TomKuc/ASV1/hardware/geometry_sources/KICAD_LIBRARY_ATTRIBUTION.md

# Biblioteki KiCad

Footprinty i modele wymienione w `imu_rf_geometry.json` pochodzą z oficjalnych bibliotek KiCad10.0.7, autorstwa społeczności KiCad. Zachowano nazwy źródeł, skrótySHA256 i odnośniki producentów.

Licencja: **Creative Commons Attribution-ShareAlike4.0**, z dodatkowym wyjątkiem KiCad dla projektów elektronicznych i generowanych plików.

- Zasady i tekst wyjątku: https://www.kicad.org/libraries/license/
- Tekst licencji: https://creativecommons.org/licenses/by-sa/4.0/legalcode
- Źródła footprintów: https://gitlab.com/kicad/libraries/kicad-footprints
- Źródła modeli: https://gitlab.com/kicad/libraries/kicad-packages3D

Adaptacje w tym projekcie: lokalne ścieżki modeli; U4: miedź0.575×0.35mm, pasta-0.05 i centralny TOP keepout. Dokumentacja: `docs/footprint_review.md`.
