TomKuc/ASV1/docs/audit_A1_2026-10-29.md

# Ankle Sensor V1 — audyt A1, 29.10.2026

**Dokument historyczny poprzedniego audytu.** Bieżące źródła, wyniki i warunki zamówienia określa [końcowa weryfikacja](final_verification_A1.md).

**Stan: A1 AUDIT REVIEW. Nie jest to zwolnienie do produkcji ani wynik testów urządzenia. Pamięć pozostaje W25Q01JVZEIQ 128 MiB.**

Punkt odniesienia to repozytorium [TomKuc/ASV1](https://github.com/TomKuc/ASV1), commit `c353696`, oraz poprowadzona płytka SHA256 `b5487d09753bbf0490bf91bda6c803934609b778283ef87c044309bc1514f678`. Zabezpieczenie: [archiwum sprzętu](../reports/baselines/A1_routed_before_audit_2026-10-29.zip) i [manifest](../reports/baselines/A1_before_audit_manifest.json). Nie uruchamiano destrukcyjnego odtwarzania PCB. Oryginalne A0/A1 ZIP zachowano.

Końcowe hashe i natywne wyniki są w [validation_status.json](../reports/validation_status.json). Zmiany w źródłach, raportach i eksportach wymienia [audit_changed_files.txt](../reports/audit_changed_files.txt). Identyfikator przygotowanego commita podaje `reports/commit_delivery.json`, dostarczany obok ZIP/Git bundle po zapisaniu historii; główny `.git` jest w tym środowisku chroniony przed zapisem. [Instrukcja importu](git_delivery_A1.md) wyjaśnia tę formę przekazania. Bundle i plik z jego hashem nie są rekurencyjnie dołączane do własnego commita ani ZIP.

## Ocena zgłoszonych zagadnień

Ważność H oznacza wpływ na ładowanie, integralność danych lub interfejs; M oznacza ryzyko produkcyjne albo utrzymania projektu. Nie każda pozycja H jest wykrytym błędem elektrycznym.

| ID / ważność / lokalizacja | Ustalenie | Decyzja i dowód |
|---|---|---|
| MEM01 H — U5 / nRF QSPI | Organizacja2×64MiB, liniowe128MiB, zakres0…07FFFFFF i zgodny mechanizm czterobajtowy potwierdzone dokumentami. | Zachowano dokładny MPN, footprint, pinout i3V. [Audyt Flash](flash_compatibility_A1.md), Winbond RevE i Nordic QSPI. Nie oznacza kwalifikacji docelowego drivera. |
| MEM02 H — sterownik Flash | Odczytany Zephyr/nrfx nie ma gotowej polityki obu dies; samo ADDRMODE32 nie zamyka SR/BUSY/WEL i operacji globalnych. IQ ma QE stałe1. | Własna serializowana warstwa, bez XIP na czas sterowania pamięcią; jawne per-die statusy i rozróżnienie READY od zakończenia zapisu. [Architektura i źródła](flash_compatibility_A1.md). |
| MEM03 H — C2/reset/DPD | Datasheet wymienia C2+Die ID; bajty00/01 i polling obu dies potwierdza primary implementacja Linuxv6.17. Pełna AN0000035 nadal niepozyskana. | Nie podano nieudokumentowanej gwarancji resetu ani selekcji w busy. Wymagane wyjaśnienie producenta i20 prób [F01–F20](flash_firmware_test_plan_A1.md), wszystkie NOT_RUN. |
| USB01 H — U3.28/30/31/32 | VDD=VDDH=3V, DCCH NC i osobny VBUS są właściwe dla normal voltage mode/niewykorzystanego REG0. | Brak zmiany topologii. Nordic POWER i oficjalne wsparcie; pełny obraz Raytac§8.3/capy pozostaje do sprawdzenia. [Raport](usb_raytac_audit_A1.md). |
| USB02 M — D+/D− | Nie potwierdzono zarzutu braku wymaganych zewnętrznych rezystorów USB; nRF52840 zawiera je w PHY. | Nie dodawano przypadkowych22/27Ω. Oficjalne wyjaśnienie Nordic w [raporcie USB](usb_raytac_audit_A1.md). |
| USB03 H — U6/J1 | Poprawna pinmapa kanałów ESD; w bazie długie18.7/20.6mm odcinki przed ochroną. To słabość layoutu, bez deklaracji sztywnego limitu mm. | Przesunięto U6/R25 i lokalne końcówki USB. Przed ESD jest teraz12.997/15.552mm; koszt to dodatkowe2vias DP_CONN. Nadal wymagana kwalifikacja ESD/SI; ST USBLC6-2§2.3. |
| USB04 H — stackup / cały tor USB | Oferta4L/1mm istnieje, lecz zastany PCB ma ogólny stos KiCad. Nie ustalono90Ω na konkretnej konstrukcji JLC. | Nie wpisano zgadywanych dielektryków. Wymagana oferta stackupu i ocena całego toru. [Raport USB](usb_raytac_audit_A1.md), [return path](usb_layout_review.md). |
| IMU01 M — docs vs U4/U3 | Potwierdzony błąd dokumentacji: wcześniejsze P0.24/25 nie odpowiadało PCB. | INT1=U3.27/P0.11, INT2=U3.29/P0.12. Poprawiono dokumenty, bez zmiany tras. [Ostateczne61padów](pin_assignment_A1.md). |
| DFM01 M — U5.7 |0.090001mm było prawdziwym nominalnym odstępem, bez nominalnego overlap. Mała rezerwa procesu jest ryzykiem, nie dowodem zwarcia. | Via przesunięta o0.14mm; odstęp0.230001mm. Analogiczne miejsce J1 VBUS poprawiono0.105→0.175mm. [Geometria i źródła JLC](dfm_audit_A1.md). |
| CHECK01 M — profil DRC | Pięć klas było ignorowanych; po włączeniu wykryto11 off-center endpoint warnings. | Lokalne dopasowania końców≤0.071mm; wszystkie klasy pozostają aktywne. Żadnego pełnego reroutingu. [Przegląd każdej klasy](erc_drc_audit_A1.md). |
| CHECK02 M — profil ERC/U4.2/3 | Cztery ignorowane klasy ERC nie ujawniły kolejnych problemów. Dwa widoczne ostrzeżenia IMU są właściwe dla mode1 z wyłączonym Qvar/analog hub. | Wszystkie klasy aktywne; nie wyciszano ostrzeżeń ani nie zmieniano typu pinów. ST DS13511 tabela2/§7.1 i [raport kontroli](erc_drc_audit_A1.md). |
| PWR01 H — U4/U5 / PDN | Lokalne drogi odsprzęgania zweryfikowano na rzeczywistym Cu; mostek Flash B.Cu z wcześniejszej A1 jest obecny. | Nie usunięto mostka ani kondensatorów. To geometria i ciągłość, nie pomiar ripple. [Audyt zasilania](power_audit_A1.md). |
| PWR02 H — R24/Q2/CE | Bazowy pull-down pozwalał na zwolnienie inhibit po resecie/HiZ MCU, co osłabiało politykę USB suspend. | R24=100k przeniesiony z GND na3V0. HIGH/HiZ/reset blokuje; LOW zwalnia do U7/U8. Cena: brak autonomicznego ładowania przy niesprawnym MCU. U7/U8 pozostają nadrzędne. [Raport](power_audit_A1.md). |
| PWR03 H — cały USB VBUS | ILIM100mA BQ nie ogranicza bezpośredniej gałęzi VBUS modułu ani gwarantowanego sumarycznego prądu portu. | Pozostaje pełny budżet, enumeracja/suspend/inrush i jawna polityka adapterów. Timeout nie oznacza DCP/BC1.2. [Kontrakt FW](firmware_contract.md). |
| PWR04 H — timer / NTC |360min jest wartością typową; CE może restartować timer. Część22mV budżetu komparatora jest założeniem, nie gwarantowanym maksimum CMRR/PSRR. | Poprawiono twierdzenia i opis obliczeń. Nie resetować timera cyklicznie. Potrzebna kwalifikacja dokładnego pakietu/NTC i progów. [Źródła TI i założenia](power_audit_A1.md). |
| PWR05 M — pobór okna | Oczekiwane138µA w standby oznacza około3.32mAh/dobę; jest to oszacowanie, nie stały pobór we wszystkich trybach. | Ochronę zachowano. Koszt uznano za uzasadniony dla A1; podczas USB LOW/release dochodzi prąd pull-up. [Bilans stanów](power_audit_A1.md). |
| RF01 H — antena / bateria | Keepout na wszystkich warstwach jest sprawdzalny w CAD; położenia pakietu i obudowy nie ma w zespole. | Końcowy natywny odczyt wypełnień potwierdził0mm² naruszeń. Dalej RF na nodze. Bateria/metal poza anteną; nie wydano certyfikatu RF. [Raport](usb_raytac_audit_A1.md). |
| MECH01 M — U4 / mocowanie | Poprawna geometria odległości i centralny TOP keepout nie jest analizą naprężeń. | Sztywne podparcie bez docisku IMU; kwalifikacja po reflow i zamknięciu obudowy. USB-C3D nadal brak, Raytac generyczny. [Ograniczenia mechaniczne](mechanical_model_review.md). |

## Co zostało naprawione

- Ujednolicono pinmapę przerwań IMU z rzeczywistym schematem i PCB.
- Włączono wszystkie wcześniej ignorowane klasy ERC/DRC i wycentrowano11 końców ścieżek przy istniejących przelotkach.
- Lokalnie odsunięto dwa istniejące via przy Flash i USB; bez zmiany MPN, padów układów i średnic wiercenia.
- R24 zmieniono na pull-up, aby MCU reset/HiZ zachowywał blokadę ładowania.
- Poprawiono zbyt kategoryczne interpretacje timera, budżetu komparatora, standby i zgodności standardowego sterownika Flash.

Przyjęto lokalny wariant USB: U6=(71.6,93.3), R25=(74.8,92.2). Niezależny odczyt potwierdził skrócenie odcinków przed ESD o30.6%/24.4% i lokalnej drogi GND U6 do via do0.938mm z połączeniem do In1. Dodatkowe2vias na DP_CONN są kosztem tej zmiany. Nie jest to potwierdzenie odporności IEC ani impedancji. Główny przebieg USB do y=86.8 zachowano; poza opisanymi poprawkami nie odtwarzano całego routingu. [Dziennik scalania](../reports/audit_merge_final_A1.json): poprawki root20 zmodyfikowanych obiektów Cu i R24, wariant USB111 usuniętych/2 zmodyfikowane/145 dodanych obiektów Cu oraz przesunięcie U6/R25. Finalnie164 przelotki. Dokument wejściowego placement poprawiono również dla obrotu Y1, aby zgadzał się z istniejącym PCB.

## Wyniki po scaleniu

KiCad10.0.7 wykonał natywne ERC i DRC po refill/save z kontrolą zgodności schemat–PCB. **ERC:0 błędów,2 uzasadnione ostrzeżenia; DRC:0 naruszeń/ostrzeżeń,0 niepołączonych elementów,0 rozbieżności schemat–PCB. Brak ignorowanych klas.** Ponowny audyt164 przelotek/255 padów Cu/243 apertur pasty:0 przecięć, minimum0.150001mm. Native RF fill:0mm² w zadeklarowanym keepout. Eksporty zawierają11 Gerberów,2 Excellon oraz59 pozycji montowanych na TOP; współrzędne/rotacje,164 wiercenia via,4 sloty PTH i2 NPTH porównano z natywnym PCB. To kontrola spójności plików, nie niezależny CAM ani akceptacja fabryki. PDF/STEP/render zostały odświeżone; STEP jawnie pozostaje niekompletny. [Walidacja](../reports/validation_status.json), [eksport](../manufacturing/review/export_manifest.json), [porównanie produkcyjne](../reports/manufacturing_geometry_review.json).

## Kontrole dostępne teraz i próby po wykonaniu prototypów

| Teraz — dokumentacja/CAD/pliki | Po otrzymaniu prototypów |
|---|---|
| Natywny ERC/DRC, zgodność schemat–PCB i manifestu |20 testów Flash F01–F20, identyfikacja, aliasing16/32/64/128MiB, CRC, erase obu dies, power-cut |
| Nominalne Cu/paste/mask i geometria wierceń | Pomiar VCC, ripple, tętna obciążenia, progu zakończenia zapisu przed2.7V |
| Obecność odsprzęgania i lokalne drogi zapisanej miedzi | Reset MCU i Flash, wake/DPD, watchdog podczas program/erase |
| Keepout RF i przestrzeń IMU w istniejącym PCB | ODR/FS/filtry/FIFO, temperatura IMU, zgubione próbki i synchronizacja dwóch nóg |
| Eksport Gerber/Drill/CPL oraz porównanie współrzędnych z PCB | Cały USB: prąd we wszystkich stanach, suspend/inrush, transfer z CRC, ESD i jakość sygnału |
| Spójność BOM z59 pozycjami montażowymi; publiczny katalog JLC | Pakiet/PCM/NTC, zwarcie/przerwa NTC, startup/brownout, ładowanie i termika w obudowie |
| Obliczenie warunkowego modelu temperatury, bez symulacji SPICE | Szum/bias MEMS, naprężenia po montażu, zasięg BLE i praca w opasce |

Nie wykonano testu sprzętowego ani symulacji działania całego urządzenia. Syntetyczne testy API geometrii i obliczenia statyczne są odrębnym rodzajem dowodu.

## Gotowość do dalszego przeglądu i zamówienia

Paczka ma służyć **niezależnemu przeglądowi inżynierskiemu oraz DFM/PCBA JLCPCB** z jawną listą ograniczeń. Nie wolno utożsamiać akceptacji plików przez stronę zamówienia z poprawnością układu ani integralnością danych.

Przed decyzją o montażu prototypów: uzyskać konkretny stackup i ocenę toru USB; porównać rysunki Raytac§8.3 i footprintów/capów; potwierdzić dokładny BOM i dostępność, panelizację/fiducjale, maskę/szablon i rotacje. [Stan publicznych katalogów](component_availability_A1.md) wskazuje dla IMU Standard Only i X-ray; Raytac i BQ nie mają potwierdzonej rezerwacji. Nie dobrano zamienników.

Plan F01–F20 nie może zostać zamknięty bez prototypów. Utrzymanie128MiB jest świadomą decyzją z warunkiem własnej warstwy sterownika i pozyskania AN0000035/wyjaśnienia Winbond. Można prowadzić przegląd DFM równolegle do tej pracy; nie ma podstaw do deklaracji pełnej gotowości urządzenia do badań lub seryjnej produkcji.
