TomKuc/ASV1/docs/memory_upgrade.md

# Większa pamięć bez zwiększenia obrysu PCB — 2026-10-27

Rekomendowany kandydat dla aktualnego projektu: **W25Q01JVZEIQ, 1 Gbit = 128 MiB, JLCPCB C5137036**. Pamięć ma korpus 8 × 6 mm, a więc mieści się w tej samej rezerwacji powierzchni co W25Q512JVEIQ. Publiczny katalog JLCPCB potwierdza montaż Economic and Standard, MSL3 i pokazał 264 sztuki / 260 dostępnych do zamówienia przy cenie jednostkowej około 36,48 USD. To odczyt katalogu, bez rezerwacji ani wyceny konkretnego zamówienia. [JLCPCB C5137036](https://jlcpcb.com/partdetail/WinbondElec-W25Q01JVZEIQ/C5137036), [LCSC C5137036](https://www.lcsc.com/product-detail/C5137036.html).

Pinout WSON8: 1 /CS, 2 IO1, 3 IO2, 4 GND, 5 IO0, 6 CLK, 7 IO3, 8 VCC. Zasilanie 2,7–3,6 V; QE dla IQ jest ustalone na 1. Rysunek package ZE podaje raster 1,27 mm i mały EP 3,40 × 4,30 mm, który może pozostać niepodłączony albo być połączony z GND. Pamięć obejmuje dwie matryce 512 Mbit z liniowym adresem 0x00000000–0x07FFFFFF. Obsługuje EN4B 0xB7 i instrukcje 0x6B / 0x32 z czterobajtowym adresem, zgodne z zestawem nRF52840 QSPI. Pady i wymiary trzeba ponownie porównać z biblioteką; zgodność powierzchni nie zastępuje tego sprawdzenia. [Winbond W25Q01JV Rev C, dokument producenta u LCSC](https://datasheet.lcsc.com/datasheet/pdf/4186e2255e7f268d6b3a94cd6df0aac8.pdf?productCode=C6926235), [nowszy Rev E z 2024-03-04, dokument producenta u Mouser](https://www.mouser.com/datasheet/2/949/Winbond_Electronics_Corporation_09_06_2024_W25Q01J-3501286.pdf).

**To wymaga obsługi dwóch matryc w firmware.** Odczyt BUSY/SUS odnosi się do aktywnej matrycy, a operacje globalne mogą dotyczyć obu. Datasheet zawiera Software Die Select 0xC2 i odsyła do **AN0000035 W25Q01JV SpiFlash Stacked Die Usage**. Oficjalny katalog Winbond oznacza notę jako „contact us”; jej pełnej treści nie pozyskano. Nie deklarować poprawności gotowego sterownika tylko na podstawie obsługi 32-bitowych adresów. [Oficjalny katalog not Winbond](https://www.winbond.com/hq/support/documentation/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), [oficjalne FAQ wskazujące AN0000035](https://www.winbond.com/hq/support/faq/technical/index.html).

Wymóg odbiorczy projektu: sprawdzać oba dies po zapisach statusu i innych operacjach globalnych, testować program/erase/read poniżej i powyżej 0x04000000, po resecie MCU, resetach flash, deep power-down i pełnym power-cycle. Nie korzystać z domyślnego sterownika bez potwierdzenia obsługi tej pamięci. Jako pomocnicze źródło implementacyjne dostępny jest upstreamowy sterownik Linux rozpoznający liczbę matryc oraz wybierający matryce do sprawdzenia statusu; nie jest to sterownik nRF52840. [Źródło Linux spi-nor/winbond.c](https://kernel.googlesource.com/pub/scm/linux/kernel/git/next/linux-next/+/ba80ab075acc1d265df25a2de31dfb358ca2ad44/drivers/mtd/spi-nor/winbond.c).

Obliczenie pojemności, bez gwarancji użytkowej: przy 1920 Hz i 12 B na próbkę 128 MiB wystarcza na 97,1 min; przy 14 B/próbkę na około 83,2 min przed temperaturą, timestampami, nagłówkami, CRC, rezerwą i dziennikiem. Każda noga ma własną pamięć o tej pojemności.

## Kandydaci 256 MiB

| Układ | Wynik weryfikacji |
|---|---|
| W25Q02JVTBIM | 2 Gbit = 256 MiB, ale potwierdzony wariant TFBGA24, nie zamiana do WSON8. [Datasheet producenta przez MikroE](https://download.mikroe.com/documents/datasheets/W25Q02JV%20Datasheet.pdf) |
| **W25Q02JVSFIM** | **256 MiB, SOIC16 300 mil**, rzeczywisty wariant wymieniony w nowszym datasheet producenta Rev C z 2023-03-29, s. 109; tę obudowę dodano w tej rewizji. Raster 1,27 mm, korpus typ. 10,31 ×7,49 mm, szerokość z wyprowadzeniami typ. 10,31 mm, wysokość maks. 2,64 mm (s. 106). **Numeru JLCPCB/LCSC C nie potwierdzono** mimo wyszukiwania dokładnego MPN i wariantu TR. Nie wpisywać zgadywanego numeru do BOM. [Dokument Winbond Rev C przez Marthel](https://www.marthel.pl/katalog/W25Q02JV_DTR%20RevC%2003292023.pdf) |
| MT25QL02GCBB8E12-0SIT | Oficjalny katalog Micron podaje TBGA 6 × 8 × 1,2 mm i cztery komponenty wewnętrzne; oznaczenie 8E12 nie oznacza obudowy WSON8. [Micron](https://in.micron.com/products/storage/nor-flash/serial-nor/part-catalog/part-detail/mt25ql02gcbb8e12-0sit) |
| W25Q02RVZHJQ / W25Q02RVZHJM | Nowa seria oferuje 2 Gbit w VSON8 8 × 6 mm. Wariant **ZH** trzeba zweryfikować mechanicznie i elektrycznie; brak potwierdzonego numeru JLCPCB/LCSC i dostępnego zapasu w tym przeglądzie. To perspektywa dalszego doboru, nie zamawialny zamiennik w aktualnym BOM. [Oficjalny Winbond RV product brief 2026](https://www.winbond.com/productResource-files/Winbond%20W25Q-RV%20Series%20Flash%20Product%20Brief%202026.pdf), [datasheet Winbond Rev E 2026-02-12 przez DigiKey, tabela p196](https://mm.digikey.com/Volume0/opasdata/d220001/medias/docus/8919/W25Q33_64_12_25_51_01_02RV-DTR_RevE.pdf) |

Nie zastępować NOR pamięcią SPI NAND tylko dlatego, że ma podobną obudowę lub pojemność. NAND wymaga innego zestawu poleceń, pracy stronicowej, ECC i obsługi złych bloków; nie jest przezroczystym zamiennikiem dla tej architektury QSPI NOR. W tym przeglądzie nie potwierdzono zamawialnej 256 MiB NOR z pełną zgodnością obecnego footprintu WSON8.

Większa obudowa SOIC16 **nie przesądza o konieczności powiększenia PCB 50 ×28 mm**. Wymaga próbnego rozmieszczenia, własnego footprintu i innego mapowania pinów, a także sprawdzenia wysokości w obudowie. W25Q02JVSFIM: 1 IO3, 2 VCC, 3 /RESET, 4–5 NC, 6 DNU, 7 /CS, 8 IO1, 9 IO2, 10 GND, 11 DNU, 12–14 NC, 15 IO0, 16 CLK. Piny DNU pozostawić bez połączenia. Układ ma cztery matryce po 64 MiB i liniową przestrzeń 0x00000000–0x0FFFFFFF, lecz ciągły odczyt ograniczono do poszczególnych segmentów 64 MiB; firmware musi dzielić odczyty na ich granicach i obsługiwać stan każdej matrycy. Parametry zasilania 2,7–3,6 V pasują do szyny 3,0 V. To kandydat dalszego doboru po potwierdzeniu zakupów, bez zatwierdzonej zgodności sterownika nRF52840. [Winbond Rev C, s. 6, 8 i 106](https://www.marthel.pl/katalog/W25Q02JV_DTR%20RevC%2003292023.pdf).
