TomKuc/ASV1/docs/router_limitations.md

# Router pomocniczy KiCad — 2026-10-28

`scripts/route_pcb.py` zapisuje rzeczywiste obiekty ścieżek i przelotek przez API `pcbnew` KiCad 10.0.7. To narzędzie do przygotowania części routingu, bez gwarancji pełnego połączenia płytki ani poprawności DRC.

```sh
KICAD_CONFIG_HOME=/tmp/ankle-kicad-route /Applications/KiCad/KiCad.app/Contents/Frameworks/Python.framework/Versions/3.9/bin/python3 -B scripts/route_pcb.py INPUT.kicad_pcb OUTPUT.kicad_pcb --stats reports/routing.json --plane-net GND --plane-net +3V0 --max-seconds 600
```

`--plane-net` podaje się osobno dla każdej sieci, która ma być połączona przez rzeczywiste strefy miedzi. Domyślnie jest to tylko GND. Router przygotowuje połączenie padu z przelotką; **nie tworzy i nie wypełnia stref**. Bez stref i ich późniejszego wypełnienia takie połączenia pozostają niekompletne. Przelotka może być wykorzystana ponownie; otwartych przelotek w padach nie stosuje się.

Parametry domyślne: siatka 0,10 mm, clearance 0,15 mm, ścieżka 0,15 mm, przelotka 0,50 mm z otworem 0,25 mm, odstęp miedź–krawędź 0,30 mm. Odstęp krawędź–krawędź otworów wynosi co najmniej **max(0,25 mm, minimum projektu)**, również dla tej samej sieci. Dla dwóch nowych otworów Ø0,25 mm daje to odległość osi ≥0,50 mm. Używa się natywnych kształtów otworów, obejmujących również sloty. Identyczna istniejąca przelotka może być ponownie użyta; nie wykonuje się drugiego otworu w tej samej pozycji. Kontrola obejmuje także pary nowych przelotek jednej proponowanej trasy. **Nie naprawia to wcześniejszych zbyt bliskich otworów w wejściowym PCB.** Są to parametry algorytmu, nie potwierdzony stackup lub wycena producenta. Router porównuje je z załadowanymi minimalnymi ograniczeniami i ostrzega w JSON o konfliktach. Nie zmienia reguł `.kicad_pro`. DRC należy wykonywać z właściwym projektem i regułami także po zmianie nazwy pliku wyjściowego.

VBUS, VSYS i VBAT mają domyślnie preferowaną szerokość **0,30 mm**. Przy padzie węższym niż ta wartość pierwsze/ostatnie **0,50 mm** trasy zachowuje podstawowe 0,15 mm. Dalsze fragmenty są poszerzane wyłącznie po sprawdzeniu natywnej geometrii i odstępu od krawędzi. Fragment, którego nie można poszerzyć, pozostaje 0,15 mm i jest zapisany jako `power_width_fallbacks`; raport zawiera długości per sieć i szerokość. To preferencja bez gwarancji pełnej szerokości magistrali zasilania. Możliwe ustawienia: `--preferred-width VBUS=0.30`, `--preferred-width VSYS=0.30`, `--preferred-width VBAT=0.30`, `--neckdown-length 0.50` oraz `--hole-clearance 0.25`.

Sygnały prowadzone są wyłącznie na F.Cu, B.Cu oraz In2.Cu. In1.Cu pozostaje przeznaczona na masę; przez nią przechodzą zwykłe przelotki, a strefa GND musi otrzymać prawidłowe antypady. Zastosowano rzeczywiste stałe API KiCad 10: F.Cu=0, B.Cu=2, In1.Cu=4, In2.Cu=6. Nie tworzy się ścieżek na In1.Cu.

Przeszkody obejmują kształty padów, NPTH, istniejące ścieżki i przelotki innych sieci, granicę rzeczywistego zamkniętego obrysu, keepouty płytki i footprintów. **In2.Cu jest mieszana: sygnały i zasilanie.** Jej zwykła strefa zasilania nie blokuje routingu; natywne ponowne wypełnienie tworzy wymagane prześwity. Istniejące zwykłe strefy na F.Cu/B.Cu nadal blokują ścieżki innych sieci. Wszystkie rzeczywiste pady, ścieżki, przelotki oraz keepouty pozostają przeszkodami również na In2. Warstwy masy i zasilania wymagają późniejszego wypełnienia i ponownej kontroli łączności. Obszary niedopuszczające ścieżek/przelotek są respektowane według flag KiCad. Raster zawiera konserwatywny zapas od połowy przekątnej komórki, a proponowane odcinki są dodatkowo sprawdzane z natywną geometrią przed zapisem.

**Hole-to-copper jest osobnym ograniczeniem:** router odczytuje `m_HoleClearance` z projektu i stosuje ten prześwit względem rzeczywistego kształtu otworu, niezależnie od clearance sieci. Dotyczy to także przelotek i poszerzonych ścieżek oraz każdego poziomu miedzi przecinanego przez otwór. NPTH zawsze blokuje miedź; połączenia tej samej sieci z metalizowanym otworem są dozwolone. Kontrola drill-to-drill pozostaje niezależna i obowiązuje także tę samą sieć.

Router może rozpoczynać i kończyć wyszukiwanie również w miedzi przelotek **już połączonych z danym padem**, co potwierdza natywne `GetConnectedItems(pad)`. Nie wystarcza sama zgodność nazwy sieci. W takim przypadku zachowuje istniejące wyjście z padu i **nie rysuje skrótu od środka padu do kotwicy**. Pozwala to wykorzystać wcześniej przygotowane wyjścia z drobnych padów, nawet gdy konserwatywny raster blokuje ich środki. Użyte kotwice zapisuje w `connected_via_anchor_uses`. Każda nowa przelotka ma ustawione zakrycie soldermaską z obu stron; istniejących przelotek narzędzie nie zmienia.

Pozycje kandydatów przelotek do stref są buforowane jako offsety w porządku `(d², dx, dy)`. Sprawdzanie kończy się po znalezieniu pierwszych 24 legalnych pozycji, zachowując ten sam wybór co pełne skanowanie i późniejsze sortowanie całego promienia 3 mm.

Niektóre wyjścia z drobnych padów mogą być nieosiągalne na siatce 0,10 mm, mimo że ręczny routing jest możliwy. Dla U1 (pady 0,20 mm, raster 0,40 mm, ścieżka 0,15 mm i clearance 0,15 mm) środek trasy ma korytarz ±0,075 mm wokół osi padu. Konserwatywny guard siatki 0,10/√2 ≈0,0707 mm ogranicza go do około ±0,0043 mm. Przy siatce 0,05 mm zostaje około ±0,0396 mm, co ułatwia wyjście. Liczba stanów na tej samej powierzchni rośnie wtedy około czterokrotnie; limit rozwinięć należy odpowiednio zwiększyć, np. `--max-expansions 720000`. Narzędzie nie wykonuje shove, rip-up, optymalizacji długości, kontroli par różnicowych, impedancji, RF ani prądów zasilania. USB i QSPI wymagają przeglądu projektanta. Automatyczne pierwszeństwo tych sieci w kolejce nie jest ich kwalifikacją sygnałową.

Raport zawsze zawiera status `PARTIAL_REQUIRES_KICAD_DRC_AND_REVIEW`, każdą próbę połączenia, powód niepowodzenia, pozostałe rozłączne grupy padów, niepołączone wyjścia do stref oraz natywną liczbę airwire przed i po routingu **przed ponownym wypełnieniem stref**. Nie należy utożsamiać braku airwire z brakiem błędów DRC. Wejściowego PCB nie wolno nadpisać tym samym wywołaniem.

Wykonane sprawdzenia narzędzia: sześć testów wyszukiwania/planowania; osobna syntetyczna płytka `/tmp` z połączeniem dwóch padów; wariant z barierą na F.Cu wymagający dwóch przelotek i z dodatkowym wyjściem GND. Natywna łączność potwierdziła połączenie sygnału, a ponowny przebieg dodał zero duplikatów. DRC pierwszej syntetycznej płytki wykazał domyślne ograniczenie ścieżki 0,20 mm wobec zadanych 0,15 mm oraz opis przy krawędzi; nie wykazał zwarć, błędów odstępów ani niepołączonego sygnału. Dodatkowy natywny test otworów same-net odrzucił odległości osi 0,30/0,40 mm i dopuścił 0,50/0,60 mm oraz ponowne użycie istniejącej przelotki. Test zasilania z wąskim padem utworzył około 0,50 mm ścieżki 0,15 mm i resztę 0,30 mm, z zachowaniem natywnej łączności. Nie są to wyniki kontroli płytki Ankle Sensor.

`scripts/test_route_pcb_native.py` zawiera dodatkowe sześć testów: rzeczywiste wyjście pad→dogleg→via z zablokowanym skrótem, zwykłe pady, odrzucenie niepołączonej przelotki tej samej sieci jako kotwicy, identyczność kolejności zoptymalizowanych kandydatów, osobny hole-to-copper przy NPTH oraz dopuszczenie sygnału w zwykłym pour In2 przy zachowaniu keepoutu. Test NPTH odrzuca rzeczywisty odstęp 0,225 mm i dopuszcza 0,275 mm przy minimum 0,25 mm; wygenerowana trasa omija otwór zgodnie z tym ograniczeniem. Test z doglegiem sprawdza zachowanie miedzi istniejącego wyjścia, brak nowego odcinka do środka padu, brak ścieżek na In1.Cu, natywną łączność i tenting nowych vias. Testy budują osobne płytki w pamięci i nie otwierają canonical PCB projektu.
