TomKuc/ASV1/reports/Ankle_Sensor_V1_A1_3d_review.png

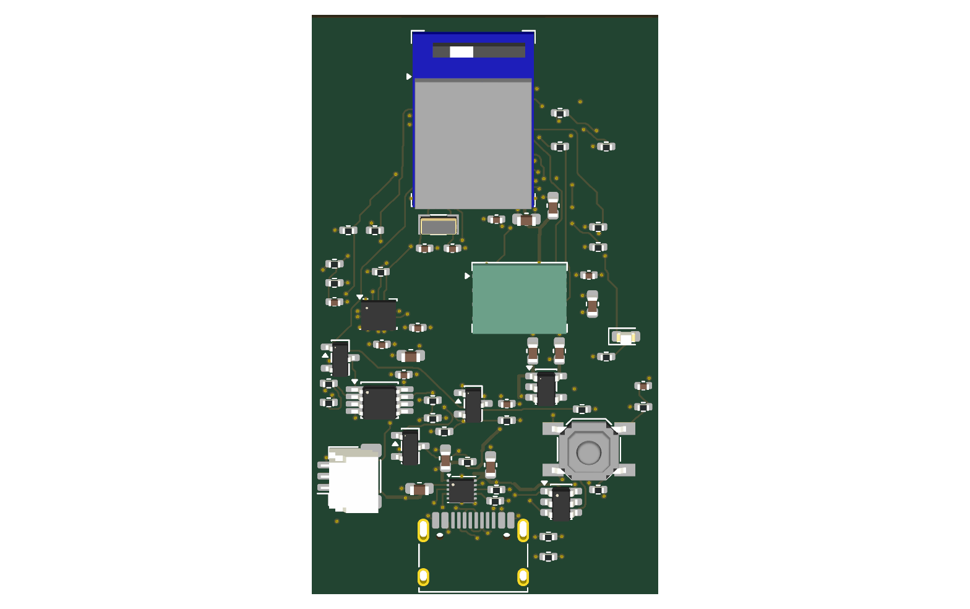
reports/Ankle_Sensor_V1_A1_3d_review.png
