TomKuc/ASV1/hardware/3dmodels/W25Q01JVZEIQ_ENVELOPE_MAX.step

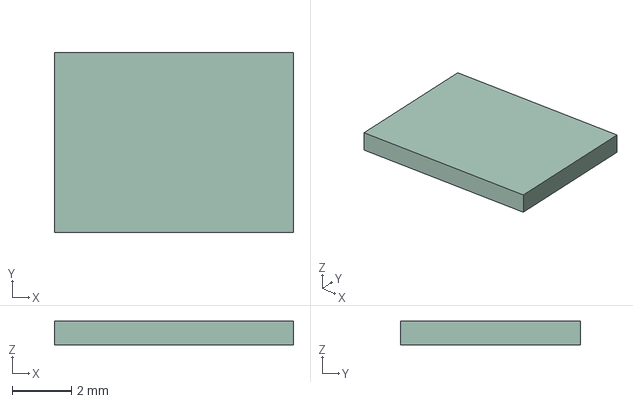
[picture p2: CAD file, 2026-10-29]
hardware/3dmodels/W25Q01JVZEIQ_ENVELOPE_MAX.step
8.10 x 6.10 x 0.8 mm
