TomKuc/ASV1/reports/Ankle_Sensor_V1_A1_mechanical_review.step

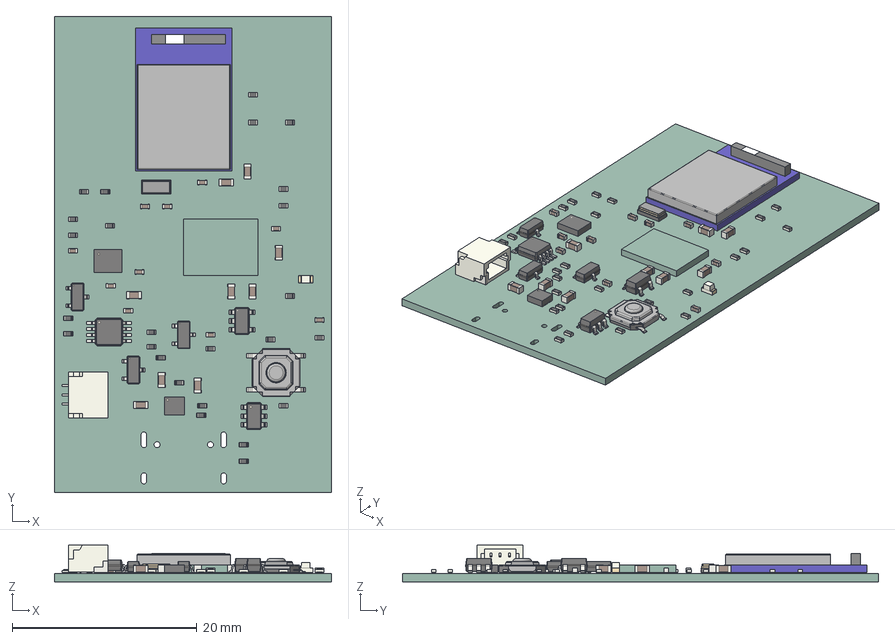
[picture p3: CAD file, 2026-10-29]
reports/Ankle_Sensor_V1_A1_mechanical_review.step
30.0 x 51.6 x 3.96 mm
SOT-23 x 3
C_0603_1608Metric x 9
R_0402_1005Metric x 25
SOT-23-6
VSSOP-8_3x3mm_P0.65mm
LGA_14_3x25mm_P05mm_LayoutBorder3x4y
Raytac_MDBT50Q
C_0402_1005Metric x 10
Texas_DLH0010A_WSON-10-1EP_2.2x2mm_P0.4mm_EP0.9x1.5mm
W25Q01JVZEIQ_ENVELOPE_MAX_PCB
Crystal_SMD_3215-2Pin_3.2x1.5mm
JST_SH_SM03B-SRSS-TB_1x03-1MP_P1.00mm_Horizontal
LED_0603_1608Metric
SOT-23-5
SW_SPST_SKQG_WithStem
Ankle_Sensor_V1_PCB
