TomKuc/ASV1/hardware/3dmodels/Button_Switch_SMD.3dshapes_SW_SPST_SKQG_WithStem.step

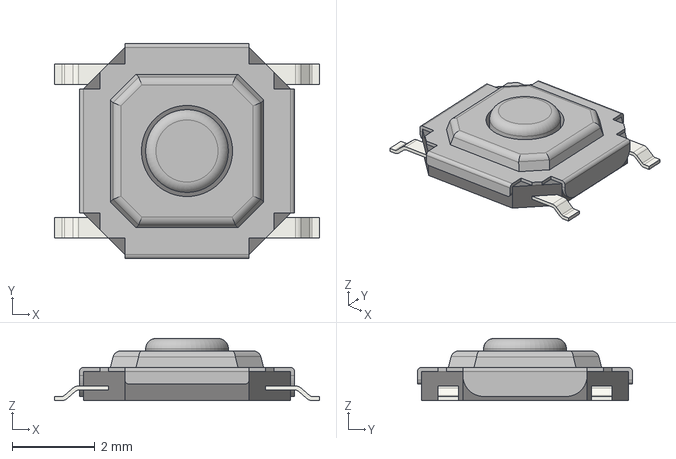
[picture p4: CAD file, 2026-10-29]
hardware/3dmodels/Button_Switch_SMD.3dshapes_SW_SPST_SKQG_WithStem.step
6.40 x 5.20 x 1.50 mm
