TomKuc/ASV1/hardware/3dmodels/Texas_DLH0010A_WSON-10-1EP_2.2x2mm_P0.4mm_EP0.9x1.5mm.step

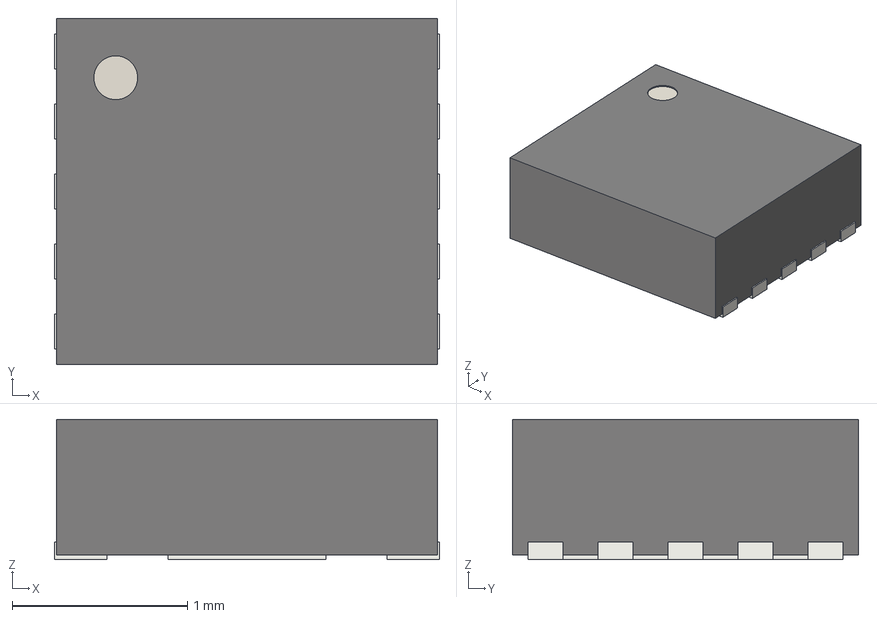
[picture p5: CAD file, 2026-10-29]
hardware/3dmodels/Texas_DLH0010A_WSON-10-1EP_2.2x2mm_P0.4mm_EP0.9x1.5mm.step
2.20 x 1.98 x 0.8 mm
