TomKuc/ASV1/reports/guide/ankle_sensor_przewodnik.html

To jest przewodnik po istniejącym projekcie, bez zmian w elektronice.
Kliknij opis na mapie lub przycisk poniżej, aby przeczytać funkcję elementu. Płytkę ustawiono portem USB na dole.

## Jak czytać projekt

Schemat opisuje elektryczne połączenia. PCB pokazuje fizyczne miejsca części i miedziane połączenia. Widok 3D ułatwia obejrzenie kształtu płytki i dostępnych modeli.

Plik / katalog | Do czego służy
.kicad_pro | Główne wejście do projektu w KiCadzie.
.kicad_pcb | Rozmieszczenie części, ścieżki, warstwy i obrys rzeczywistej PCB.
.kicad_sch | Schemat z blokami zasilania, procesora, sensorów, USB/UI i temperatury.
PDF schematu | Do przeczytania schematu bez uruchamiania KiCada.
BOM | Lista zakupowa części; MPN to oznaczenie producenta, numer C identyfikuje część w katalogu JLCPCB.
CPL / Pick and Place | Współrzędne i obroty części dla maszyny montażowej.
Gerber + Drill | Dane dla fabryki: wzory warstw oraz otwory i sloty.
STEP | Model do programu CAD przy projektowaniu obudowy. Obecny model ma ograniczenia opisane poniżej.

## Oznaczenia, które zobaczysz

U — układ scalony lub moduł; R — rezystor; C — kondensator; J — złącze; SW — przycisk; D — dioda; Q — tranzystor; Y — kwarc; TP — pole testowe. Liczba jest identyfikatorem części, np. U4 lub C15.

GND oznacza masę — wspólny punkt odniesienia napięć. +3V0 to zasilanie 3,0 V. Takie same nazwy sygnałów na schemacie oznaczają tę samą sieć, także pomiędzy arkuszami.

## Co oznacza wynik kontroli

ERC sprawdza reguły schematu, DRC reguły i połączenia PCB, a DFM możliwość wykonania i montażu w konkretnej fabryce. Obecny DRC: 0 naruszeń / 0 brakujących połączeń / 0 rozbieżności schemat–PCB. ERC: 0 błędów i 2 opisane ostrzeżenia IMU.

Stan A1: REVIEW, do dalszego sprawdzenia przed zamówieniem. Wynik DRC nie potwierdza fizycznego działania. Firmware jeszcze nie ma. Otwarte są m.in. przegląd zasilania referencyjnego Raytac, stackup i tor USB, kwalifikacja footprintów/DFM, dobór pakietu oraz testy prototypu. W STEP i renderze brakuje bryły USB-C; model Raytac jest ogólny, a Flash ma model gabarytowy.

Pełna lista warunków · Instrukcja widoku 3D KiCad (https://docs.kicad.org/10.0/en/pcbnew/pcbnew.html#threed-viewer)

Źródło położeń: odczyt rzeczywistego PCB A1; SHA256 cdcbd23449ce12977567ecdd061c598cc0dc2830e28d7cea8fada4b1bcea9e40 . Nowy przewodnik nie zmienia płytki ani wcześniejszej paczki A1 REVIEW.
