TomKuc/ASV1/reports/guide/mapa_plytki.png

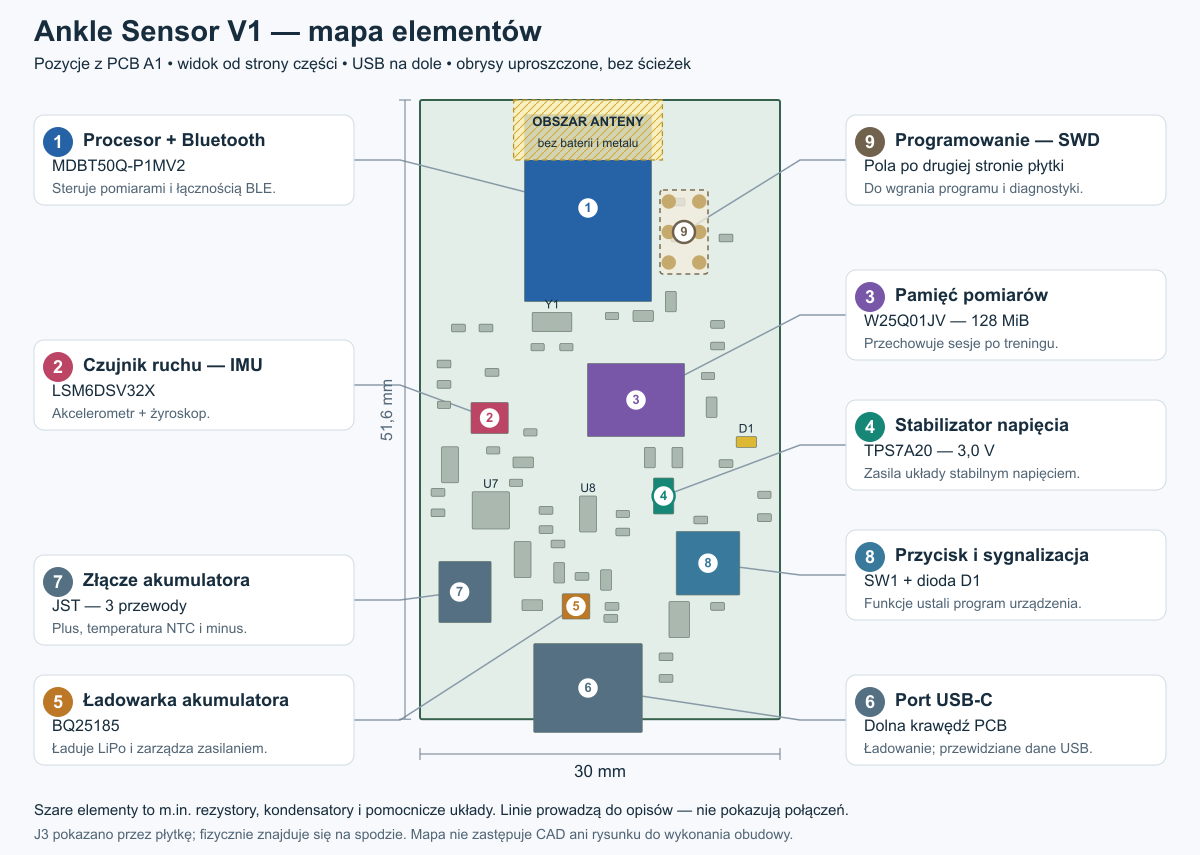
reports/guide/mapa_plytki.png
