TomKuc/ASV1/reports/Ankle_Sensor_V1_A1_schematic.pdf

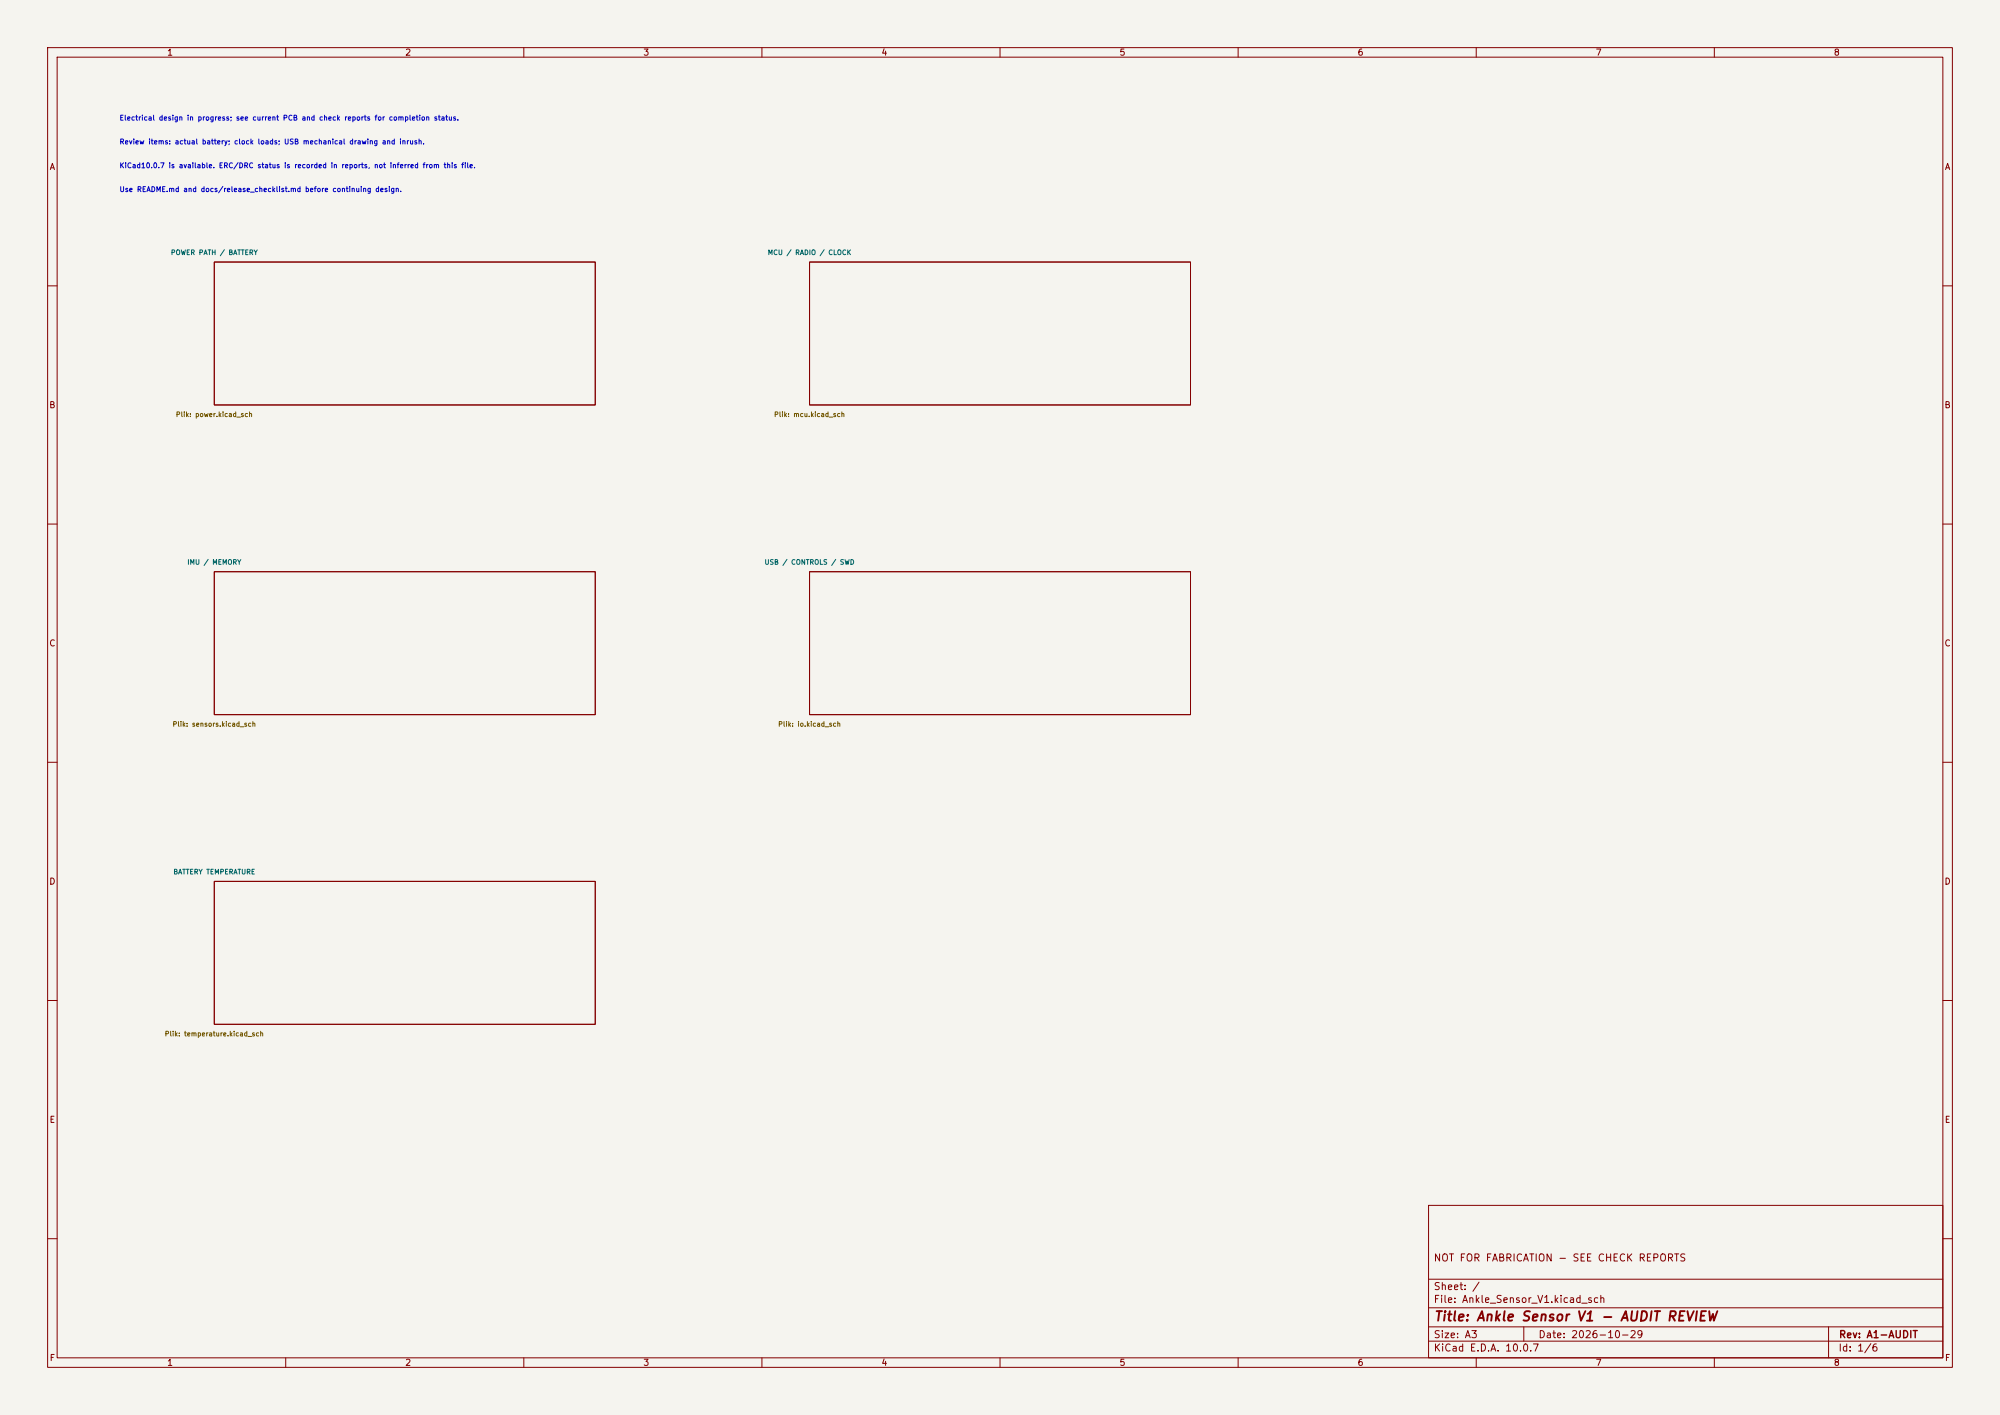
[picture p7: page 1]

Electrical design in progress; see current PCB and check reports for completion status. Review items: actual battery; clock loads; USB mechanical drawing and inrush. KiCad10.0.7 is available. ERC/DRC status is recorded in reports, not inferred from this file. Use README.md and docs/release_checklist.md before continuing design.

Plik: mcu.kicad_sch USB / CONTROLS / SWD

IMU / MEMORY Plik: sensors.kicad_sch BATTERY TEMPERATURE Plik: temperature.kicad_sch

NOT FOR FABRICATION - SEE CHECK REPORTS

Sheet: /
File: Ankle_Sensor_V1.kicad_sch
Title: Ankle Sensor V1 - AUDIT REVIEW

Size: A3 | Rev: A1-AUDIT | F Date: 2026-10-29
KiCad E.D.A. 10.0.7 | Id: 1/6

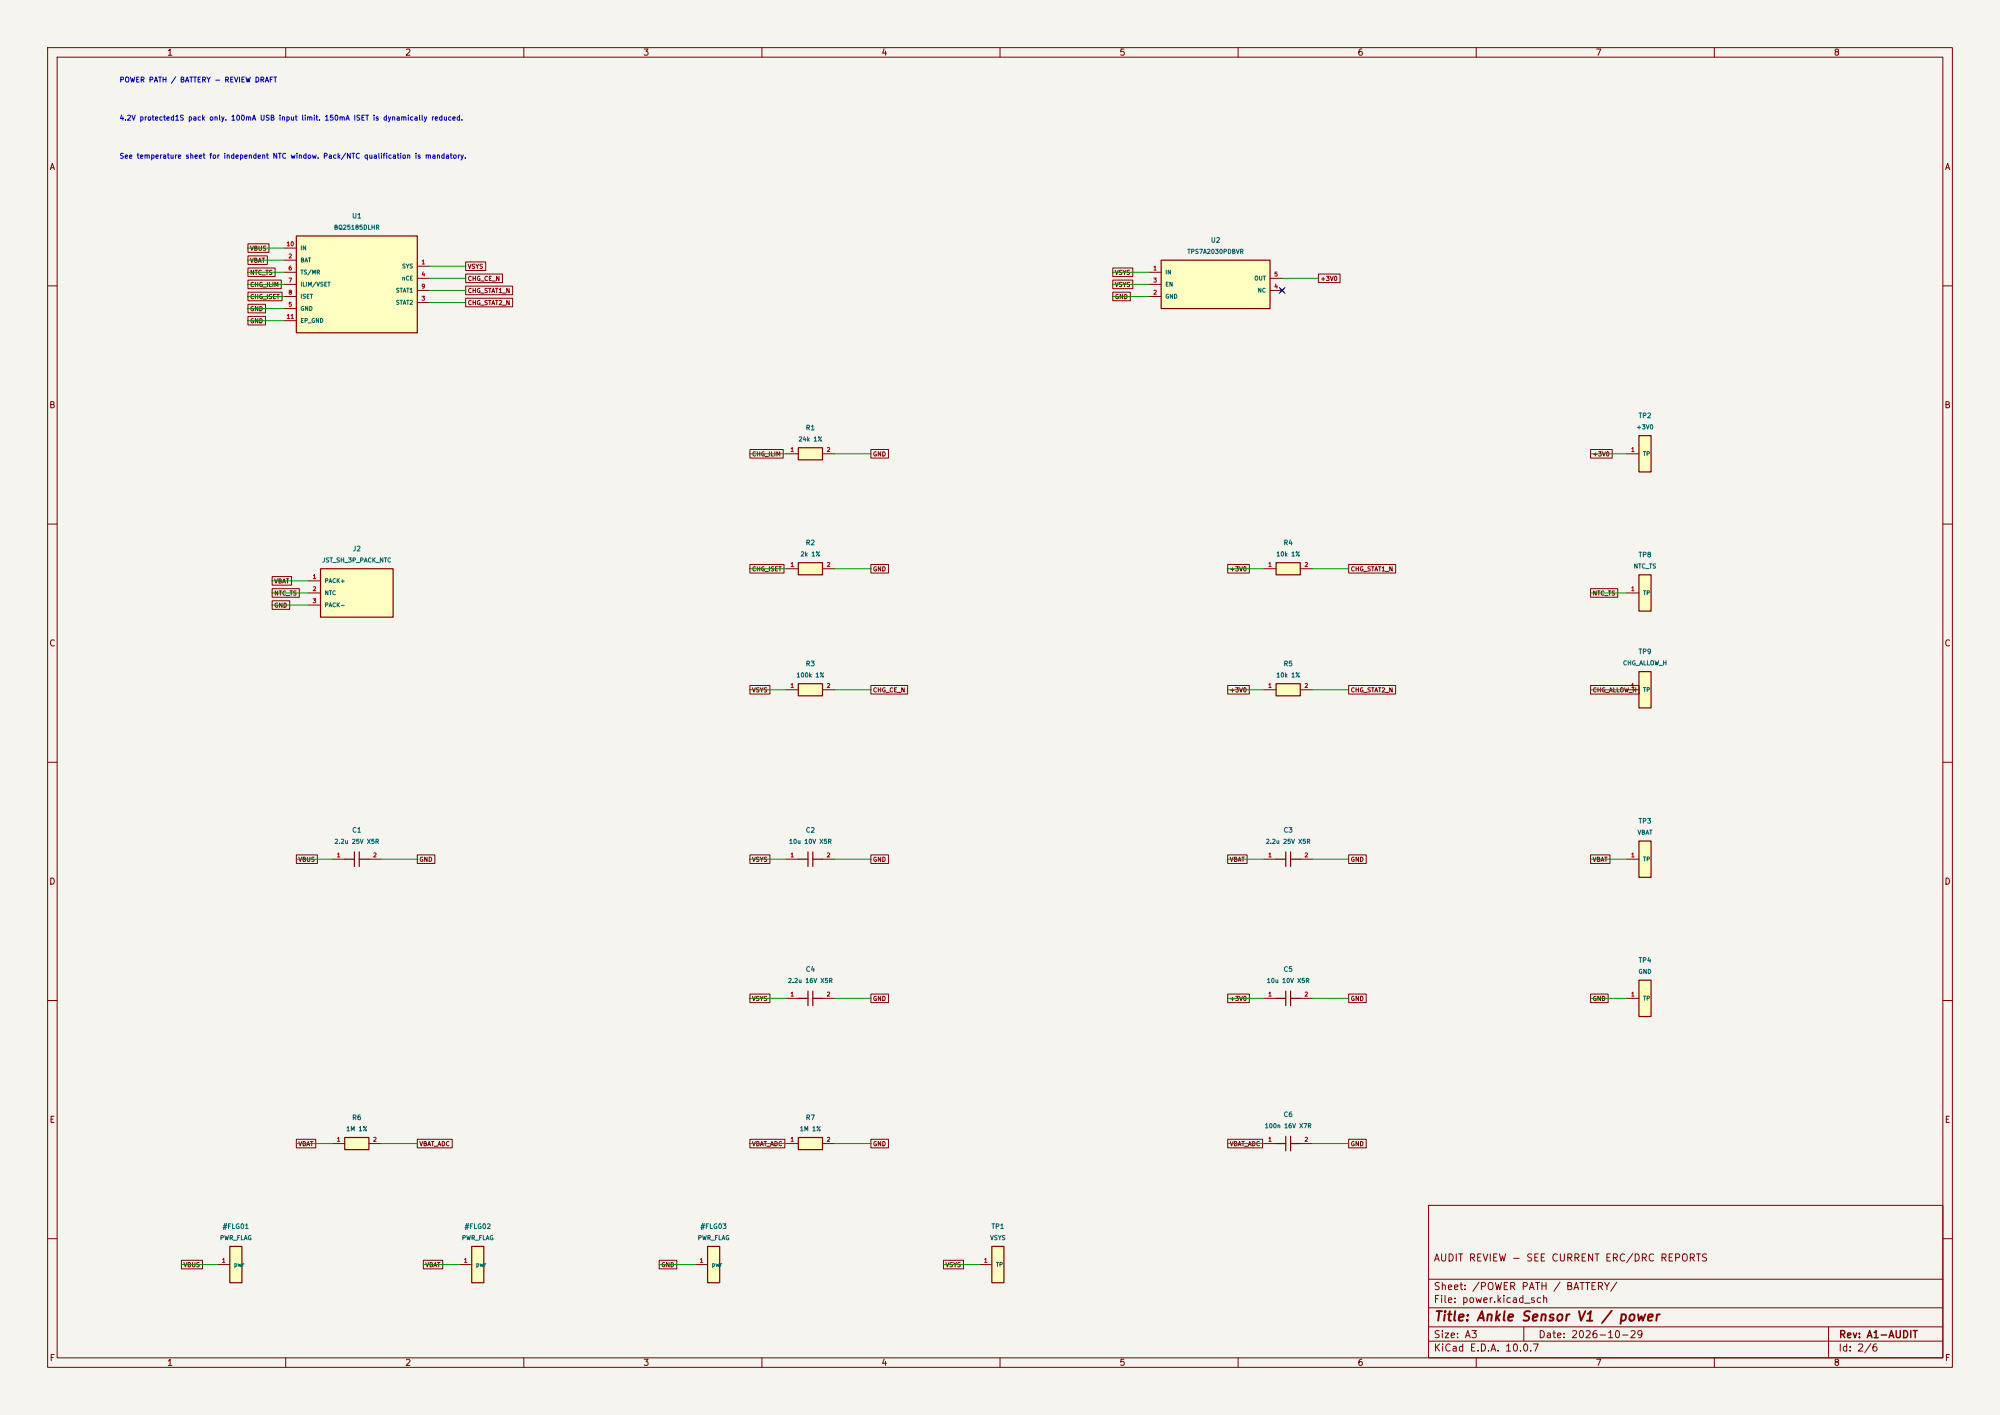
[picture p8: page 2]

VSYS See temperature sheet for independent NTC window. Pack/NTC qualification is mandatory. 4.2V protected1S pack only. 100mA USB input limit. 150mA ISET is dynamically reduced. POWER PATH / BATTERY - REVIEW DRAFT

AUDIT REVIEW - SEE CURRENT ERC/DRC REPORTS

Sheet: /POWER PATH / BATTERY/
File: power.kicad_sch
Title: Ankle Sensor V1 / power

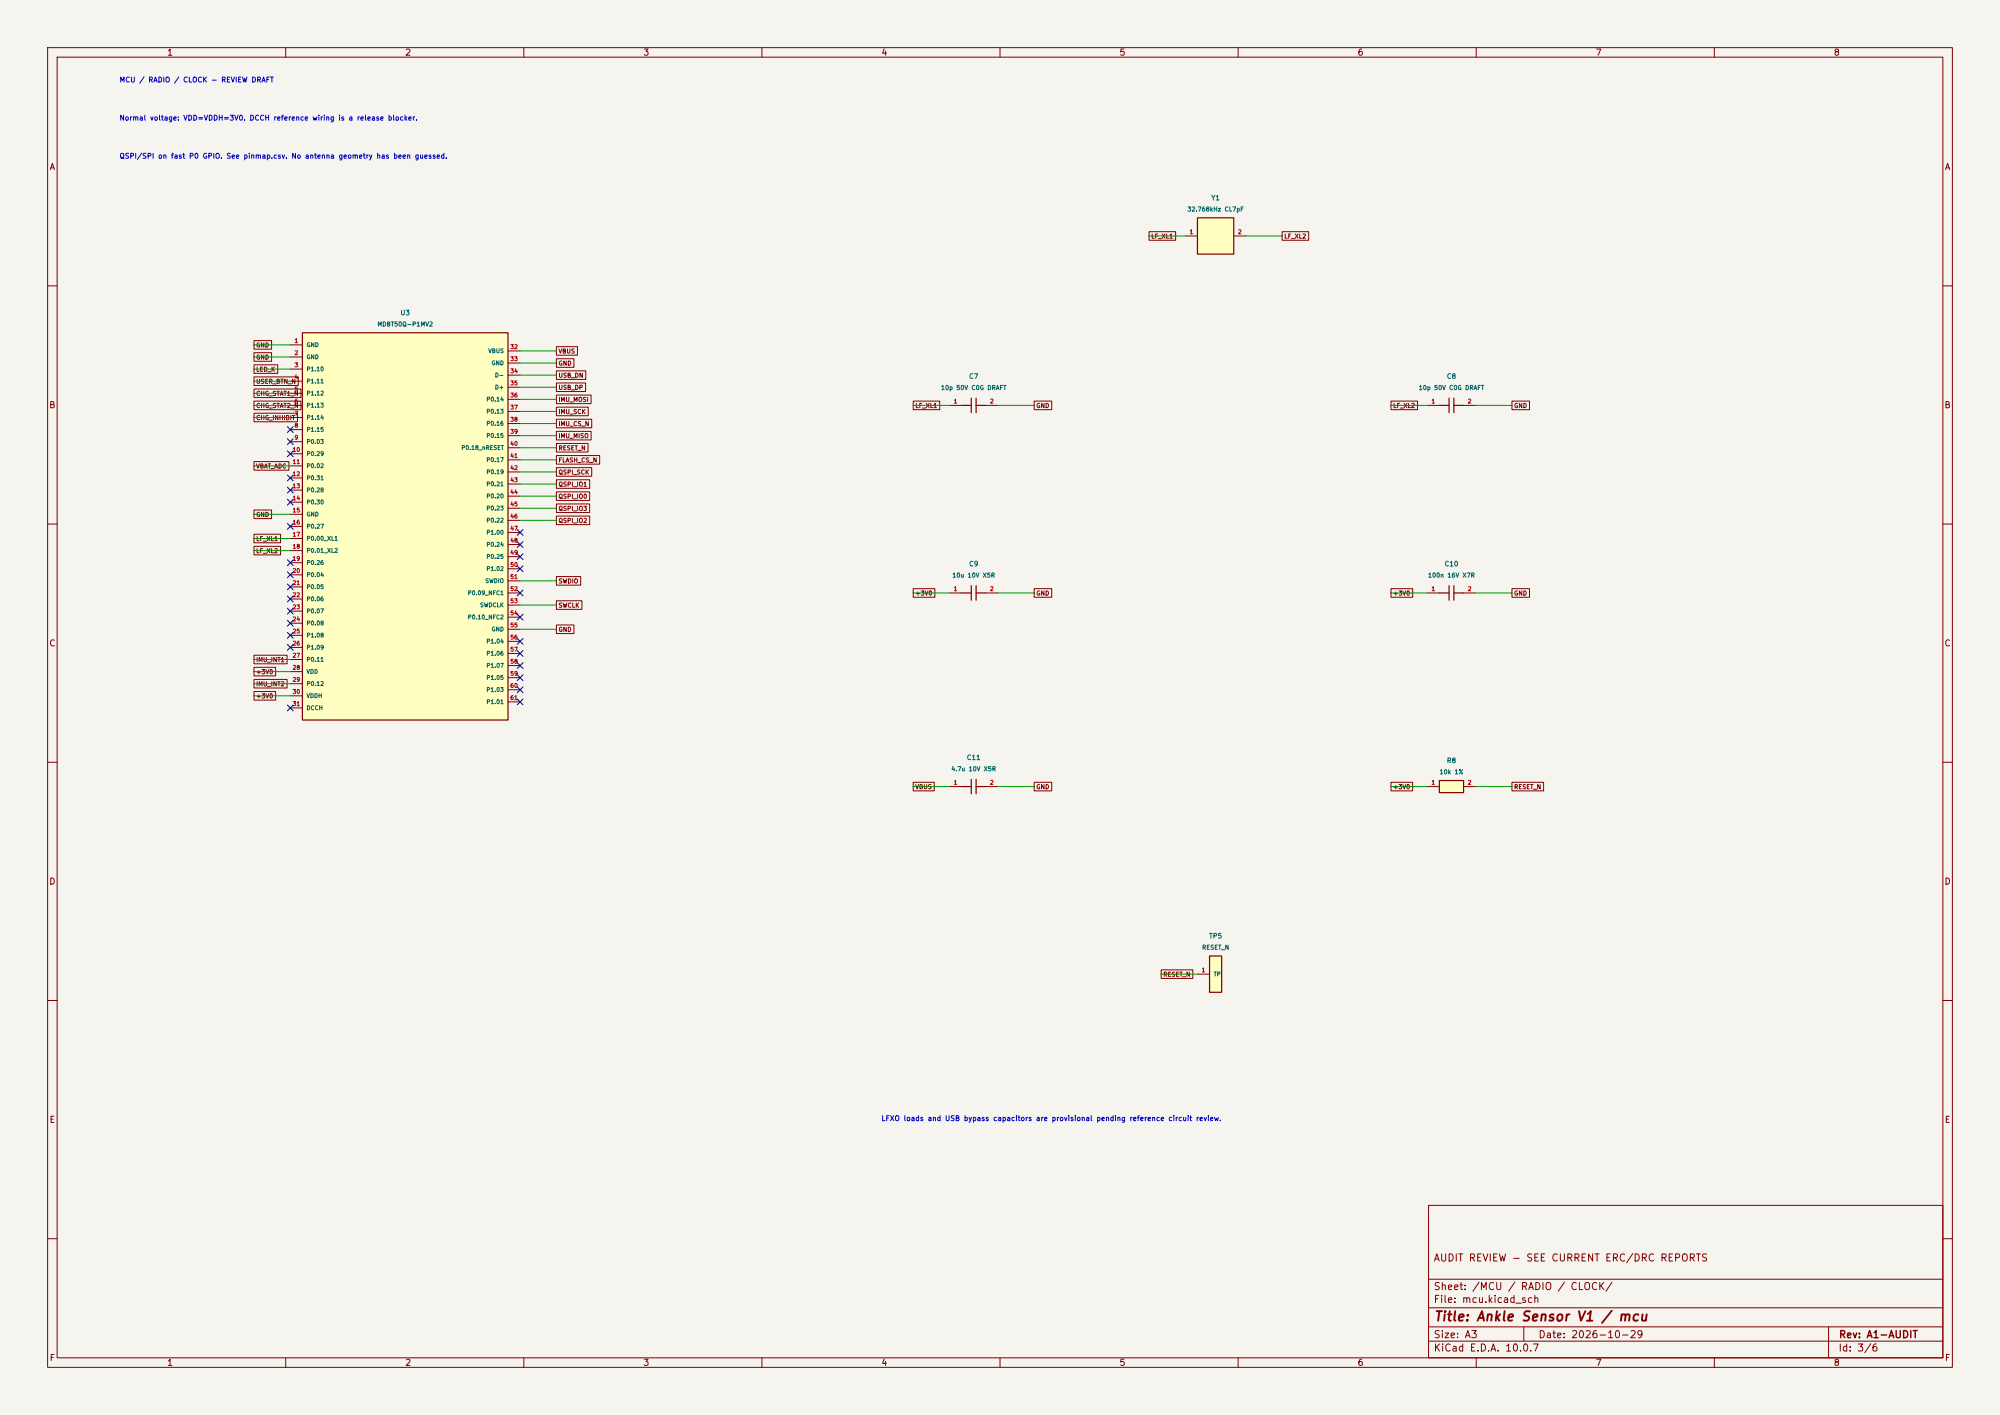
[picture p9: page 3]

QSPI/SPI on fast P0 GPIO. See pinmap.csv. No antenna geometry has been guessed. Normal voltage: VDD=VDDH=3V0. DCCH reference wiring is a release blocker. MCU / RADIO / CLOCK - REVIEW DRAFT

LFXO loads and USB bypass capacitors are provisional pending reference circuit review.

AUDIT REVIEW - SEE CURRENT ERC/DRC REPORTS

Sheet: /MCU / RADIO / CLOCK/
File: mcu.kicad_sch
Title: Ankle Sensor V1 / mcu

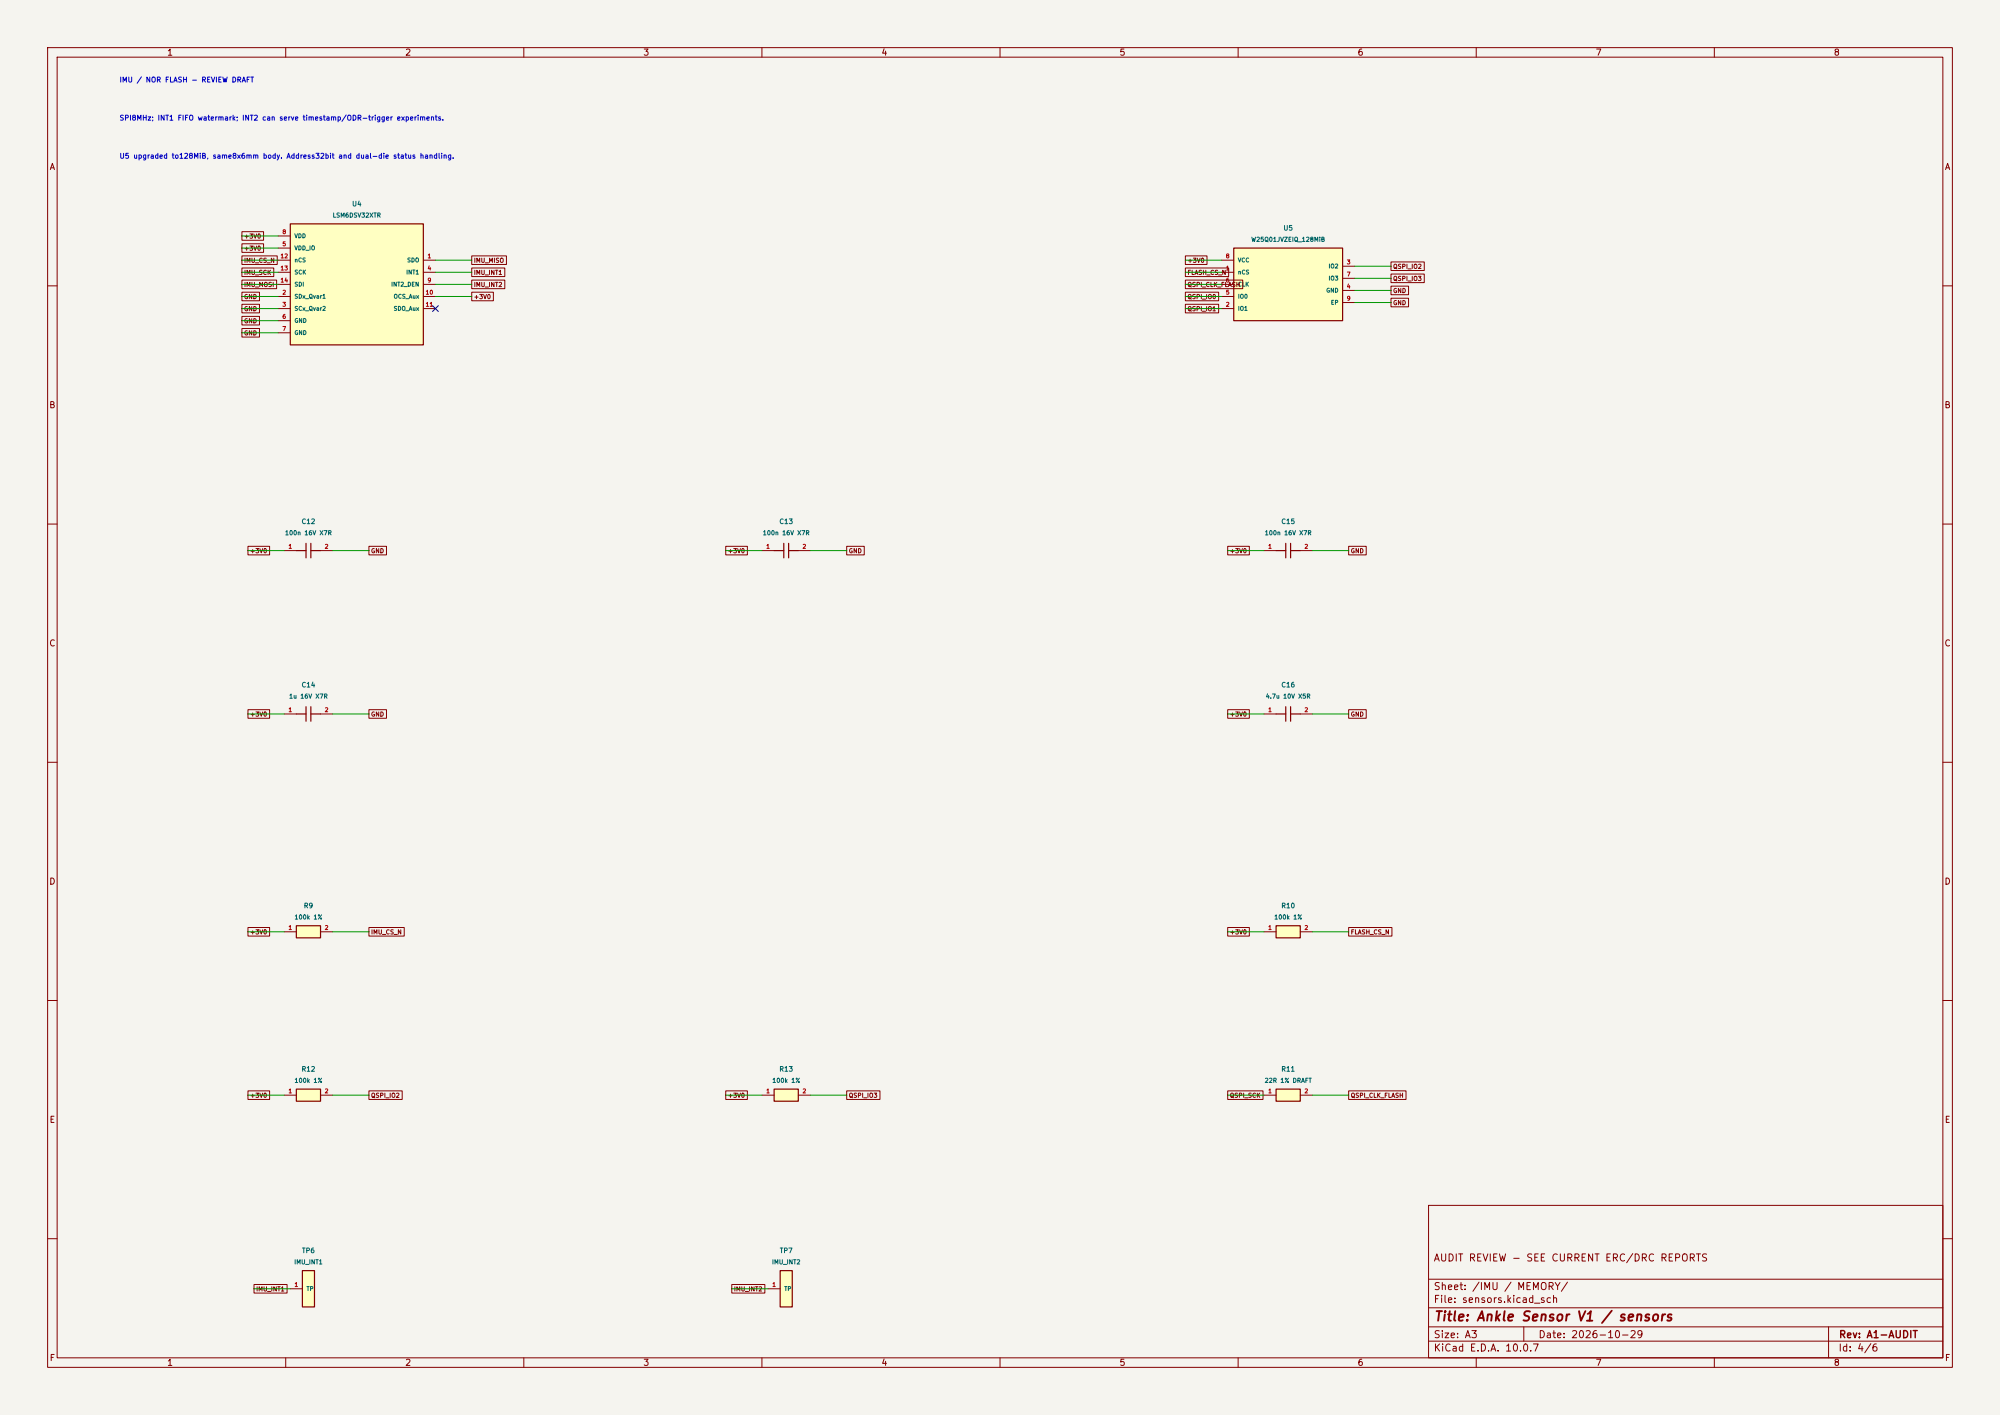
[picture p10: page 4]

IMU / NOR FLASH - REVIEW DRAFT

U5 upgraded to128MiB, same8x6mm body. Address32bit and dual-die status handling. SPI8MHz; INT1 FIFO watermark; INT2 can serve timestamp/ODR-trigger experiments.

AUDIT REVIEW - SEE CURRENT ERC/DRC REPORTS

Sheet: /IMU / MEMORY/
File: sensors.kicad_sch
Title: Ankle Sensor V1 / sensors

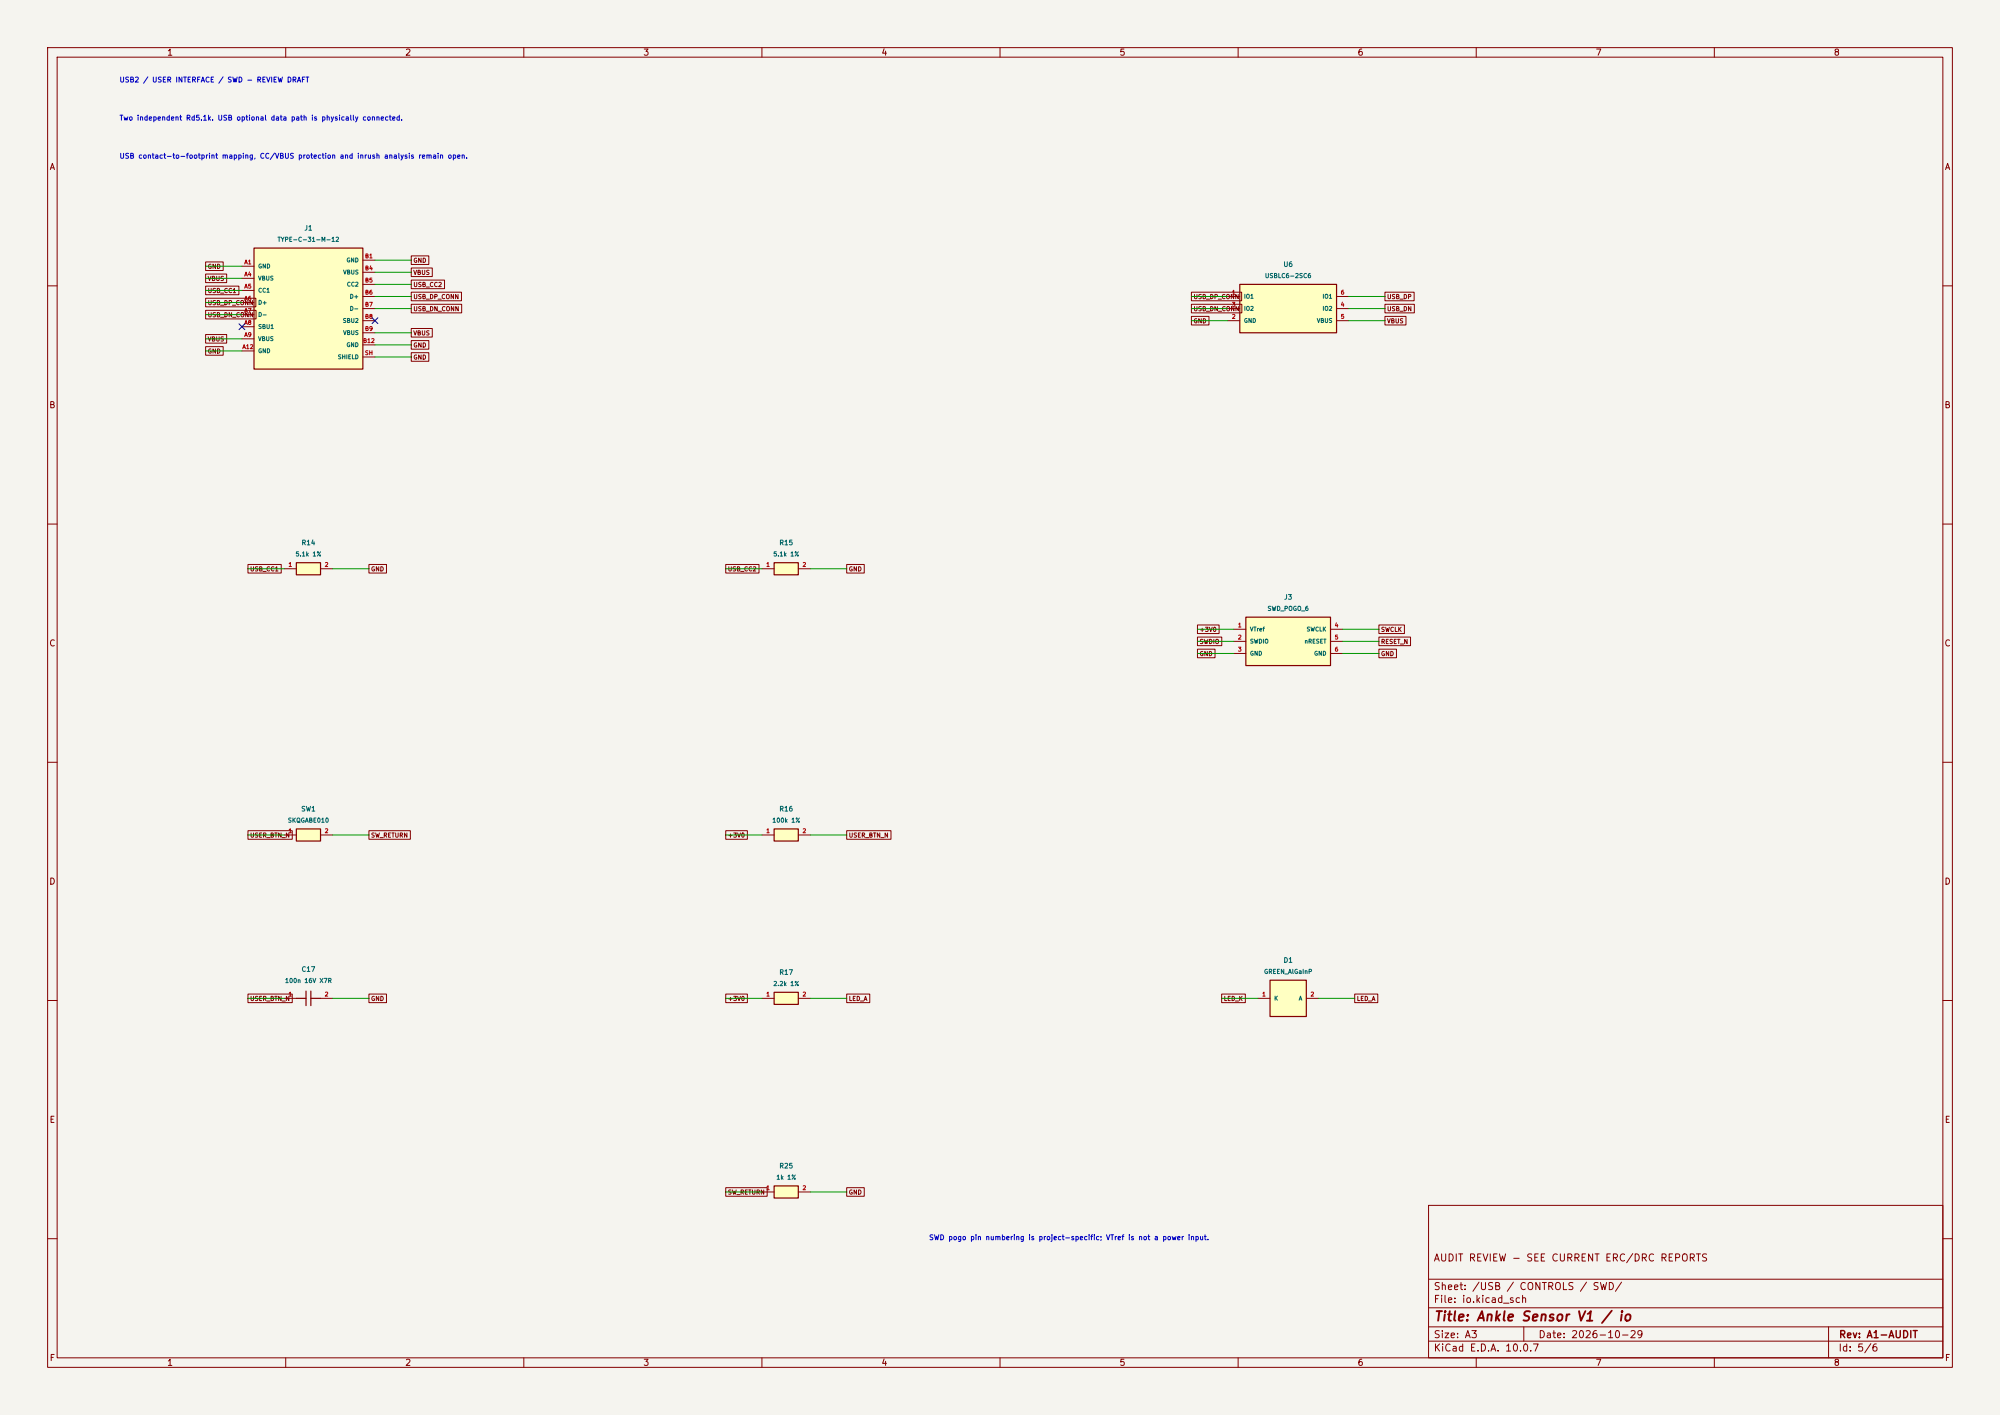
[picture p11: page 5]

Two independent Rd5.1k. USB optional data path is physically connected. USB2 / USER INTERFACE / SWD - REVIEW DRAFT

USB_DN_CONN USB contact-to-footprint mapping, CC/VBUS protection and inrush analysis remain open.

SWD pogo pin numbering is project-specific; VTref is not a power input.

AUDIT REVIEW - SEE CURRENT ERC/DRC REPORTS

Sheet: /USB / CONTROLS / SWD/
File: io.kicad_sch
Title: Ankle Sensor V1 / io

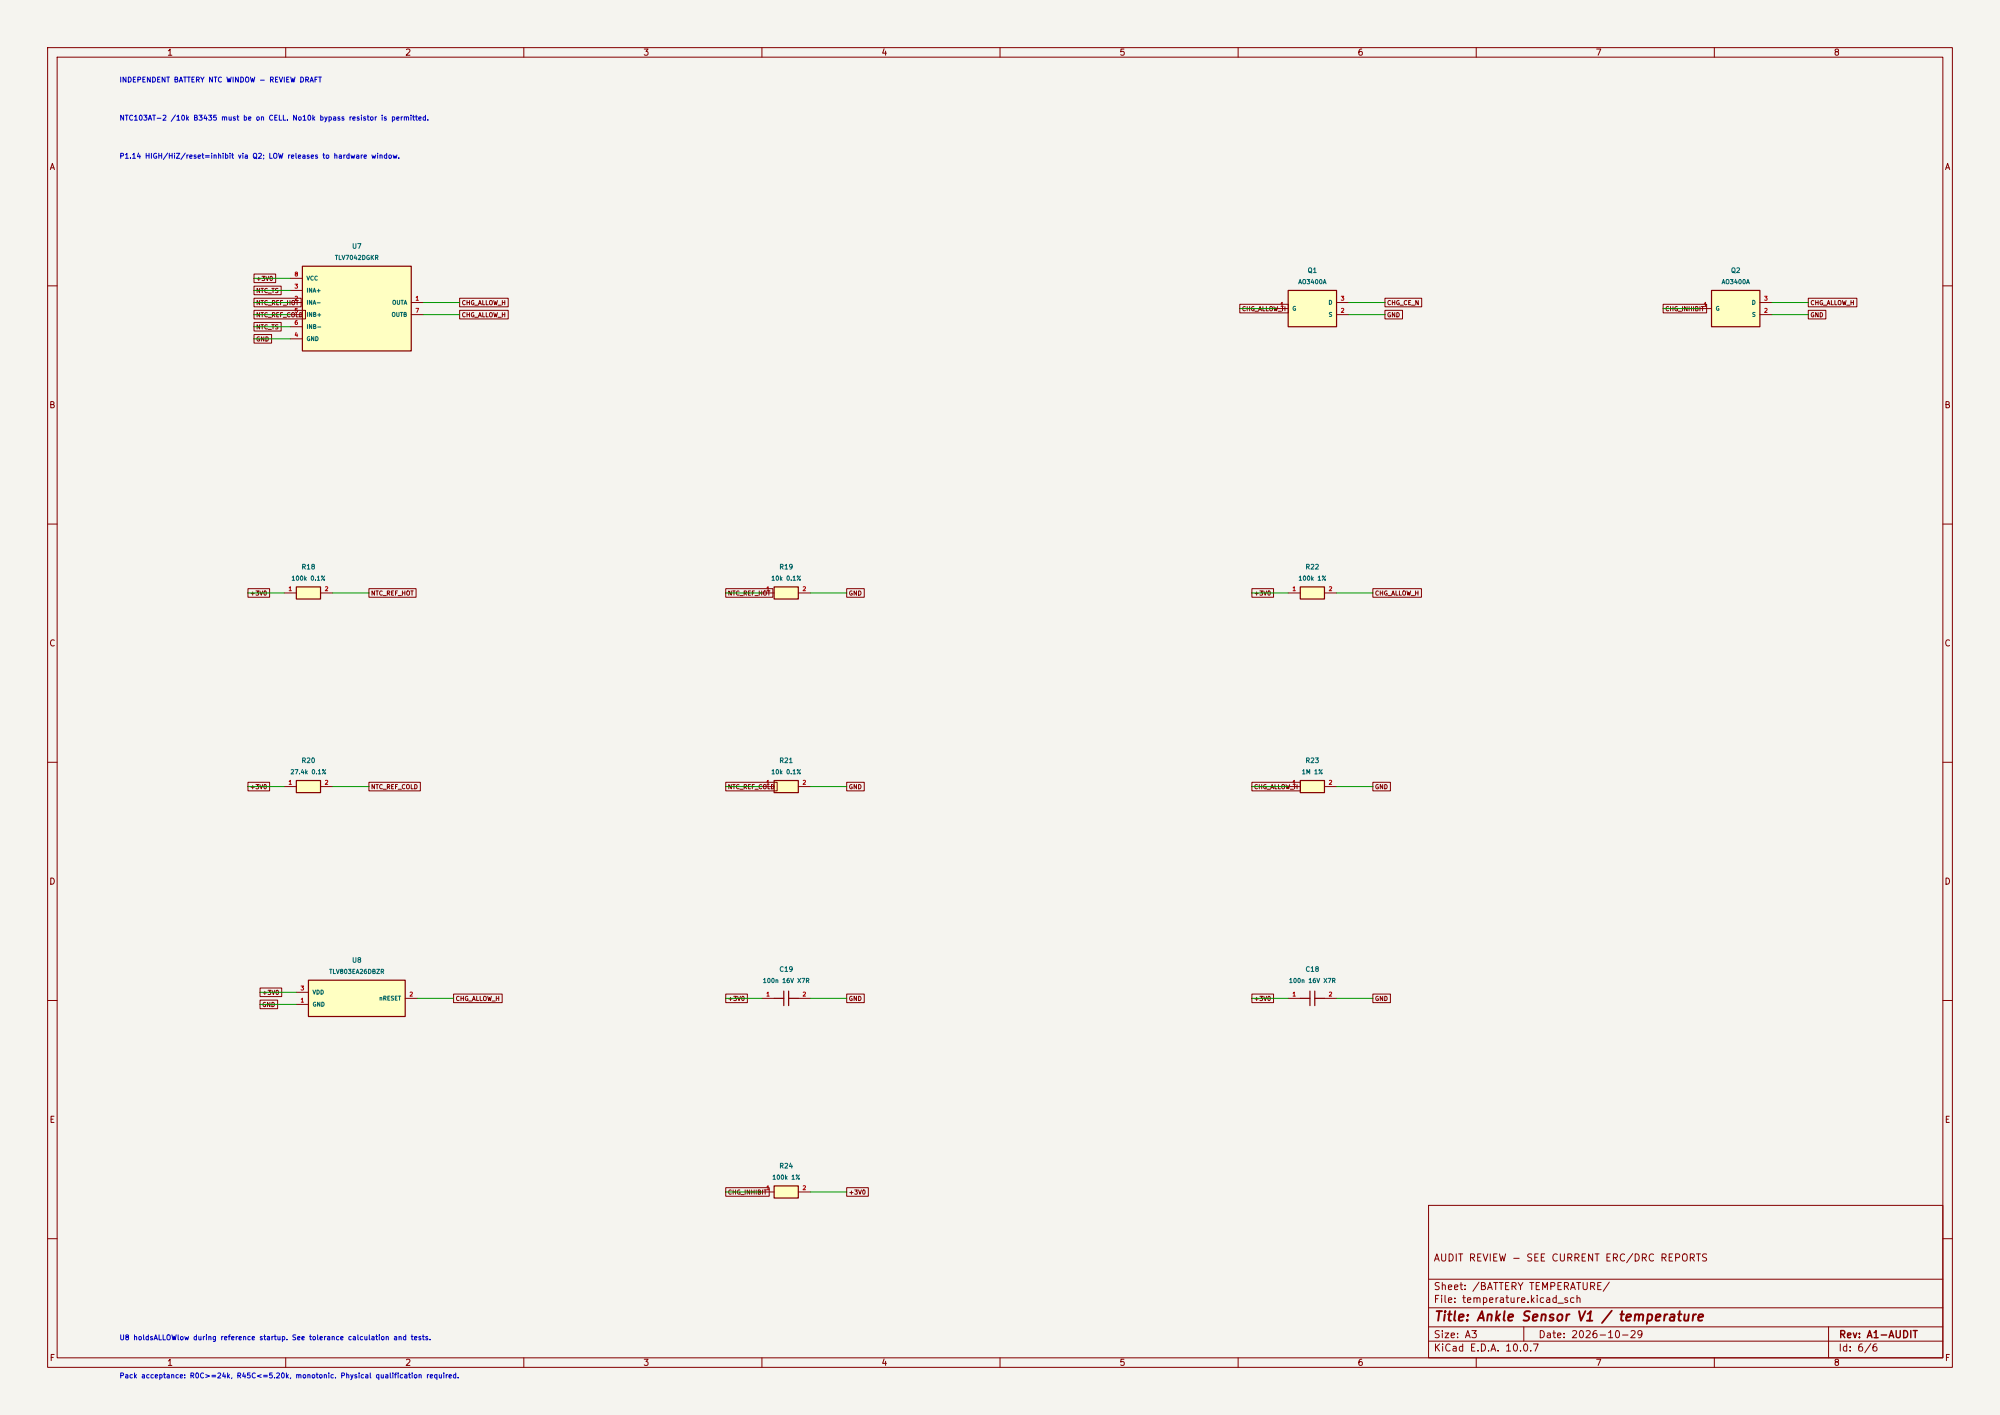
[picture p12: page 6]

INDEPENDENT BATTERY NTC WINDOW - REVIEW DRAFT

NTC103AT-2 /10k B3435 must be on CELL. No10k bypass resistor is permitted.

NTC_REF_COLD P1.14 HIGH/HiZ/reset=inhibit via Q2; LOW releases to hardware window.

AUDIT REVIEW - SEE CURRENT ERC/DRC REPORTS

Sheet: /BATTERY TEMPERATURE/
File: temperature.kicad_sch
Title: Ankle Sensor V1 / temperature

U8 holdsALLOWlow during reference startup. See tolerance calculation and tests.

Pack acceptance: R0C>=24k, R45C<=5.20k, monotonic. Physical qualification required.
