TomKuc/ASV1/reports/Ankle_Sensor_V1_initial.pdf

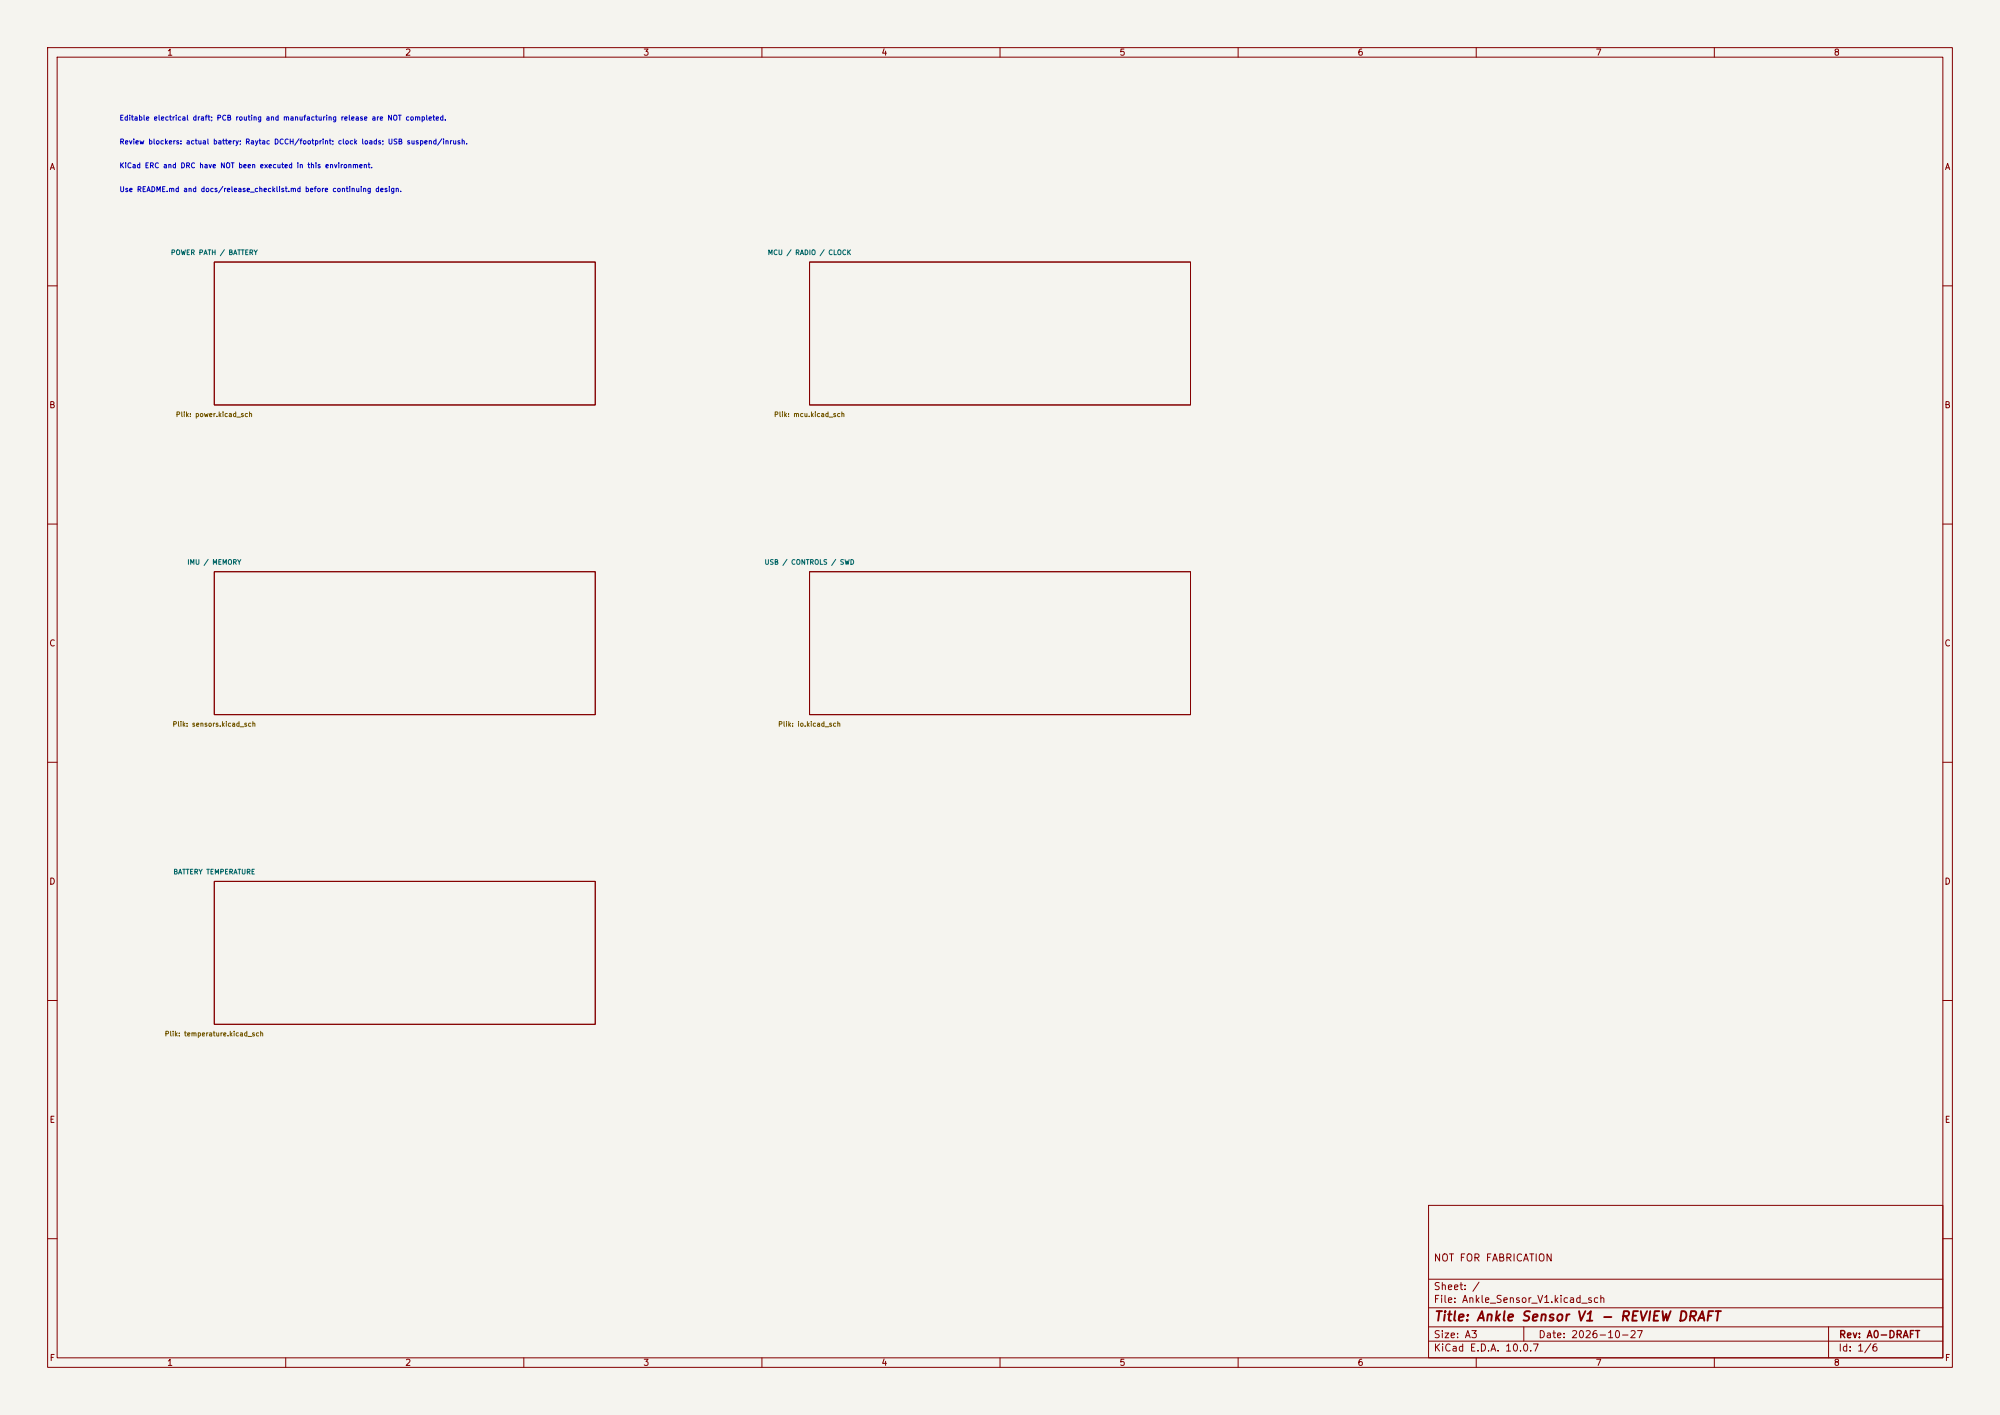
[picture p13: page 1]

Editable electrical draft; PCB routing and manufacturing release are NOT completed. Review blockers: actual battery; Raytac DCCH/footprint; clock loads; USB suspend/inrush. KiCad ERC and DRC have NOT been executed in this environment. Use README.md and docs/release_checklist.md before continuing design.

Plik: mcu.kicad_sch USB / CONTROLS / SWD

IMU / MEMORY Plik: sensors.kicad_sch BATTERY TEMPERATURE Plik: temperature.kicad_sch

Sheet: /
File: Ankle_Sensor_V1.kicad_sch
Title: Ankle Sensor V1 - REVIEW DRAFT

Size: A3 | Rev: A0-DRAFT | F Date: 2026-10-27
KiCad E.D.A. 10.0.7 | Id: 1/6

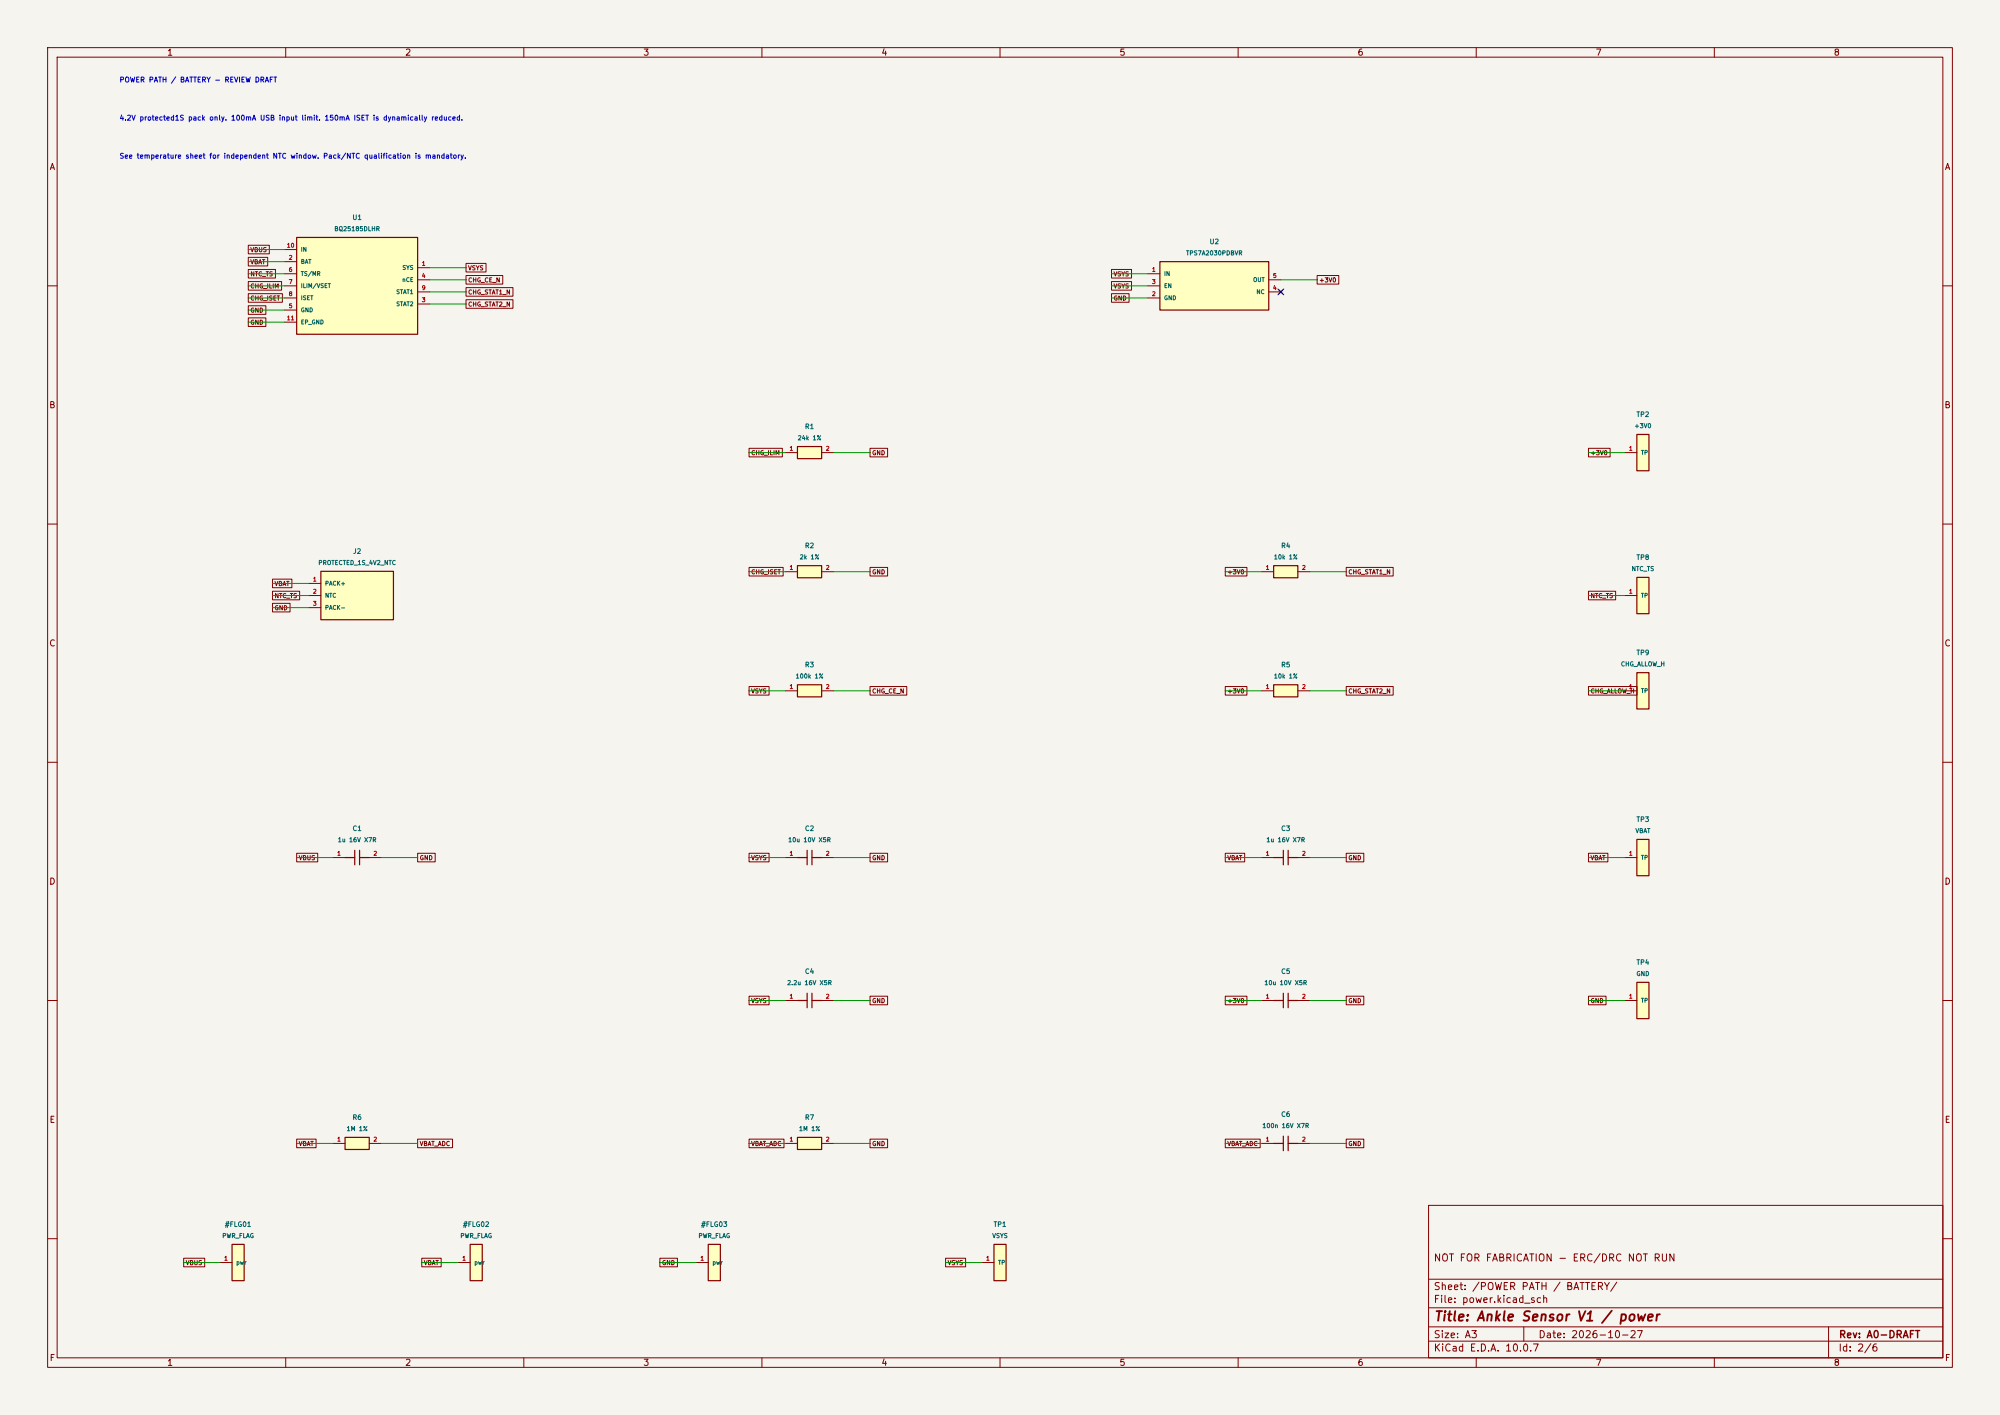
[picture p14: page 2]

VSYS See temperature sheet for independent NTC window. Pack/NTC qualification is mandatory. 4.2V protected1S pack only. 100mA USB input limit. 150mA ISET is dynamically reduced. POWER PATH / BATTERY - REVIEW DRAFT

NOT FOR FABRICATION - ERC/DRC NOT RUN

Sheet: /POWER PATH / BATTERY/
File: power.kicad_sch
Title: Ankle Sensor V1 / power

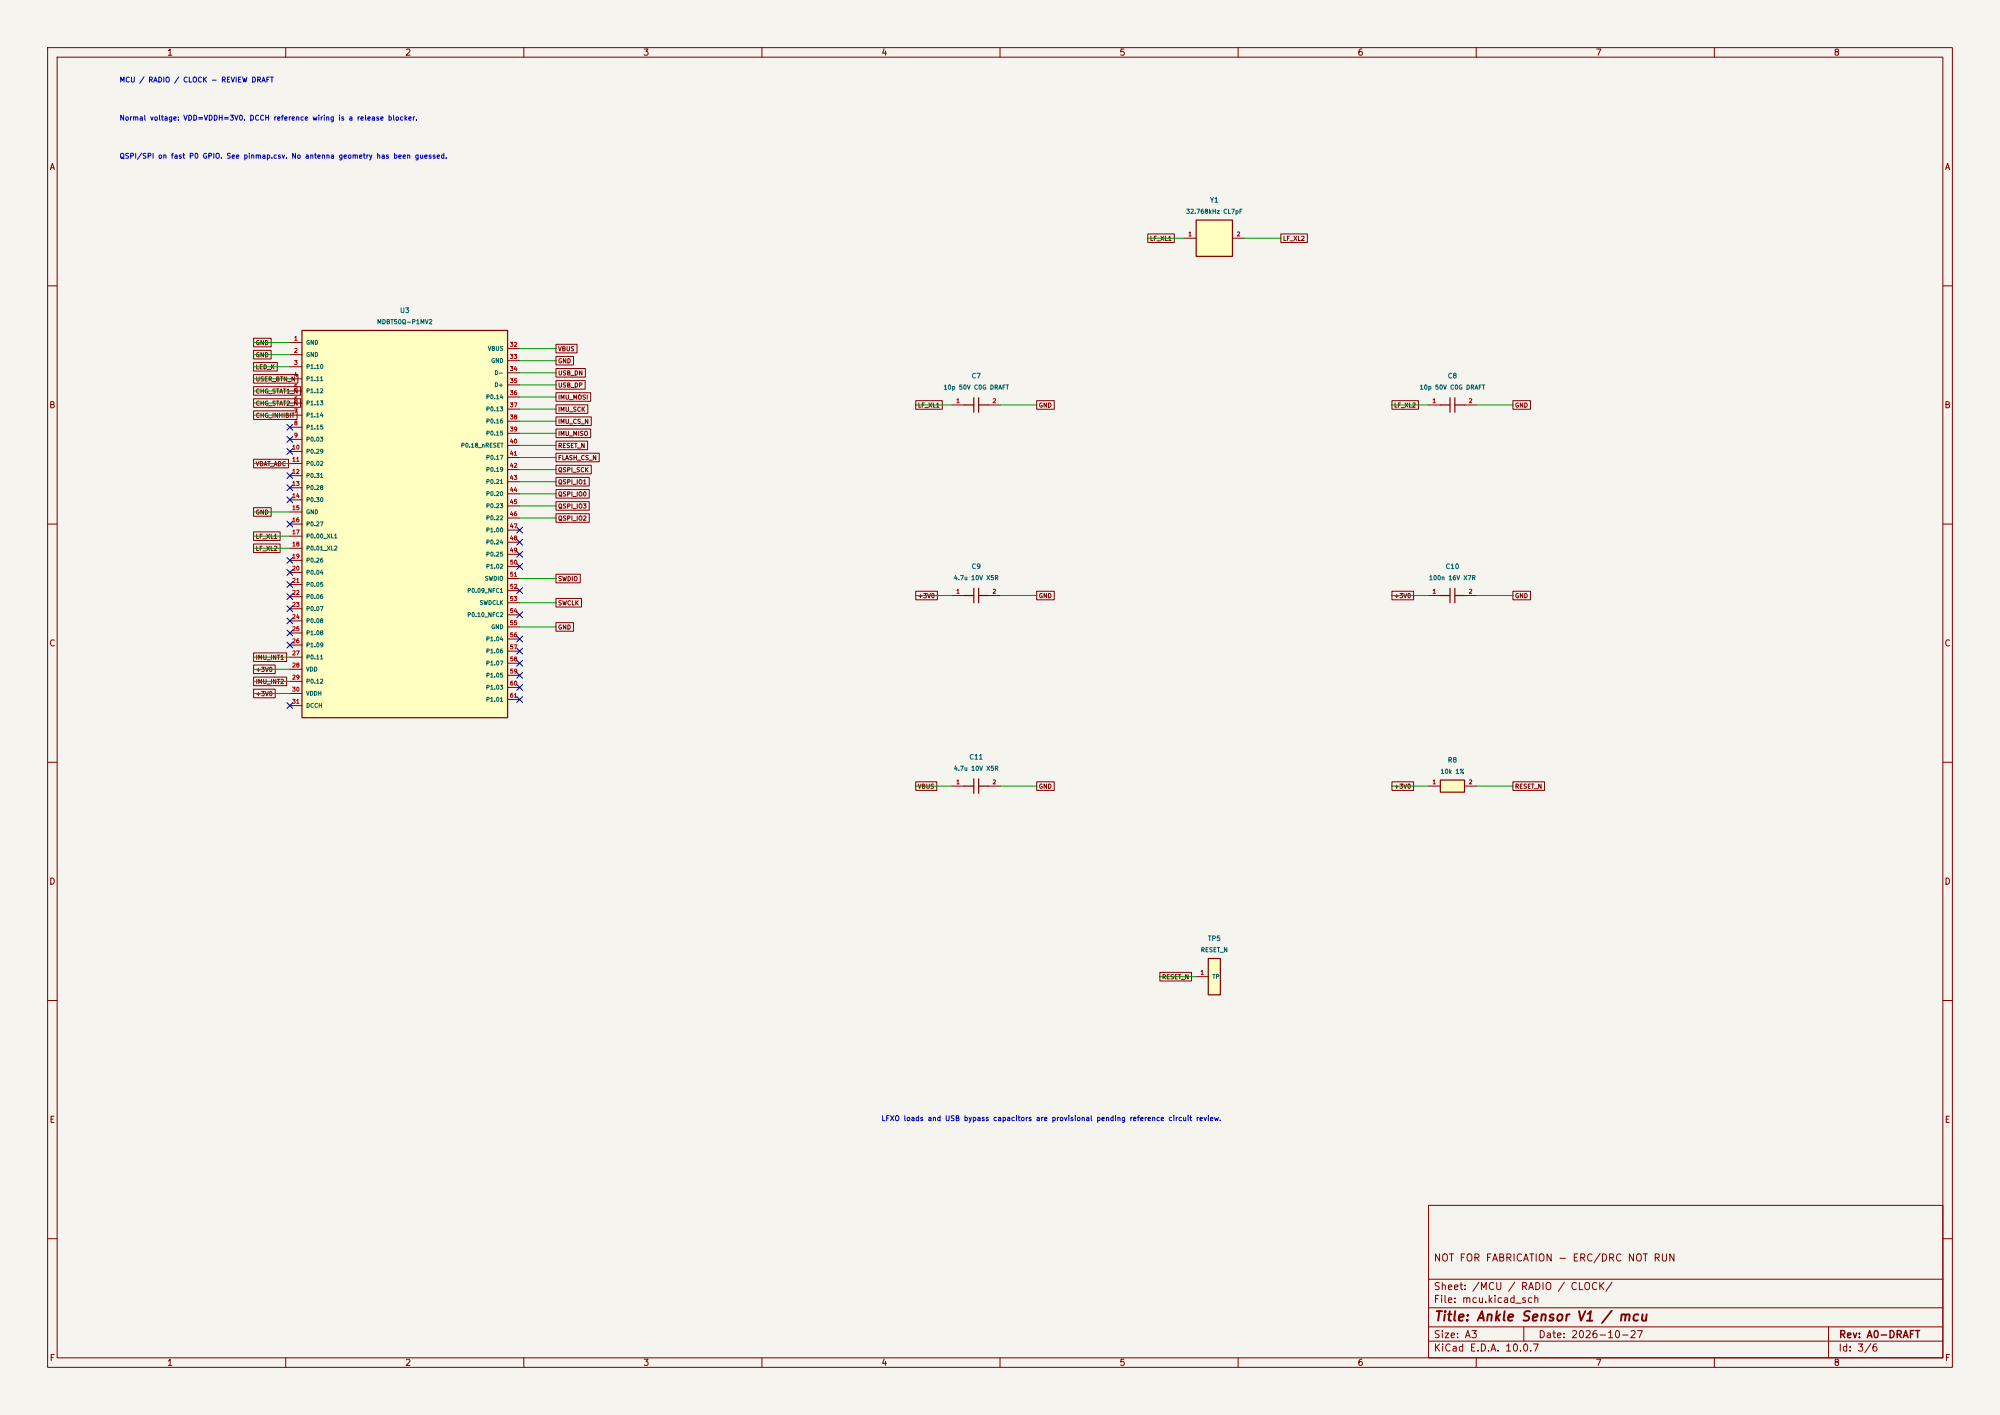
[picture p15: page 3]

QSPI/SPI on fast P0 GPIO. See pinmap.csv. No antenna geometry has been guessed. Normal voltage: VDD=VDDH=3V0. DCCH reference wiring is a release blocker. MCU / RADIO / CLOCK - REVIEW DRAFT

LFXO loads and USB bypass capacitors are provisional pending reference circuit review.

NOT FOR FABRICATION - ERC/DRC NOT RUN

Sheet: /MCU / RADIO / CLOCK/
File: mcu.kicad_sch
Title: Ankle Sensor V1 / mcu

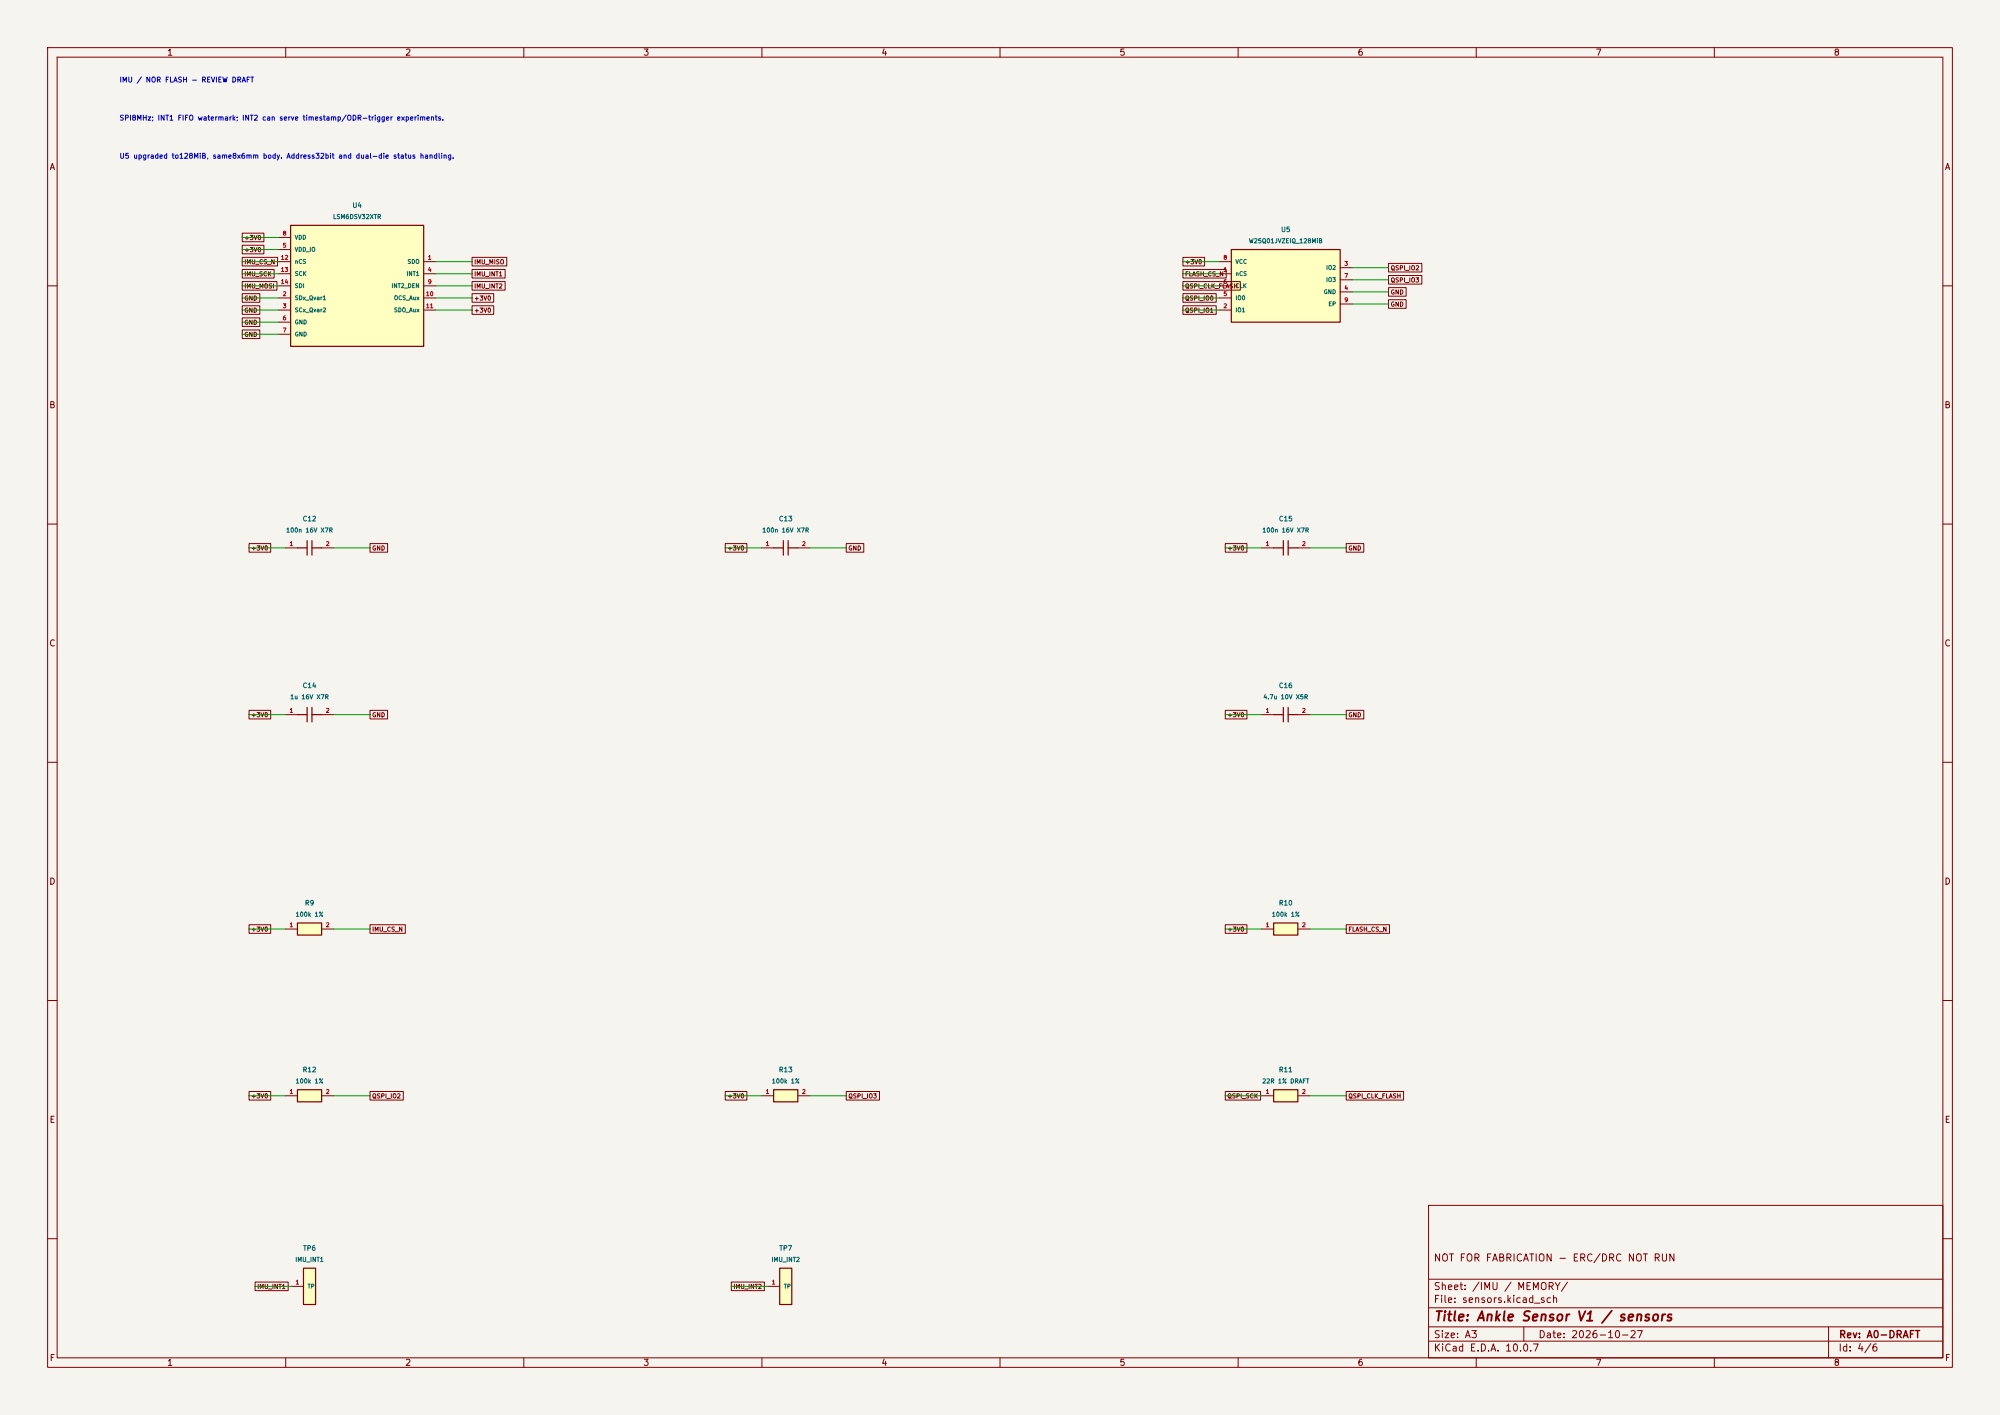
[picture p16: page 4]

IMU / NOR FLASH - REVIEW DRAFT

SPI8MHz; INT1 FIFO watermark; INT2 can serve timestamp/ODR-trigger experiments. U5 upgraded to128MiB, same8x6mm body. Address32bit and dual-die status handling.

NOT FOR FABRICATION - ERC/DRC NOT RUN

Sheet: /IMU / MEMORY/
File: sensors.kicad_sch
Title: Ankle Sensor V1 / sensors

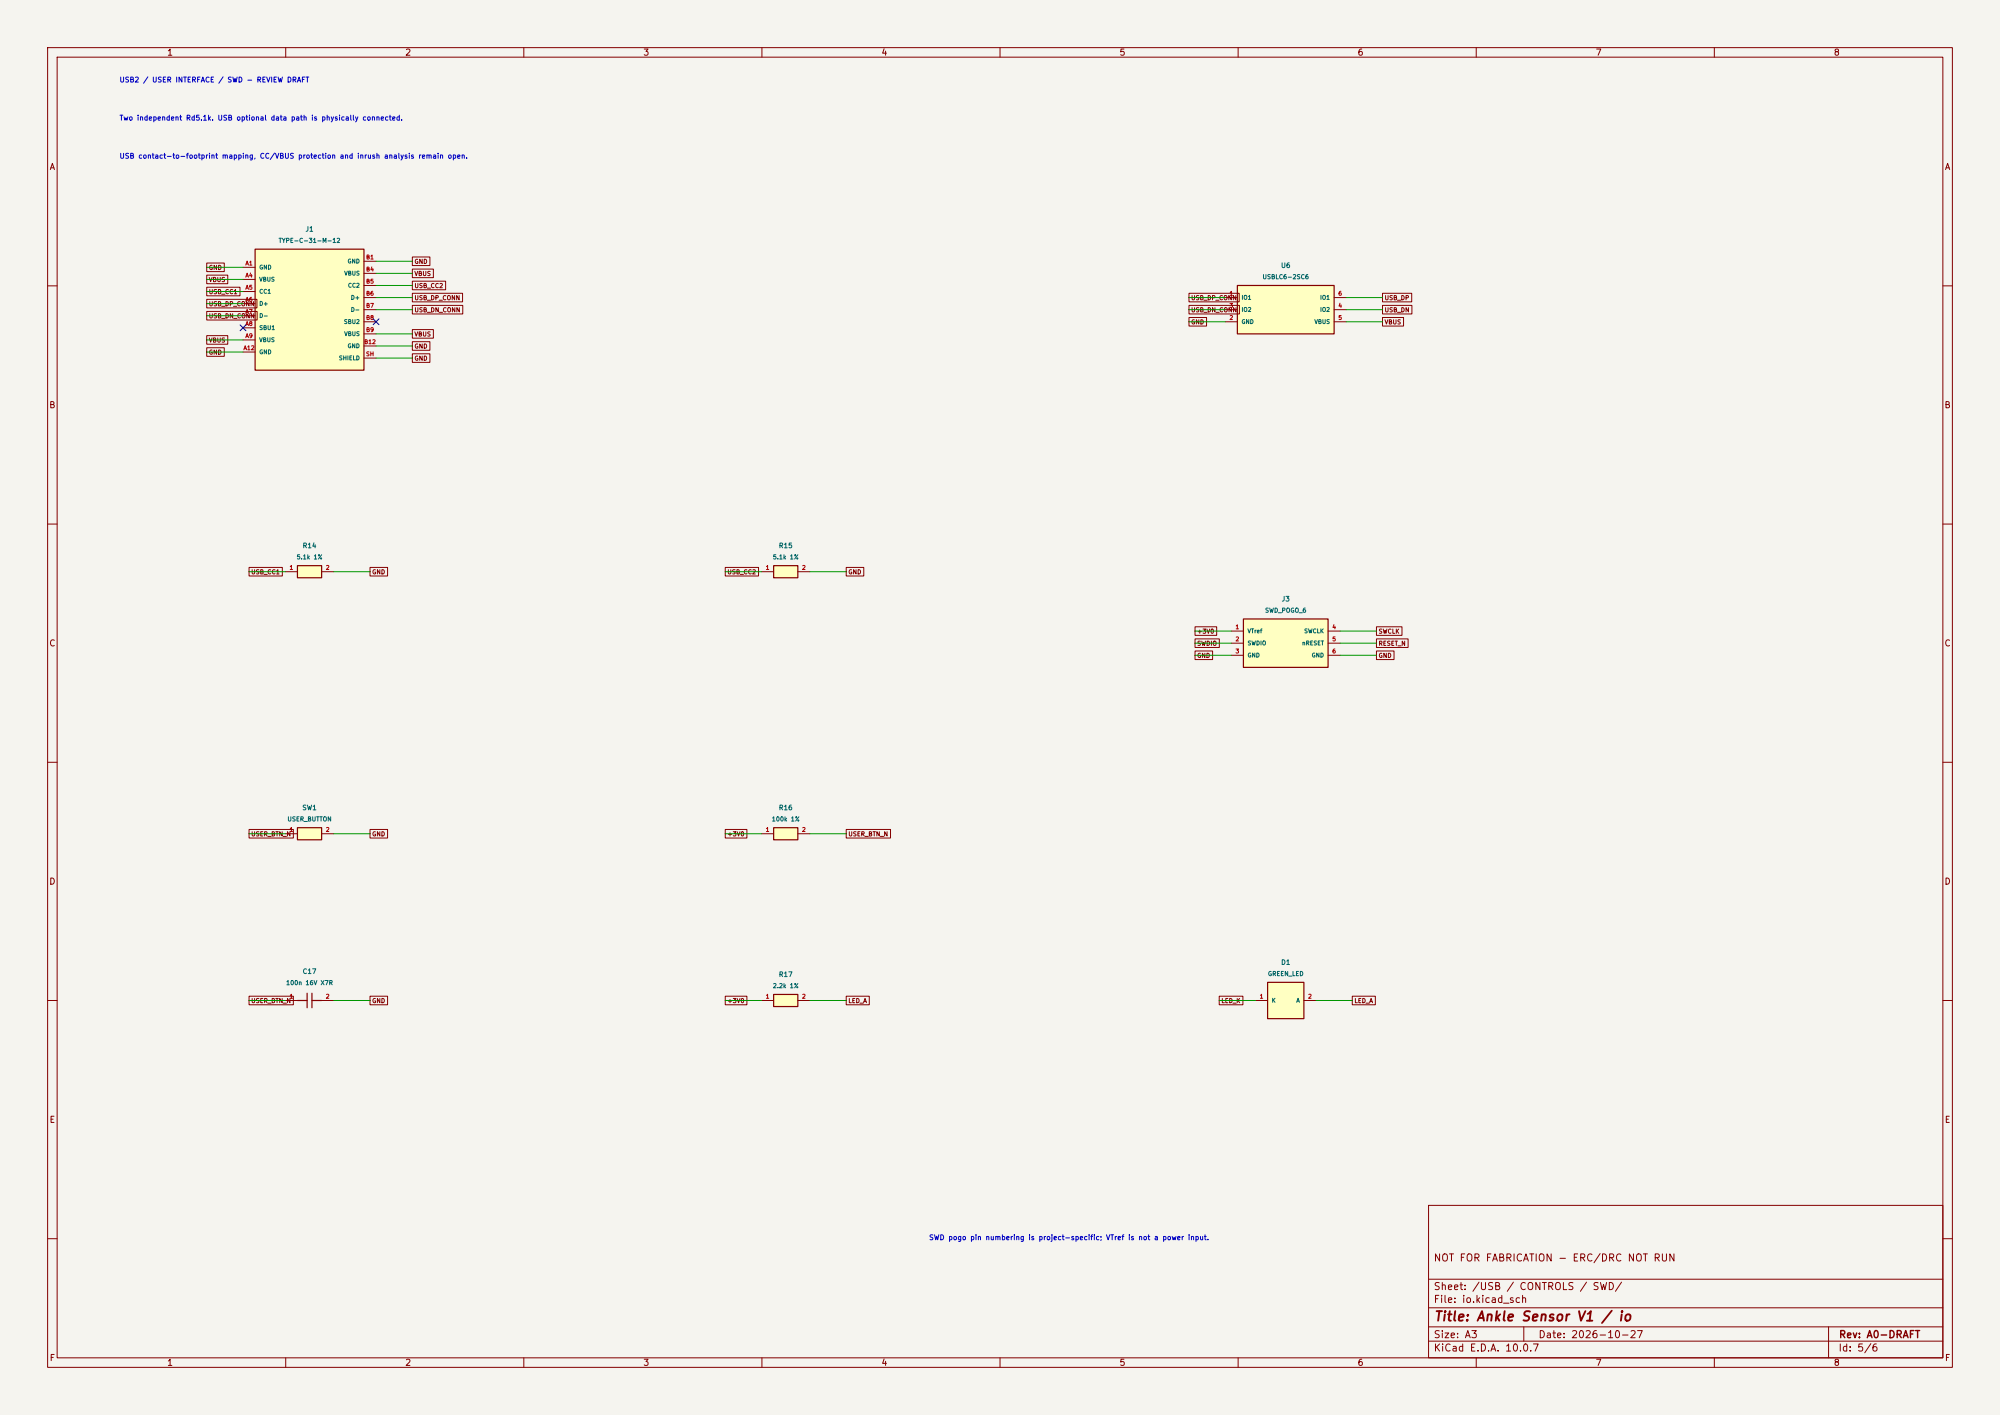
[picture p17: page 5]

Two independent Rd5.1k. USB optional data path is physically connected. USB2 / USER INTERFACE / SWD - REVIEW DRAFT

GND USB contact-to-footprint mapping, CC/VBUS protection and inrush analysis remain open.

SWD pogo pin numbering is project-specific; VTref is not a power input.

NOT FOR FABRICATION - ERC/DRC NOT RUN

Sheet: /USB / CONTROLS / SWD/
File: io.kicad_sch
Title: Ankle Sensor V1 / io

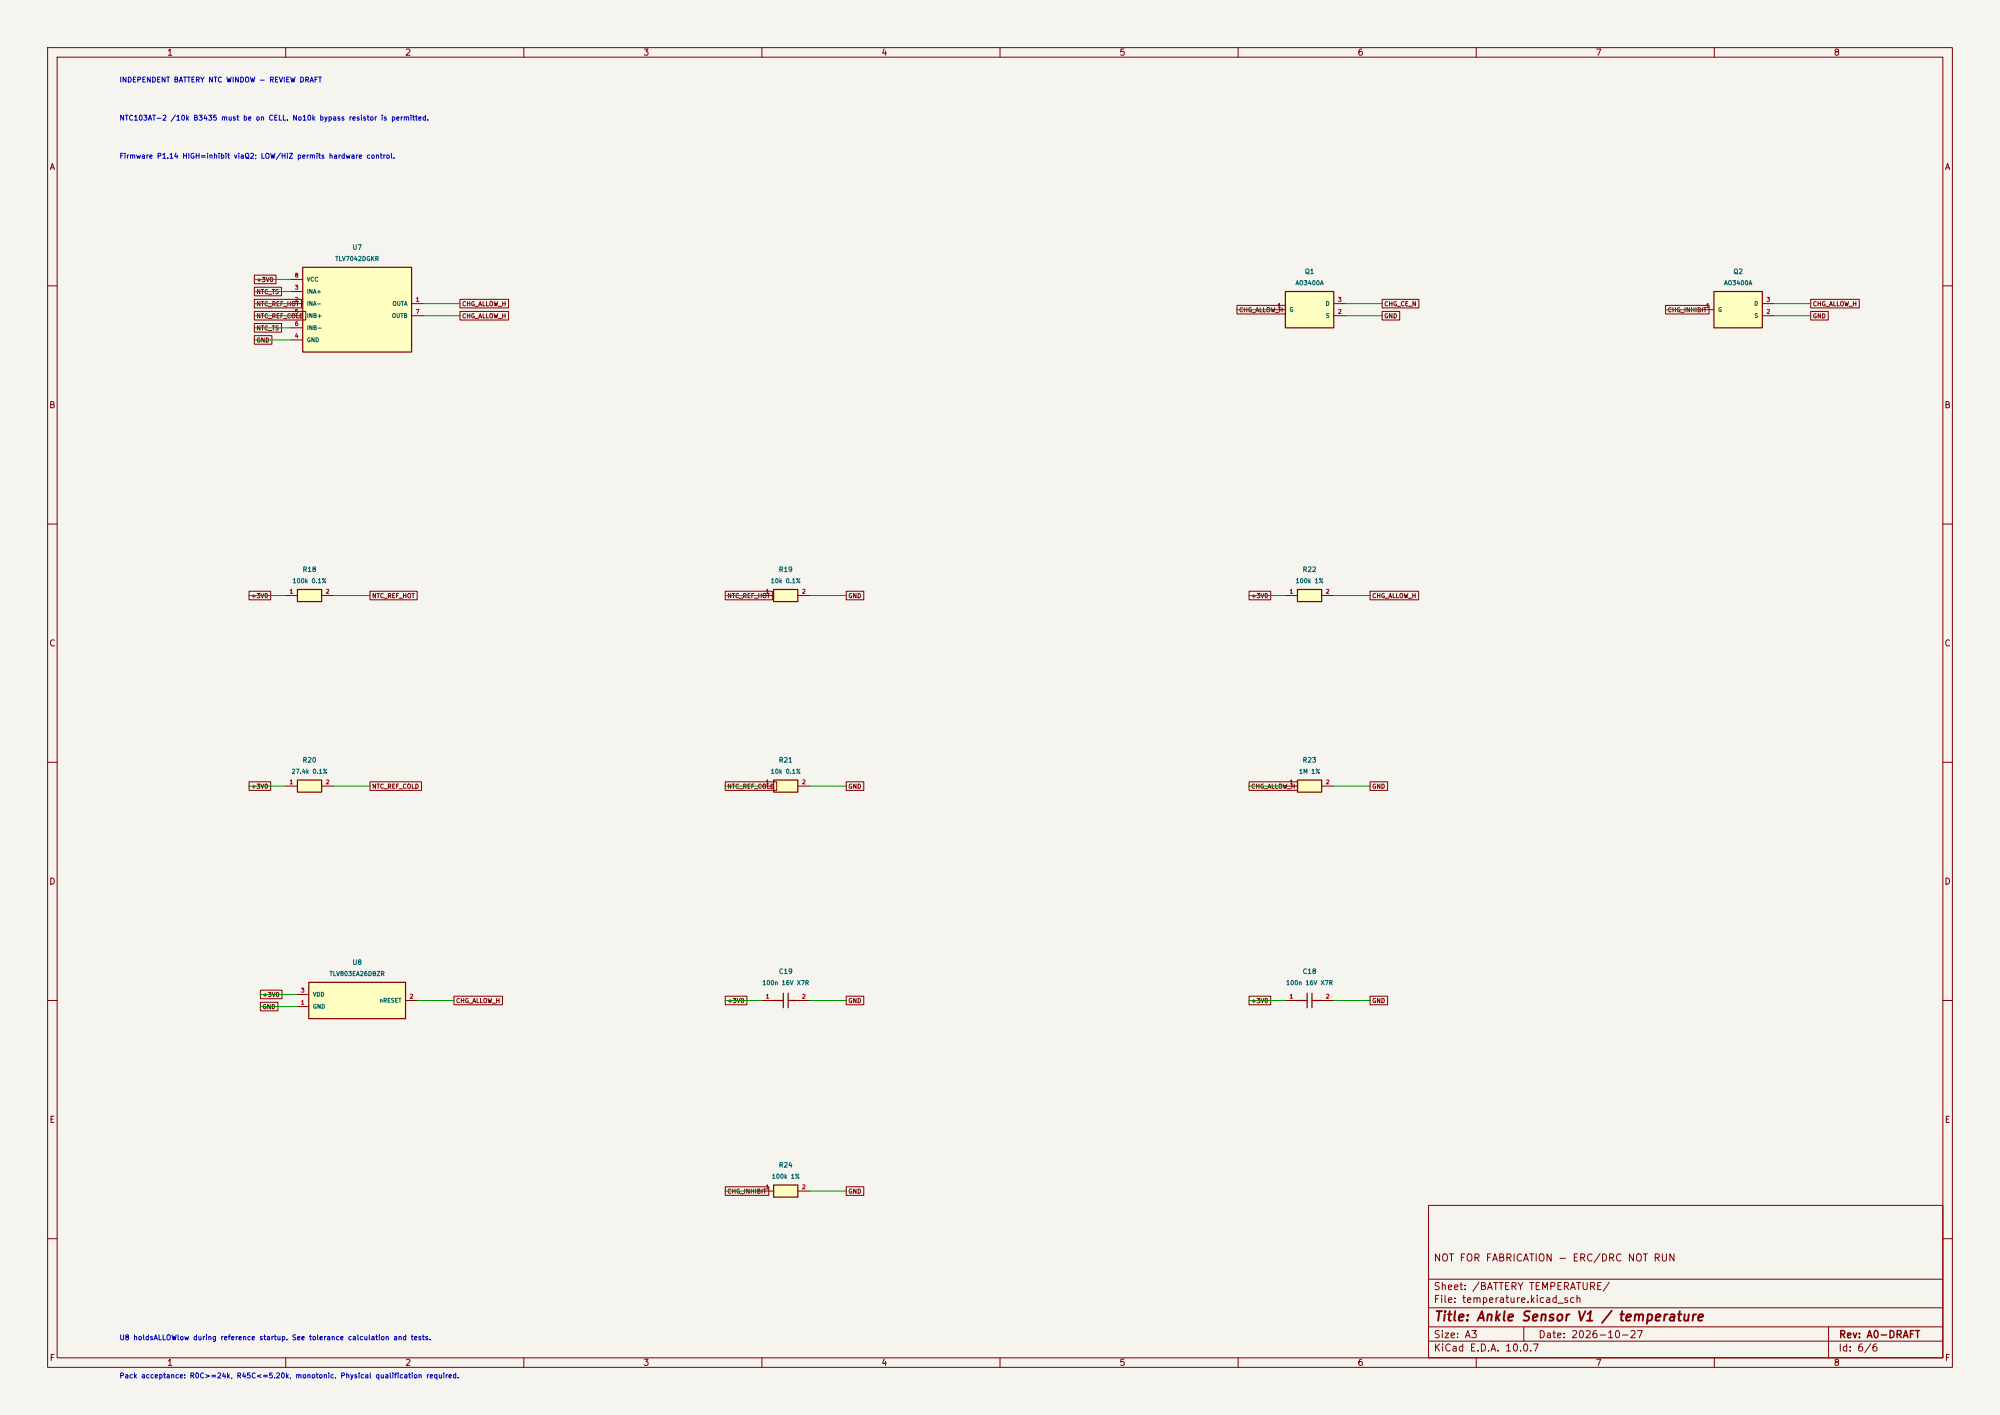
[picture p18: page 6]

INDEPENDENT BATTERY NTC WINDOW - REVIEW DRAFT

Firmware P1.14 HIGH=inhibit viaQ2; LOW/HiZ permits hardware control. NTC103AT-2 /10k B3435 must be on CELL. No10k bypass resistor is permitted.

NOT FOR FABRICATION - ERC/DRC NOT RUN

Sheet: /BATTERY TEMPERATURE/
File: temperature.kicad_sch
Title: Ankle Sensor V1 / temperature

U8 holdsALLOWlow during reference startup. See tolerance calculation and tests. Pack acceptance: R0C>=24k, R45C<=5.20k, monotonic. Physical qualification required.
