TomKuc/ASV1/(list of files, drawings)

Other design files:
reports/pcb_build.json
reports/pcb_native_statistics.json
