TomKuc/ASV1/hardware/Ankle_Sensor_V1.kicad_pcb

## KiCad design hardware/Ankle_Sensor_V1.kicad_pcb (2026-10-29)

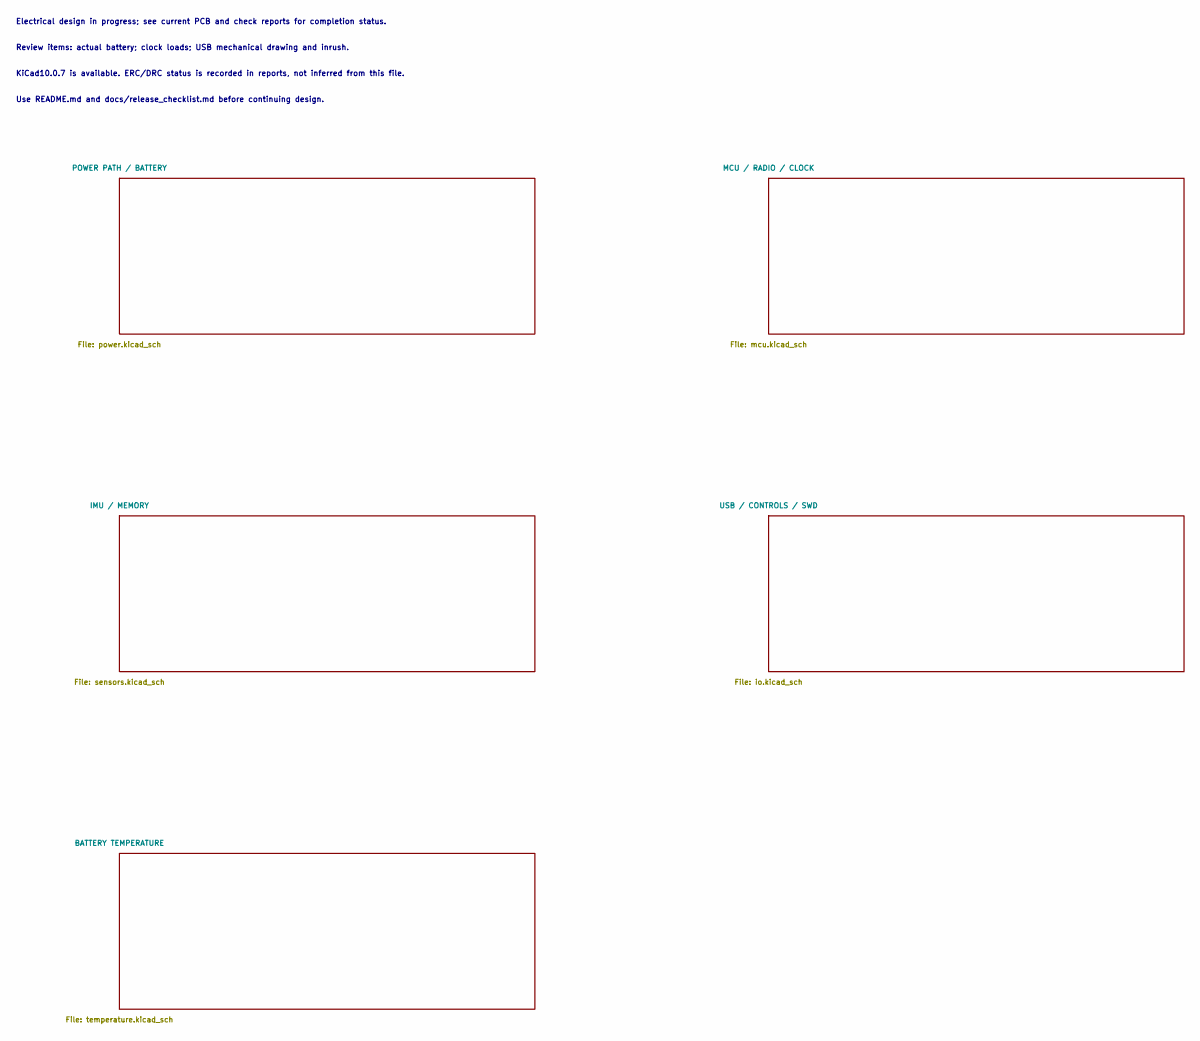
[picture p19: schematic Ankle_Sensor_V1.kicad_sch, Ankle Sensor V1 - AUDIT REVIEW]

Notes on the sheet:
Electrical design in progress; see current PCB and check reports for completion status.
Review items: actual battery; clock loads; USB mechanical drawing and inrush.
KiCad10.0.7 is available. ERC/DRC status is recorded in reports, not inferred from this file.
Use README.md and docs/release_checklist.md before continuing design.

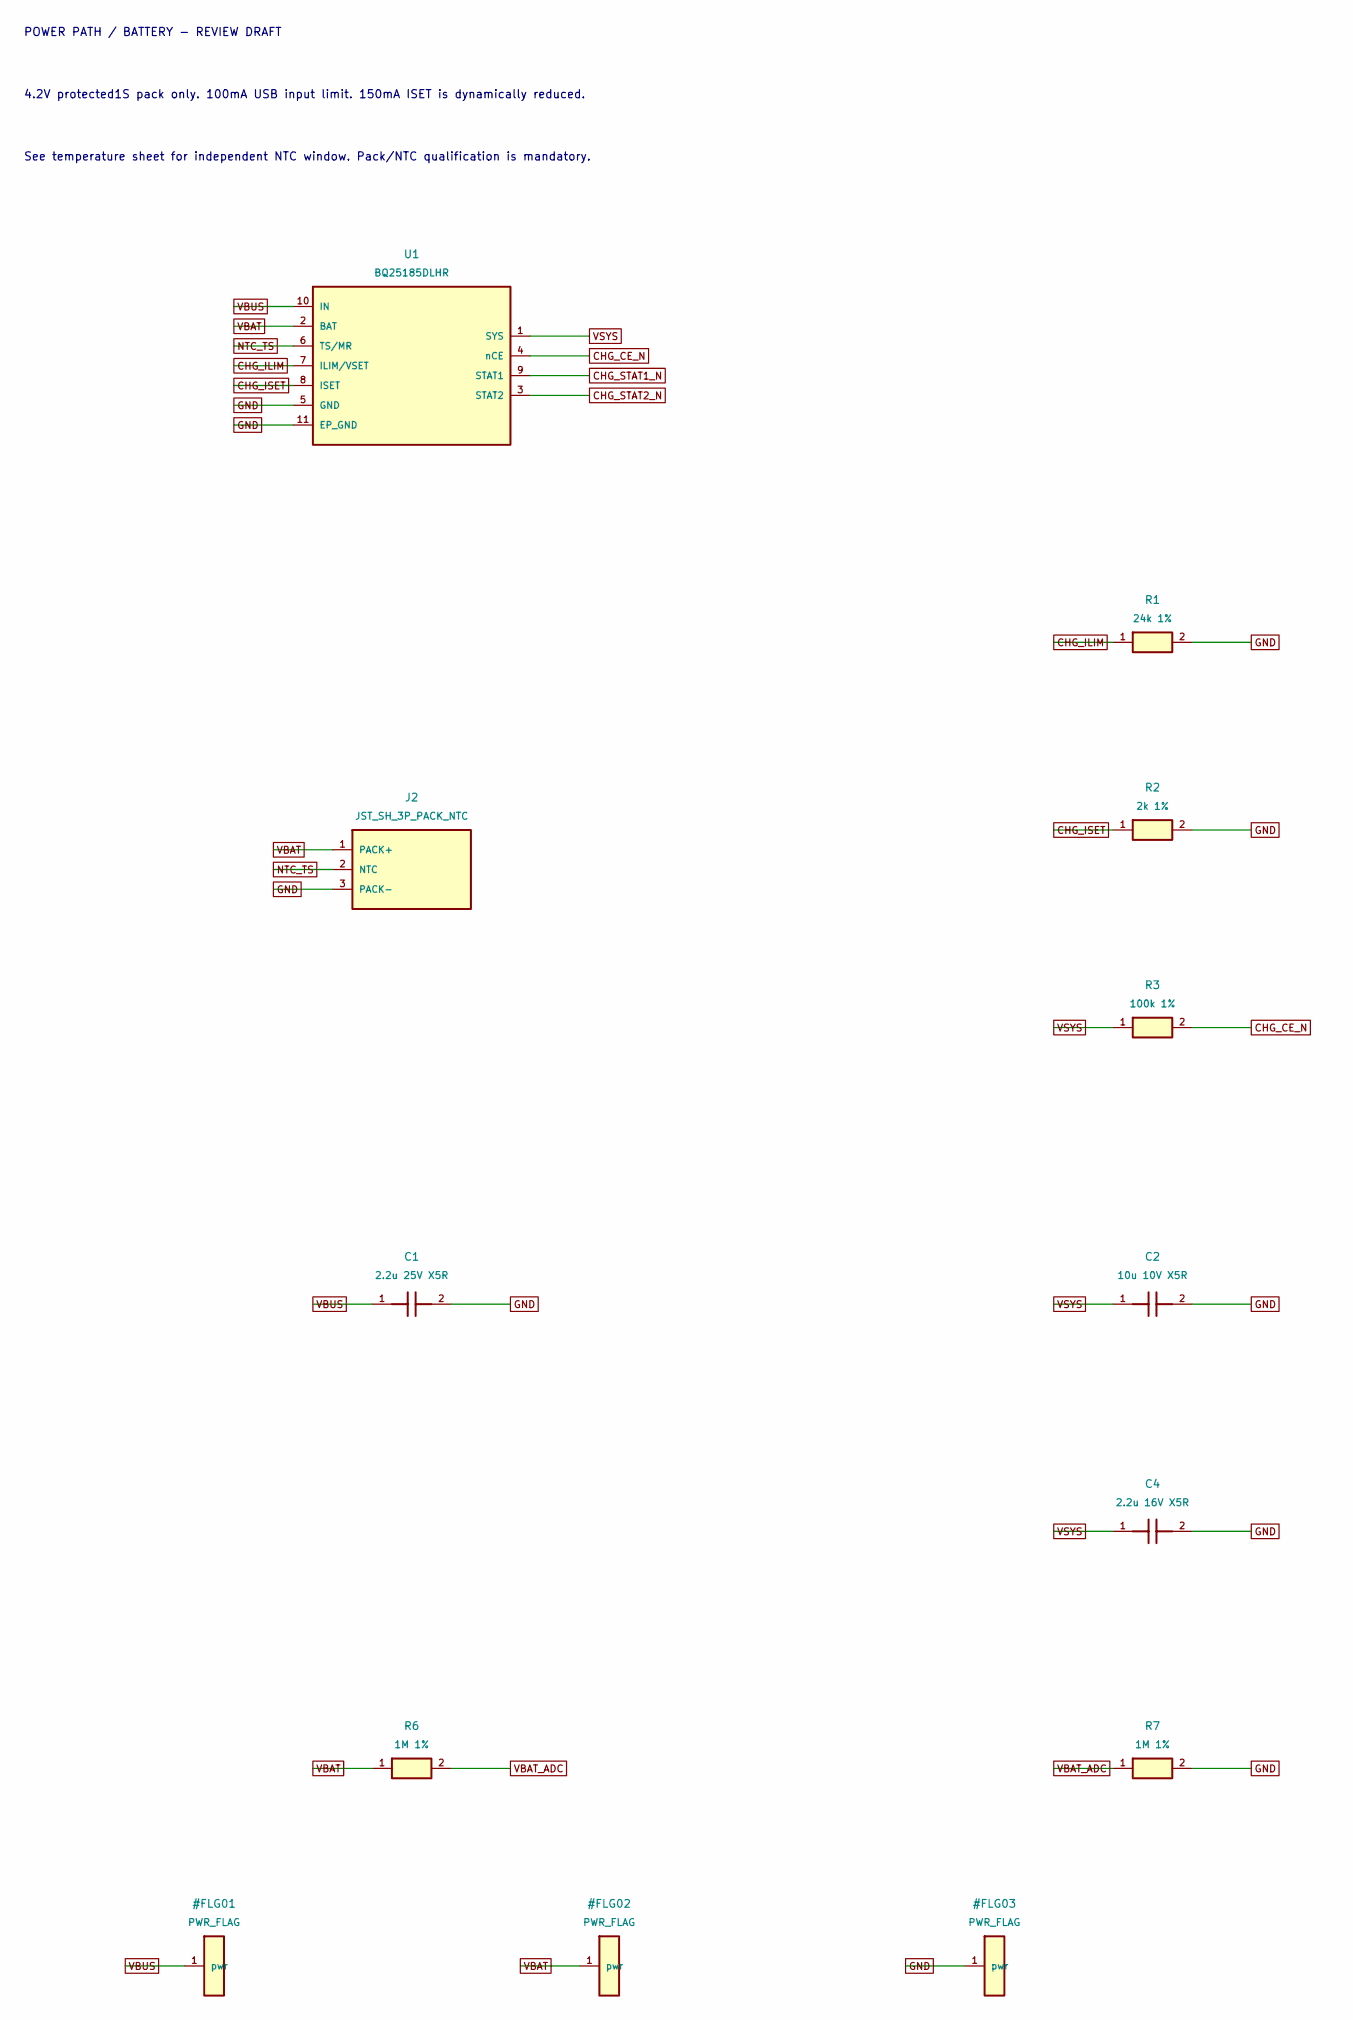
[picture p20: schematic power.kicad_sch, Ankle Sensor V1 / power, part in row 1, column 1]

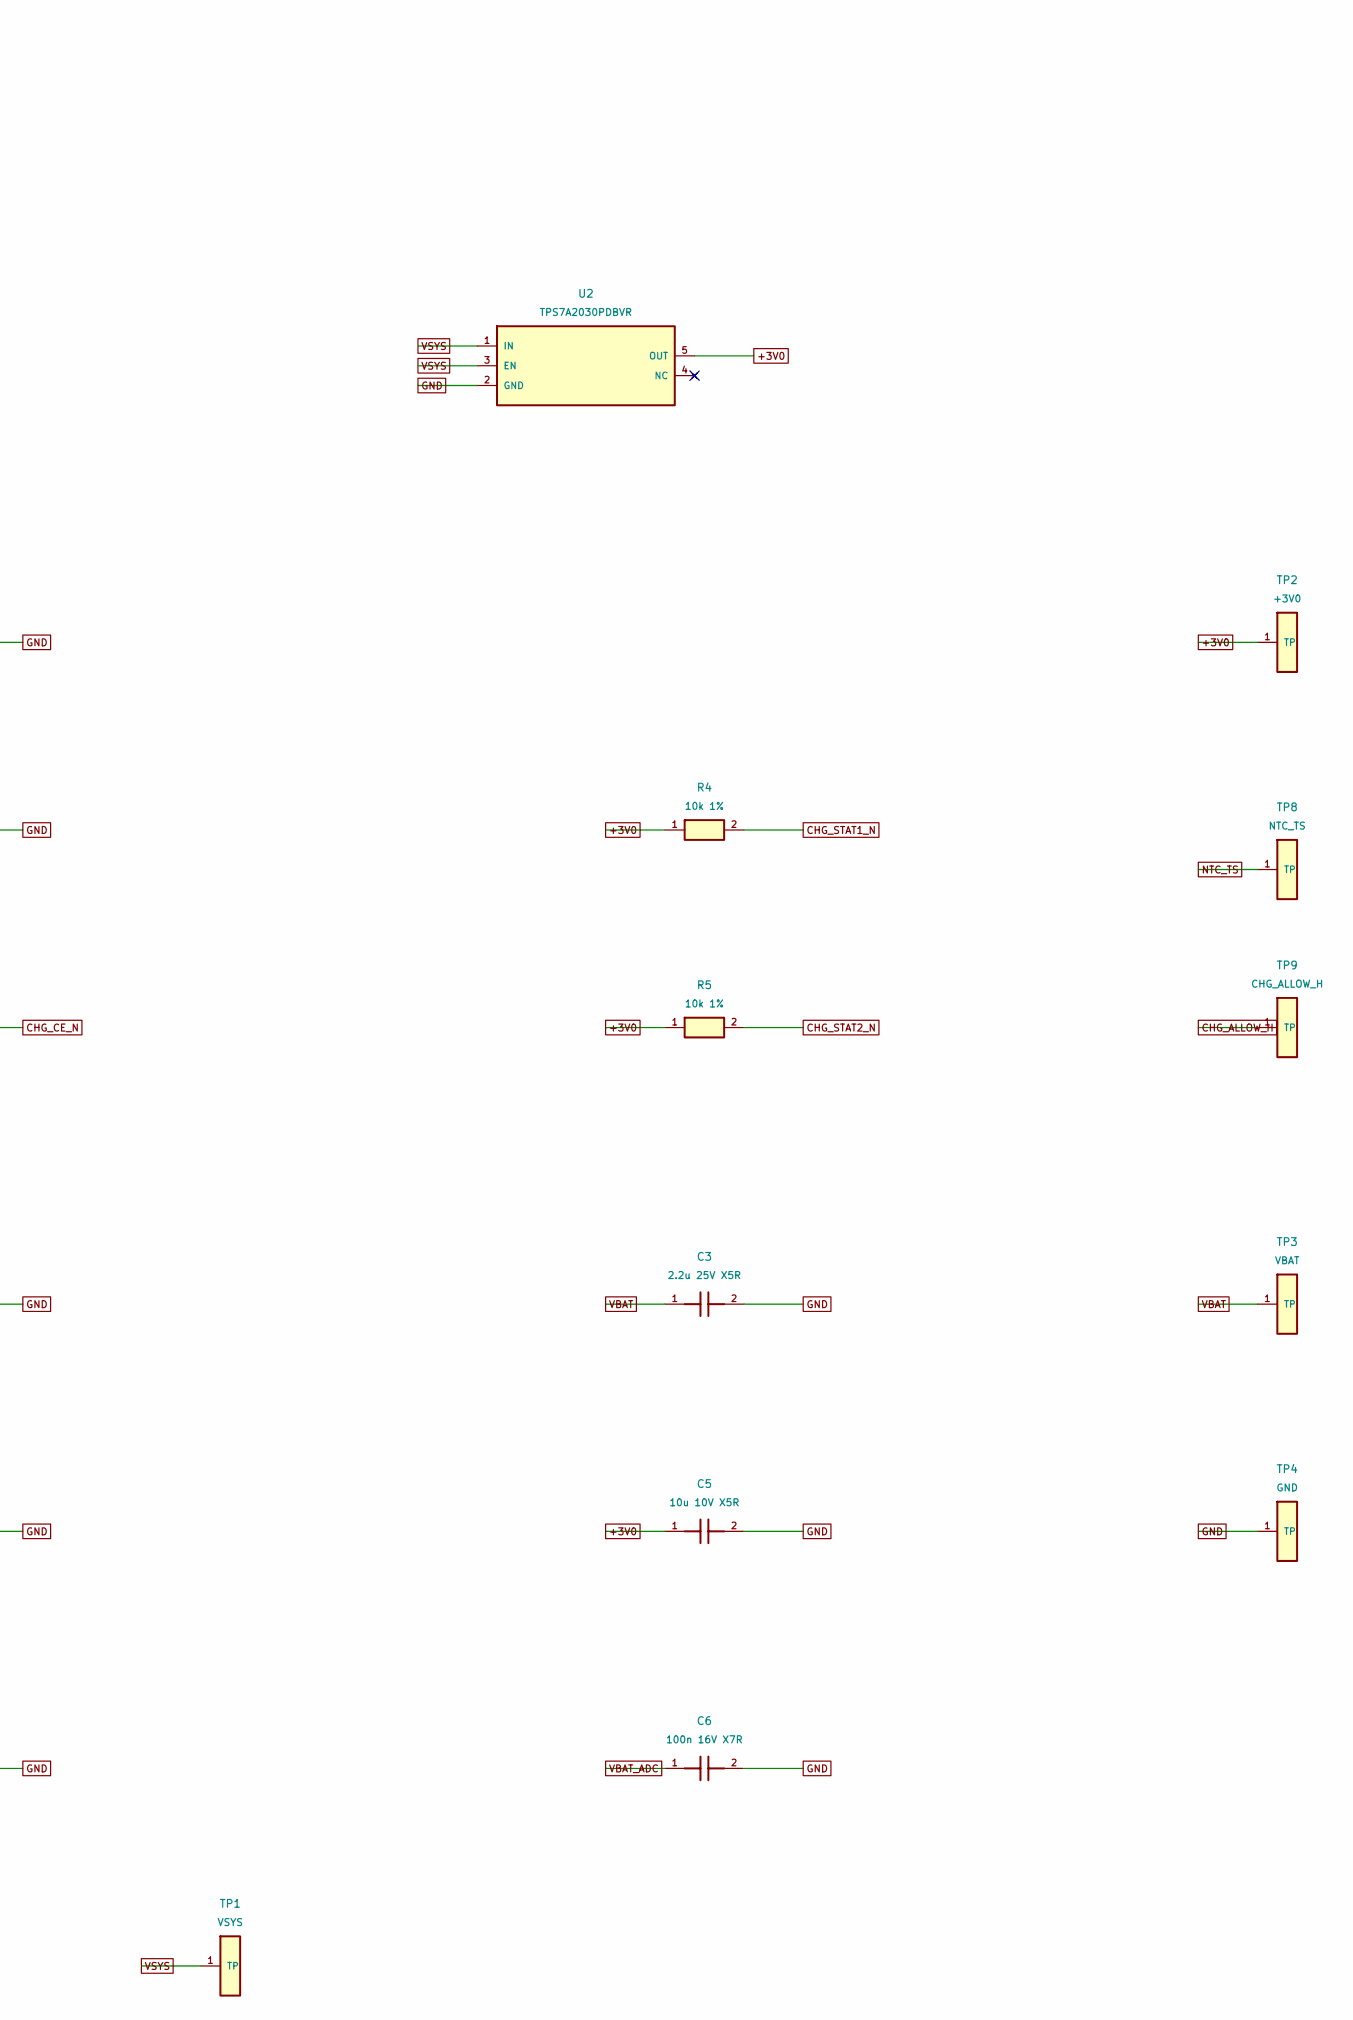
[picture p21: schematic power.kicad_sch, Ankle Sensor V1 / power, part in row 1, column 2]

Parts:
C1, C3: 2.2u 25V X5R; C_0603_1608Metric; MPN CL10A225KA8NNNC; JLCPCB C57895
C2, C5: 10u 10V X5R; C_0603_1608Metric; MPN CL10A106KP8NNNC; JLCPCB C19702
C4: 2.2u 16V X5R; C_0603_1608Metric; MPN CL10A225KO8NNNC; JLCPCB C23630
C6: 100n 16V X7R; C_0402_1005Metric; MPN CL05B104KO5NNNC; JLCPCB C1525
J2: JST_SH_3P_PACK_NTC; JST_SH_SM03B-SRSS-TB_1x03-1MP_P1.00mm_Horizontal; MPN SM03B-SRSS-TB(LF)(SN); JLCPCB C160403
R1: 24k 1%; R_0402_1005Metric; MPN 0402WGF2402TCE; JLCPCB C25769
R2: 2k 1%; R_0402_1005Metric; MPN RC0402FR-072KL; JLCPCB C60488
R3: 100k 1%; R_0402_1005Metric; MPN 0402WGF1003TCE; JLCPCB C25741
R4, R5: 10k 1%; R_0402_1005Metric; MPN 0402WGF1002TCE; JLCPCB C25744
R6, R7: 1M 1%; R_0402_1005Metric; MPN 0402WGF1004TCE; JLCPCB C26083
TP1: VSYS; TestPoint_Pad_D1.0mm
TP2: +3V0; TestPoint_Pad_D1.0mm
TP3: VBAT; TestPoint_Pad_D1.0mm
TP4: GND; TestPoint_Pad_D1.0mm
TP8: NTC_TS; TestPoint_Pad_D1.0mm
TP9: CHG_ALLOW_H; TestPoint_Pad_D1.0mm
U1: BQ25185DLHR; BQ25185DLHR_DLH0010A_TILandPattern; MPN BQ25185DLHR; JLCPCB C19725033
U2: TPS7A2030PDBVR; SOT-23-5; MPN TPS7A2030PDBVR; JLCPCB C963429

Connections:
+3V0: C5.1, R4.1, R5.1, TP2.1, U2.5 (OUT); also elsewhere on the board
CHG_ALLOW_H: TP9.1; also elsewhere on the board
CHG_CE_N: R3.2, U1.4 (nCE); also elsewhere on the board
CHG_ILIM: R1.1, U1.7 (ILIM/VSET)
CHG_ISET: R2.1, U1.8 (ISET)
CHG_STAT1_N: R4.2, U1.9 (STAT1); also elsewhere on the board
CHG_STAT2_N: R5.2, U1.3 (STAT2); also elsewhere on the board
GND: C1.2, C2.2, C3.2, C4.2, C5.2, C6.2, J2.3 (PACK-), R1.2, R2.2, R7.2, TP4.1, U1.5 (GND), U1.11 (EP_GND), U2.2 (GND); also elsewhere on the board
NTC_TS: J2.2 (NTC), TP8.1, U1.6 (TS/MR); also elsewhere on the board
VBAT: C3.1, J2.1 (PACK+), R6.1, TP3.1, U1.2 (BAT)
VBAT_ADC: C6.1, R6.2, R7.1; also elsewhere on the board
VBUS: C1.1, U1.10 (IN); also elsewhere on the board
VSYS: C2.1, C4.1, R3.1, TP1.1, U1.1 (SYS), U2.1 (IN), U2.3 (EN)

Notes on the sheet:
POWER PATH / BATTERY - REVIEW DRAFT
4.2V protected1S pack only. 100mA USB input limit. 150mA ISET is dynamically reduced.
See temperature sheet for independent NTC window. Pack/NTC qualification is mandatory.

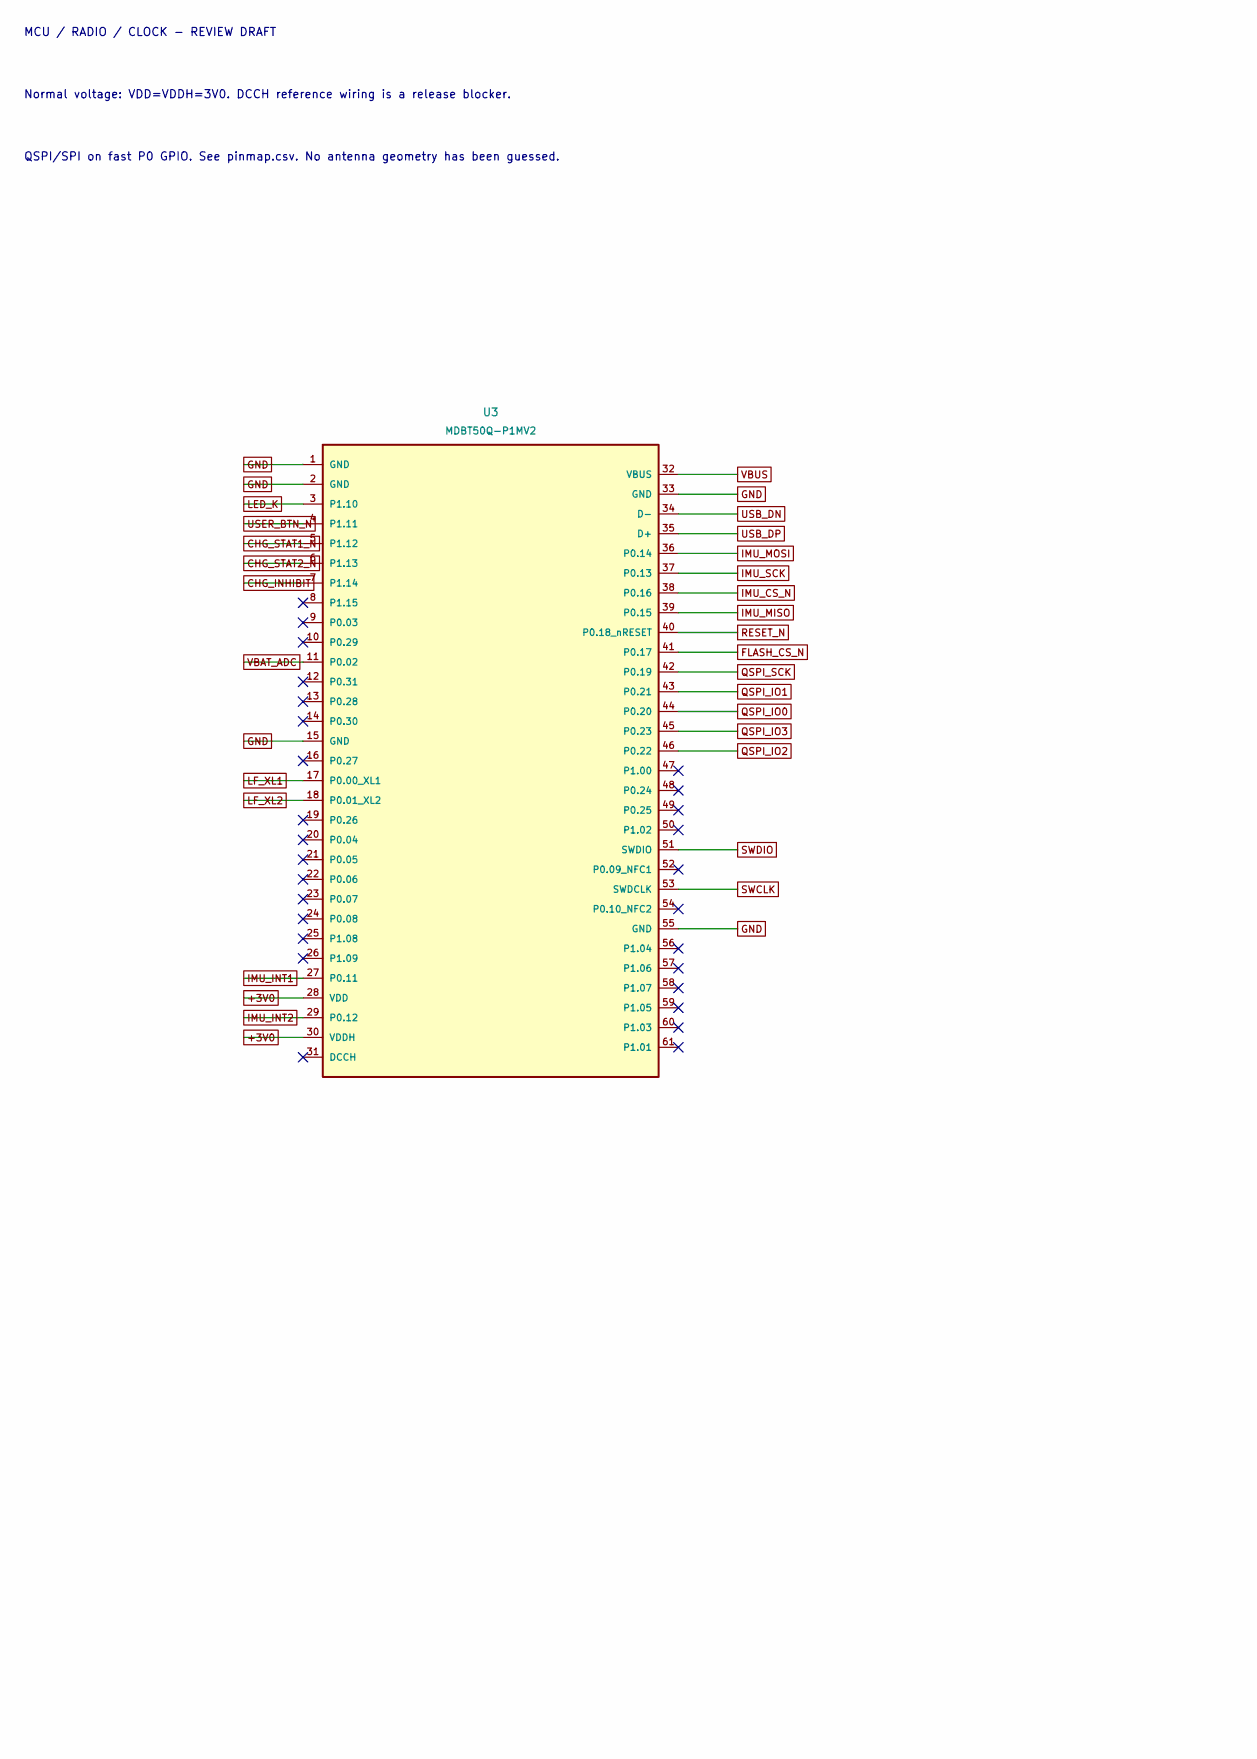
[picture p22: schematic mcu.kicad_sch, Ankle Sensor V1 / mcu, part in row 1, column 1]

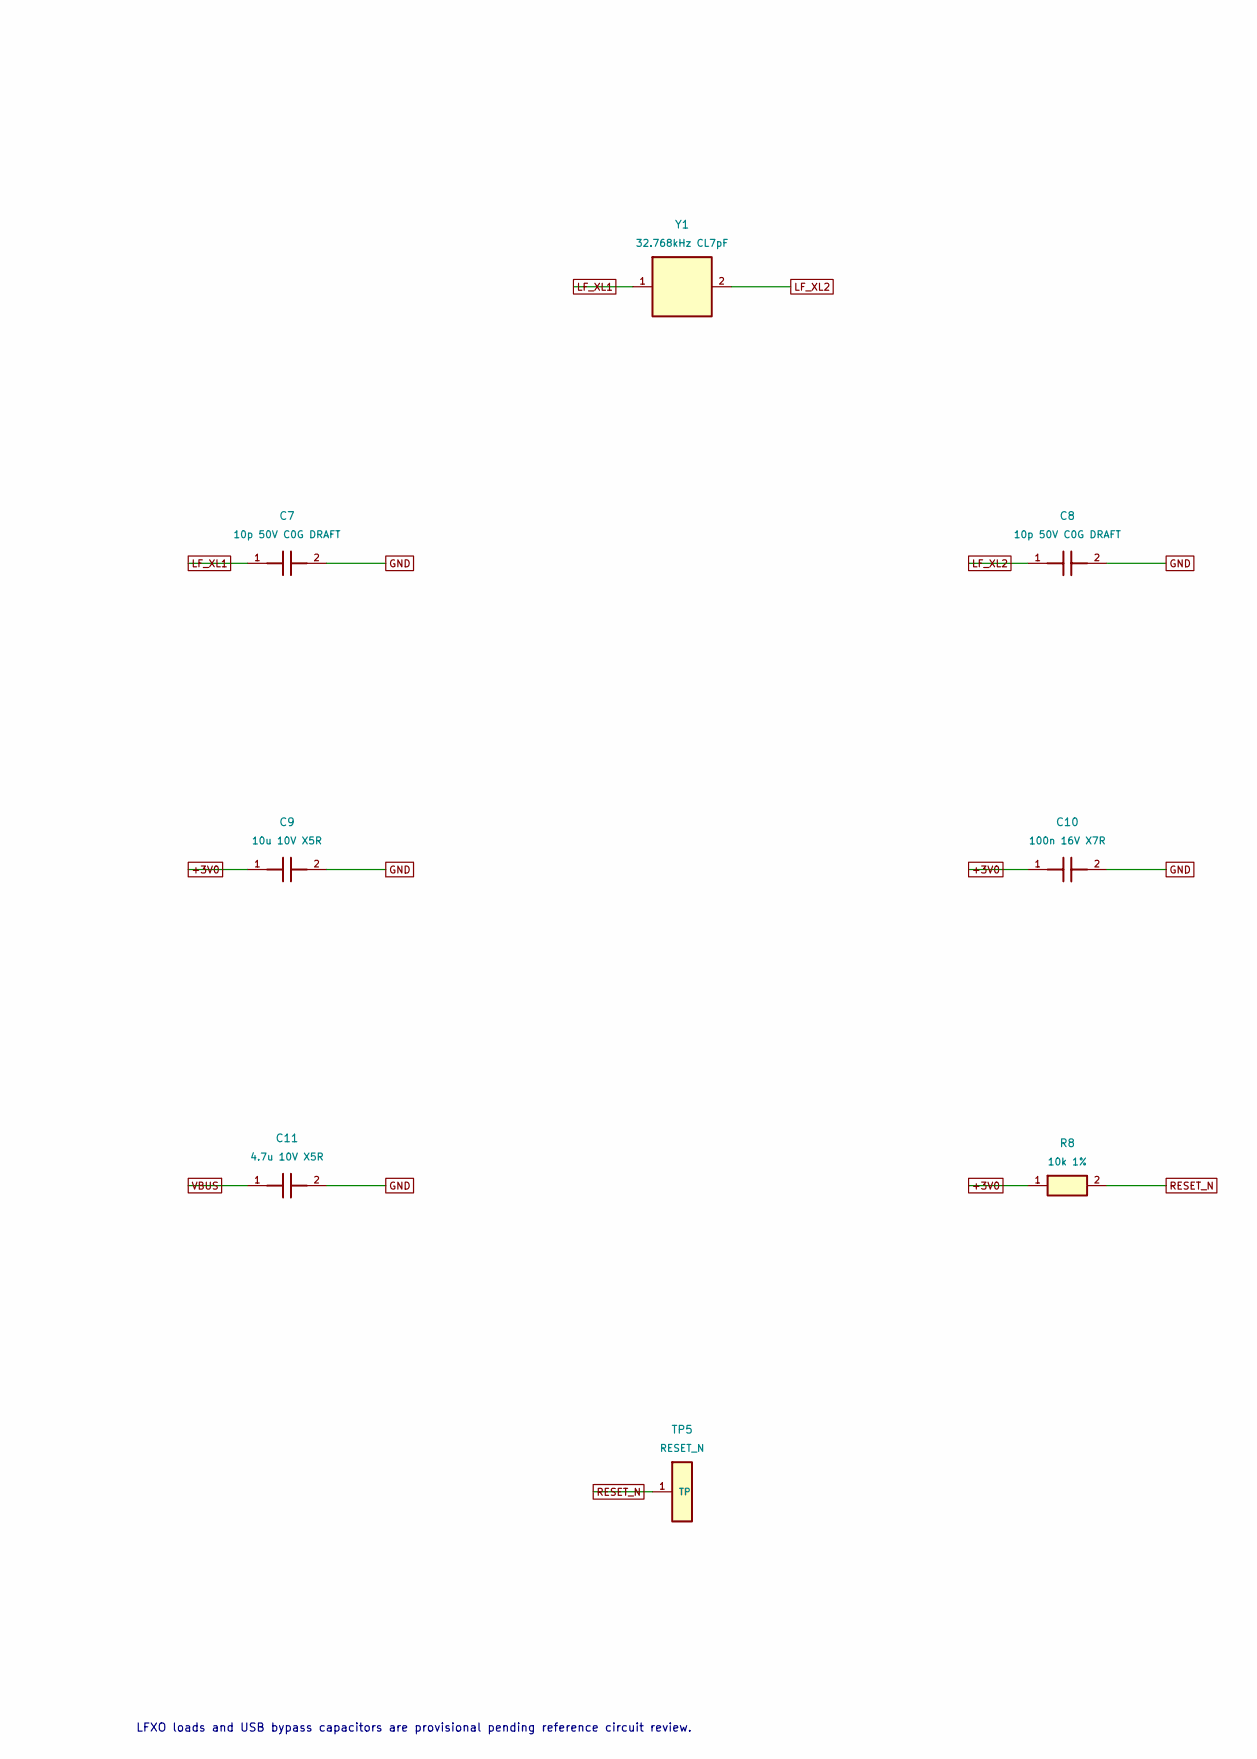
[picture p23: schematic mcu.kicad_sch, Ankle Sensor V1 / mcu, part in row 1, column 2]

Parts:
C7, C8: 10p 50V C0G DRAFT; C_0402_1005Metric; MPN CL05C100JB5NNNC; JLCPCB C32949
C9: 10u 10V X5R; C_0603_1608Metric; MPN CL10A106KP8NNNC; JLCPCB C19702
C10: 100n 16V X7R; C_0402_1005Metric; MPN CL05B104KO5NNNC; JLCPCB C1525
C11: 4.7u 10V X5R; C_0603_1608Metric; MPN CL10A475KP8NNNC; JLCPCB C1705
R8: 10k 1%; R_0402_1005Metric; MPN 0402WGF1002TCE; JLCPCB C25744
TP5: RESET_N; TestPoint_Pad_D1.0mm
U3: MDBT50Q-P1MV2; Raytac_MDBT50Q; MPN MDBT50Q-P1MV2; JLCPCB C5119772
Y1: 32.768kHz CL7pF; Crystal_SMD_3215-2Pin_3.2x1.5mm; MPN ABS07-32.768KHZ-7-T; JLCPCB C276424

Connections:
+3V0: C9.1, C10.1, R8.1, U3.28 (VDD), U3.30 (VDDH); also elsewhere on the board
CHG_INHIBIT: U3.7 (P1.14); also elsewhere on the board
CHG_STAT1_N: U3.5 (P1.12); also elsewhere on the board
CHG_STAT2_N: U3.6 (P1.13); also elsewhere on the board
FLASH_CS_N: U3.41 (P0.17); also elsewhere on the board
GND: C7.2, C8.2, C9.2, C10.2, C11.2, U3.1 (GND), U3.2 (GND), U3.15 (GND), U3.33 (GND), U3.55 (GND); also elsewhere on the board
IMU_CS_N: U3.38 (P0.16); also elsewhere on the board
IMU_INT1: U3.27 (P0.11); also elsewhere on the board
IMU_INT2: U3.29 (P0.12); also elsewhere on the board
IMU_MISO: U3.39 (P0.15); also elsewhere on the board
IMU_MOSI: U3.36 (P0.14); also elsewhere on the board
IMU_SCK: U3.37 (P0.13); also elsewhere on the board
LED_K: U3.3 (P1.10); also elsewhere on the board
LF_XL1: C7.1, U3.17 (P0.00_XL1), Y1.1
LF_XL2: C8.1, U3.18 (P0.01_XL2), Y1.2
QSPI_IO0: U3.44 (P0.20); also elsewhere on the board
QSPI_IO1: U3.43 (P0.21); also elsewhere on the board
QSPI_IO2: U3.46 (P0.22); also elsewhere on the board
QSPI_IO3: U3.45 (P0.23); also elsewhere on the board
QSPI_SCK: U3.42 (P0.19); also elsewhere on the board
RESET_N: R8.2, TP5.1, U3.40 (P0.18_nRESET); also elsewhere on the board
SWCLK: U3.53 (SWDCLK); also elsewhere on the board
SWDIO: U3.51 (SWDIO); also elsewhere on the board
USB_DN: U3.34 (D-); also elsewhere on the board
USB_DP: U3.35 (D+); also elsewhere on the board
USER_BTN_N: U3.4 (P1.11); also elsewhere on the board
VBAT_ADC: U3.11 (P0.02); also elsewhere on the board
VBUS: C11.1, U3.32 (VBUS); also elsewhere on the board

Notes on the sheet:
MCU / RADIO / CLOCK - REVIEW DRAFT
Normal voltage: VDD=VDDH=3V0. DCCH reference wiring is a release blocker.
QSPI/SPI on fast P0 GPIO. See pinmap.csv. No antenna geometry has been guessed.
LFXO loads and USB bypass capacitors are provisional pending reference circuit review.

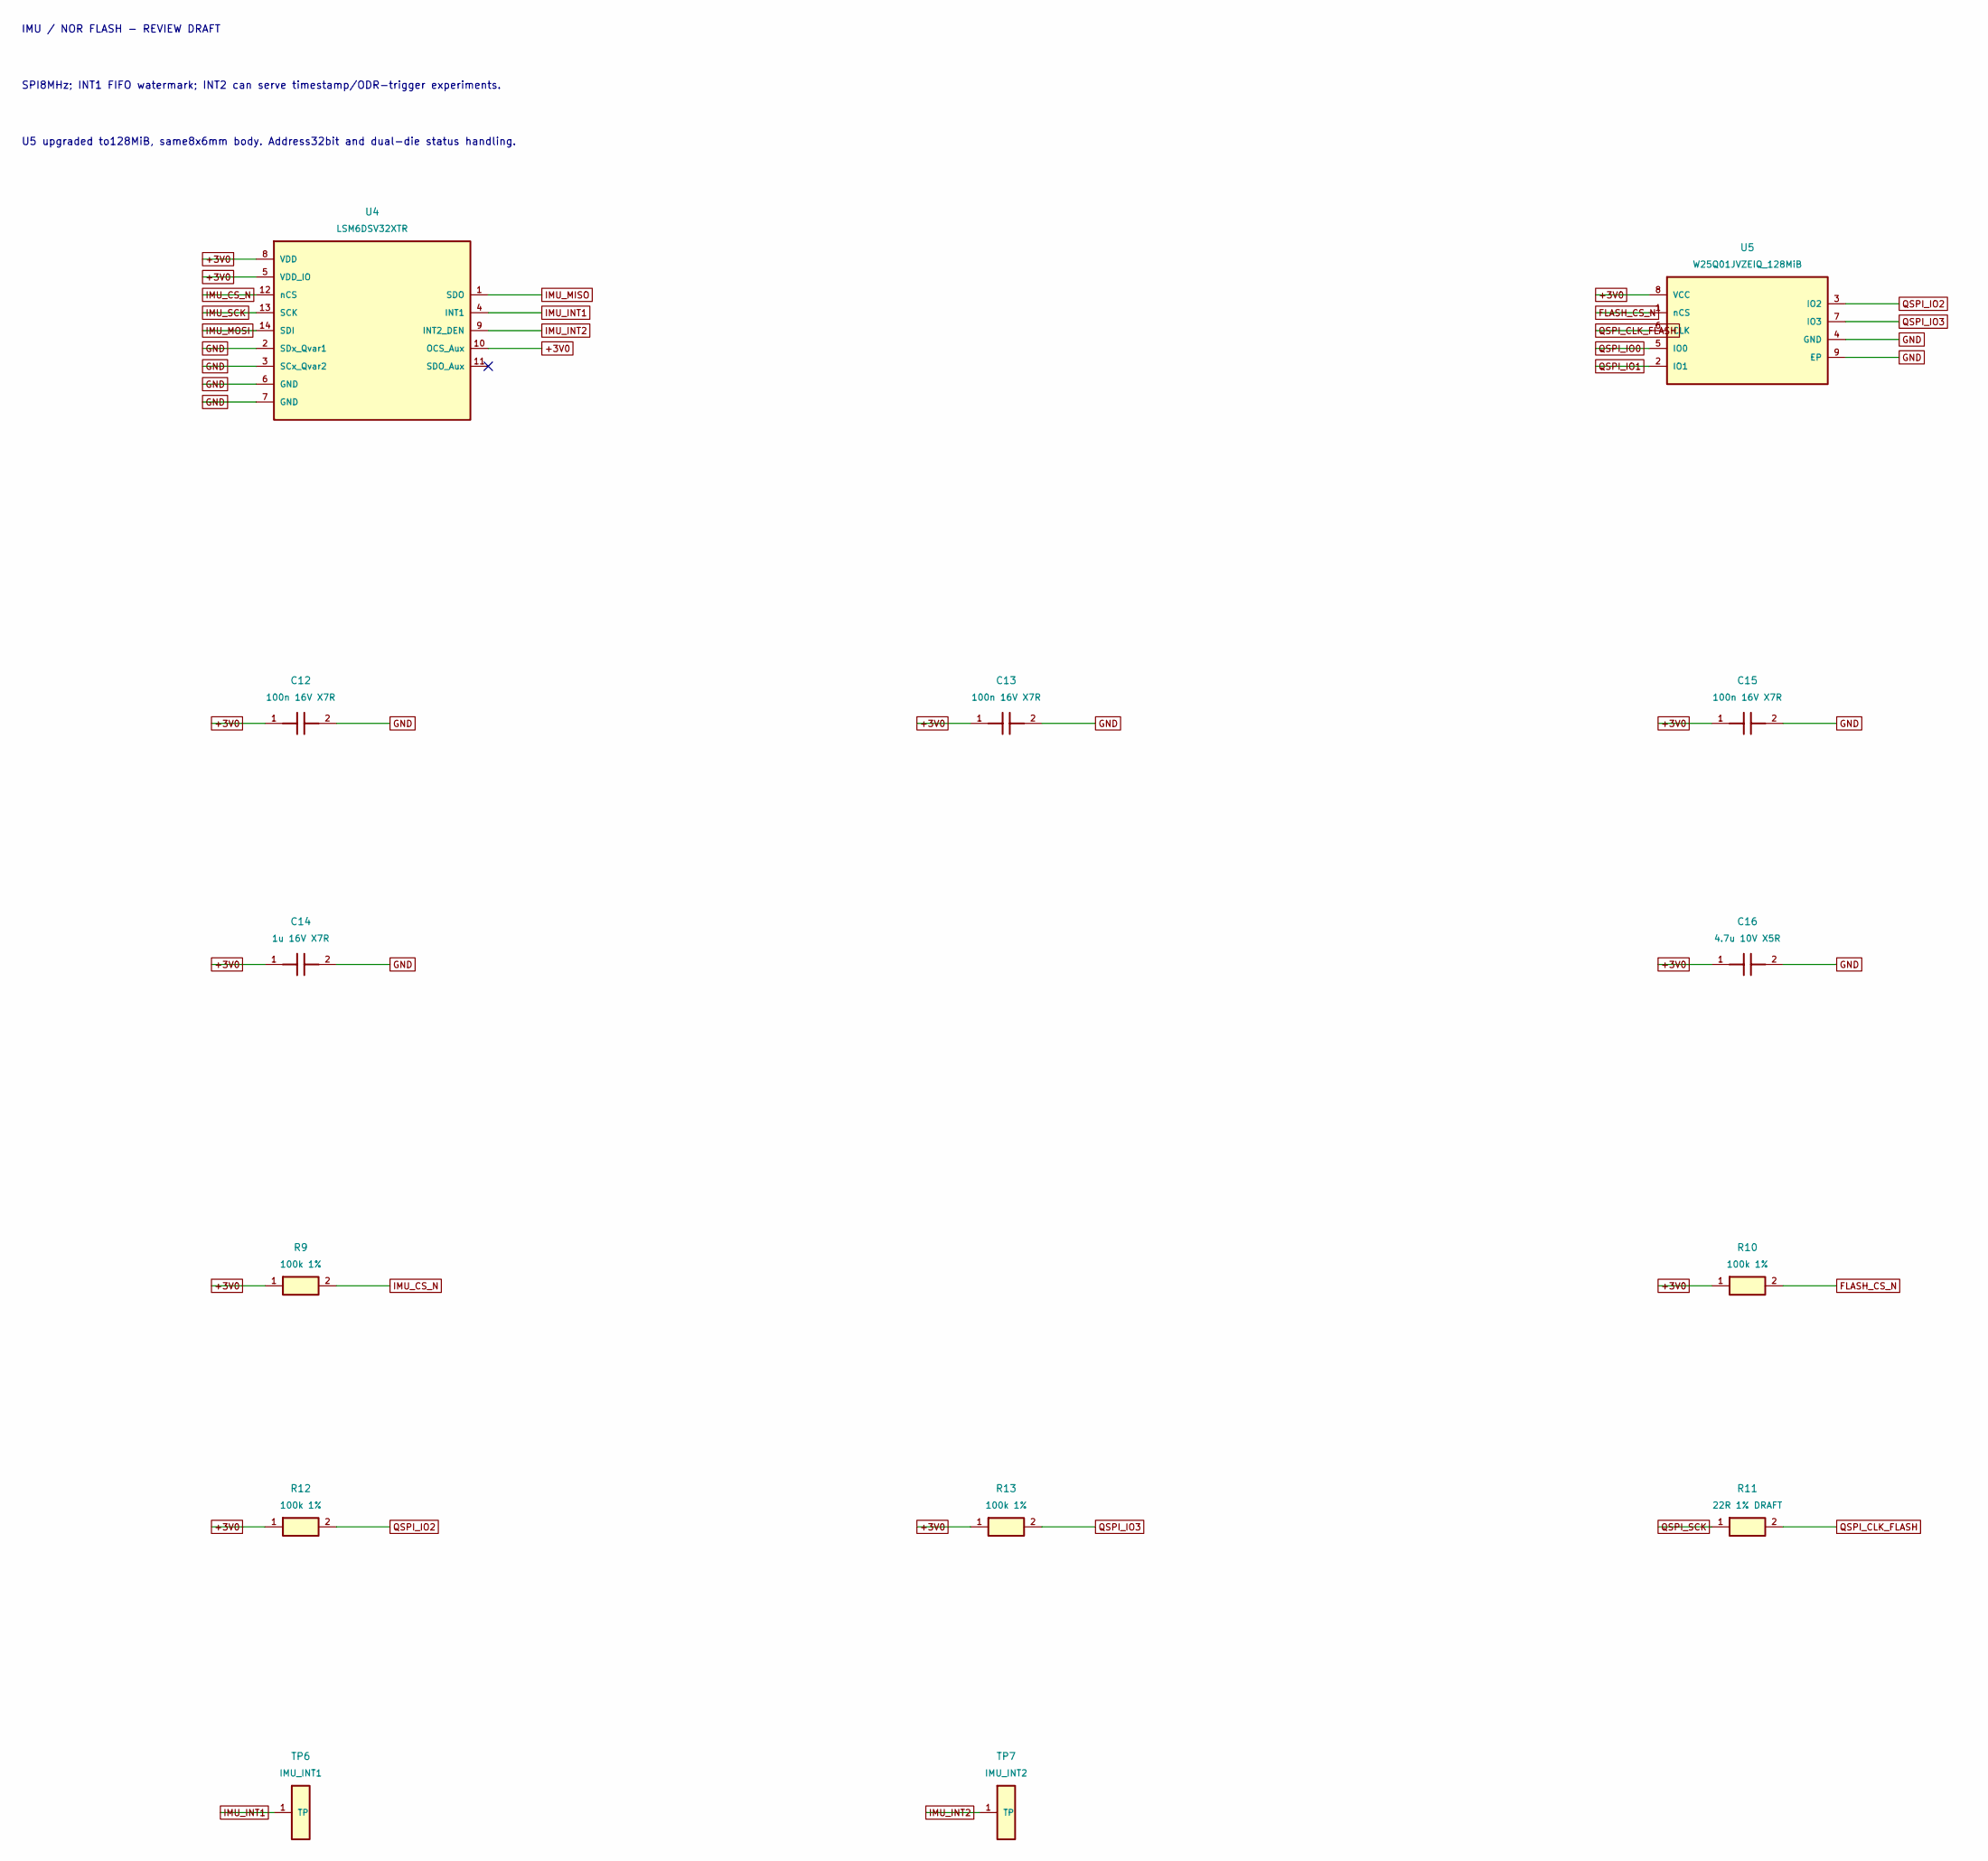
[picture p24: schematic sensors.kicad_sch, Ankle Sensor V1 / sensors]

Parts:
C12, C13, C15: 100n 16V X7R; C_0402_1005Metric; MPN CL05B104KO5NNNC; JLCPCB C1525
C14: 1u 16V X7R; C_0603_1608Metric; MPN CC0603KRX7R7BB105; JLCPCB C106248
C16: 4.7u 10V X5R; C_0603_1608Metric; MPN CL10A475KP8NNNC; JLCPCB C1705
R9, R10, R12, R13: 100k 1%; R_0402_1005Metric; MPN 0402WGF1003TCE; JLCPCB C25741
R11: 22R 1% DRAFT; R_0402_1005Metric; MPN 0402WGF220JTCE; JLCPCB C25092
TP6: IMU_INT1; TestPoint_Pad_D1.0mm
TP7: IMU_INT2; TestPoint_Pad_D1.0mm
U4: LSM6DSV32XTR; ST_LSM6DSV32X_LGA14_3x2.5mm_P0.5mm; MPN LSM6DSV32XTR; JLCPCB C22461202
U5: W25Q01JVZEIQ_128MiB; WSON-8-1EP_8x6mm_P1.27mm_EP3.4x4.3mm; MPN W25Q01JVZEIQ; JLCPCB C5137036

Connections:
+3V0: C12.1, C13.1, C14.1, C15.1, C16.1, R9.1, R10.1, R12.1, R13.1, U4.5 (VDD_IO), U4.8 (VDD), U4.10 (OCS_Aux), U5.8 (VCC); also elsewhere on the board
FLASH_CS_N: R10.2, U5.1 (nCS); also elsewhere on the board
GND: C12.2, C13.2, C14.2, C15.2, C16.2, U4.2 (SDx_Qvar1), U4.3 (SCx_Qvar2), U4.6 (GND), U4.7 (GND), U5.4 (GND), U5.9 (EP); also elsewhere on the board
IMU_CS_N: R9.2, U4.12 (nCS); also elsewhere on the board
IMU_INT1: TP6.1, U4.4 (INT1); also elsewhere on the board
IMU_INT2: TP7.1, U4.9 (INT2_DEN); also elsewhere on the board
IMU_MISO: U4.1 (SDO); also elsewhere on the board
IMU_MOSI: U4.14 (SDI); also elsewhere on the board
IMU_SCK: U4.13 (SCK); also elsewhere on the board
QSPI_CLK_FLASH: R11.2, U5.6 (CLK)
QSPI_IO0: U5.5 (IO0); also elsewhere on the board
QSPI_IO1: U5.2 (IO1); also elsewhere on the board
QSPI_IO2: R12.2, U5.3 (IO2); also elsewhere on the board
QSPI_IO3: R13.2, U5.7 (IO3); also elsewhere on the board
QSPI_SCK: R11.1; also elsewhere on the board

Notes on the sheet:
IMU / NOR FLASH - REVIEW DRAFT
SPI8MHz; INT1 FIFO watermark; INT2 can serve timestamp/ODR-trigger experiments.
U5 upgraded to128MiB, same8x6mm body. Address32bit and dual-die status handling.
