TomKuc/ASV1/hardware/Ankle_Sensor_V1.kicad_pcb

## KiCad design hardware/Ankle_Sensor_V1.kicad_pcb (continued)

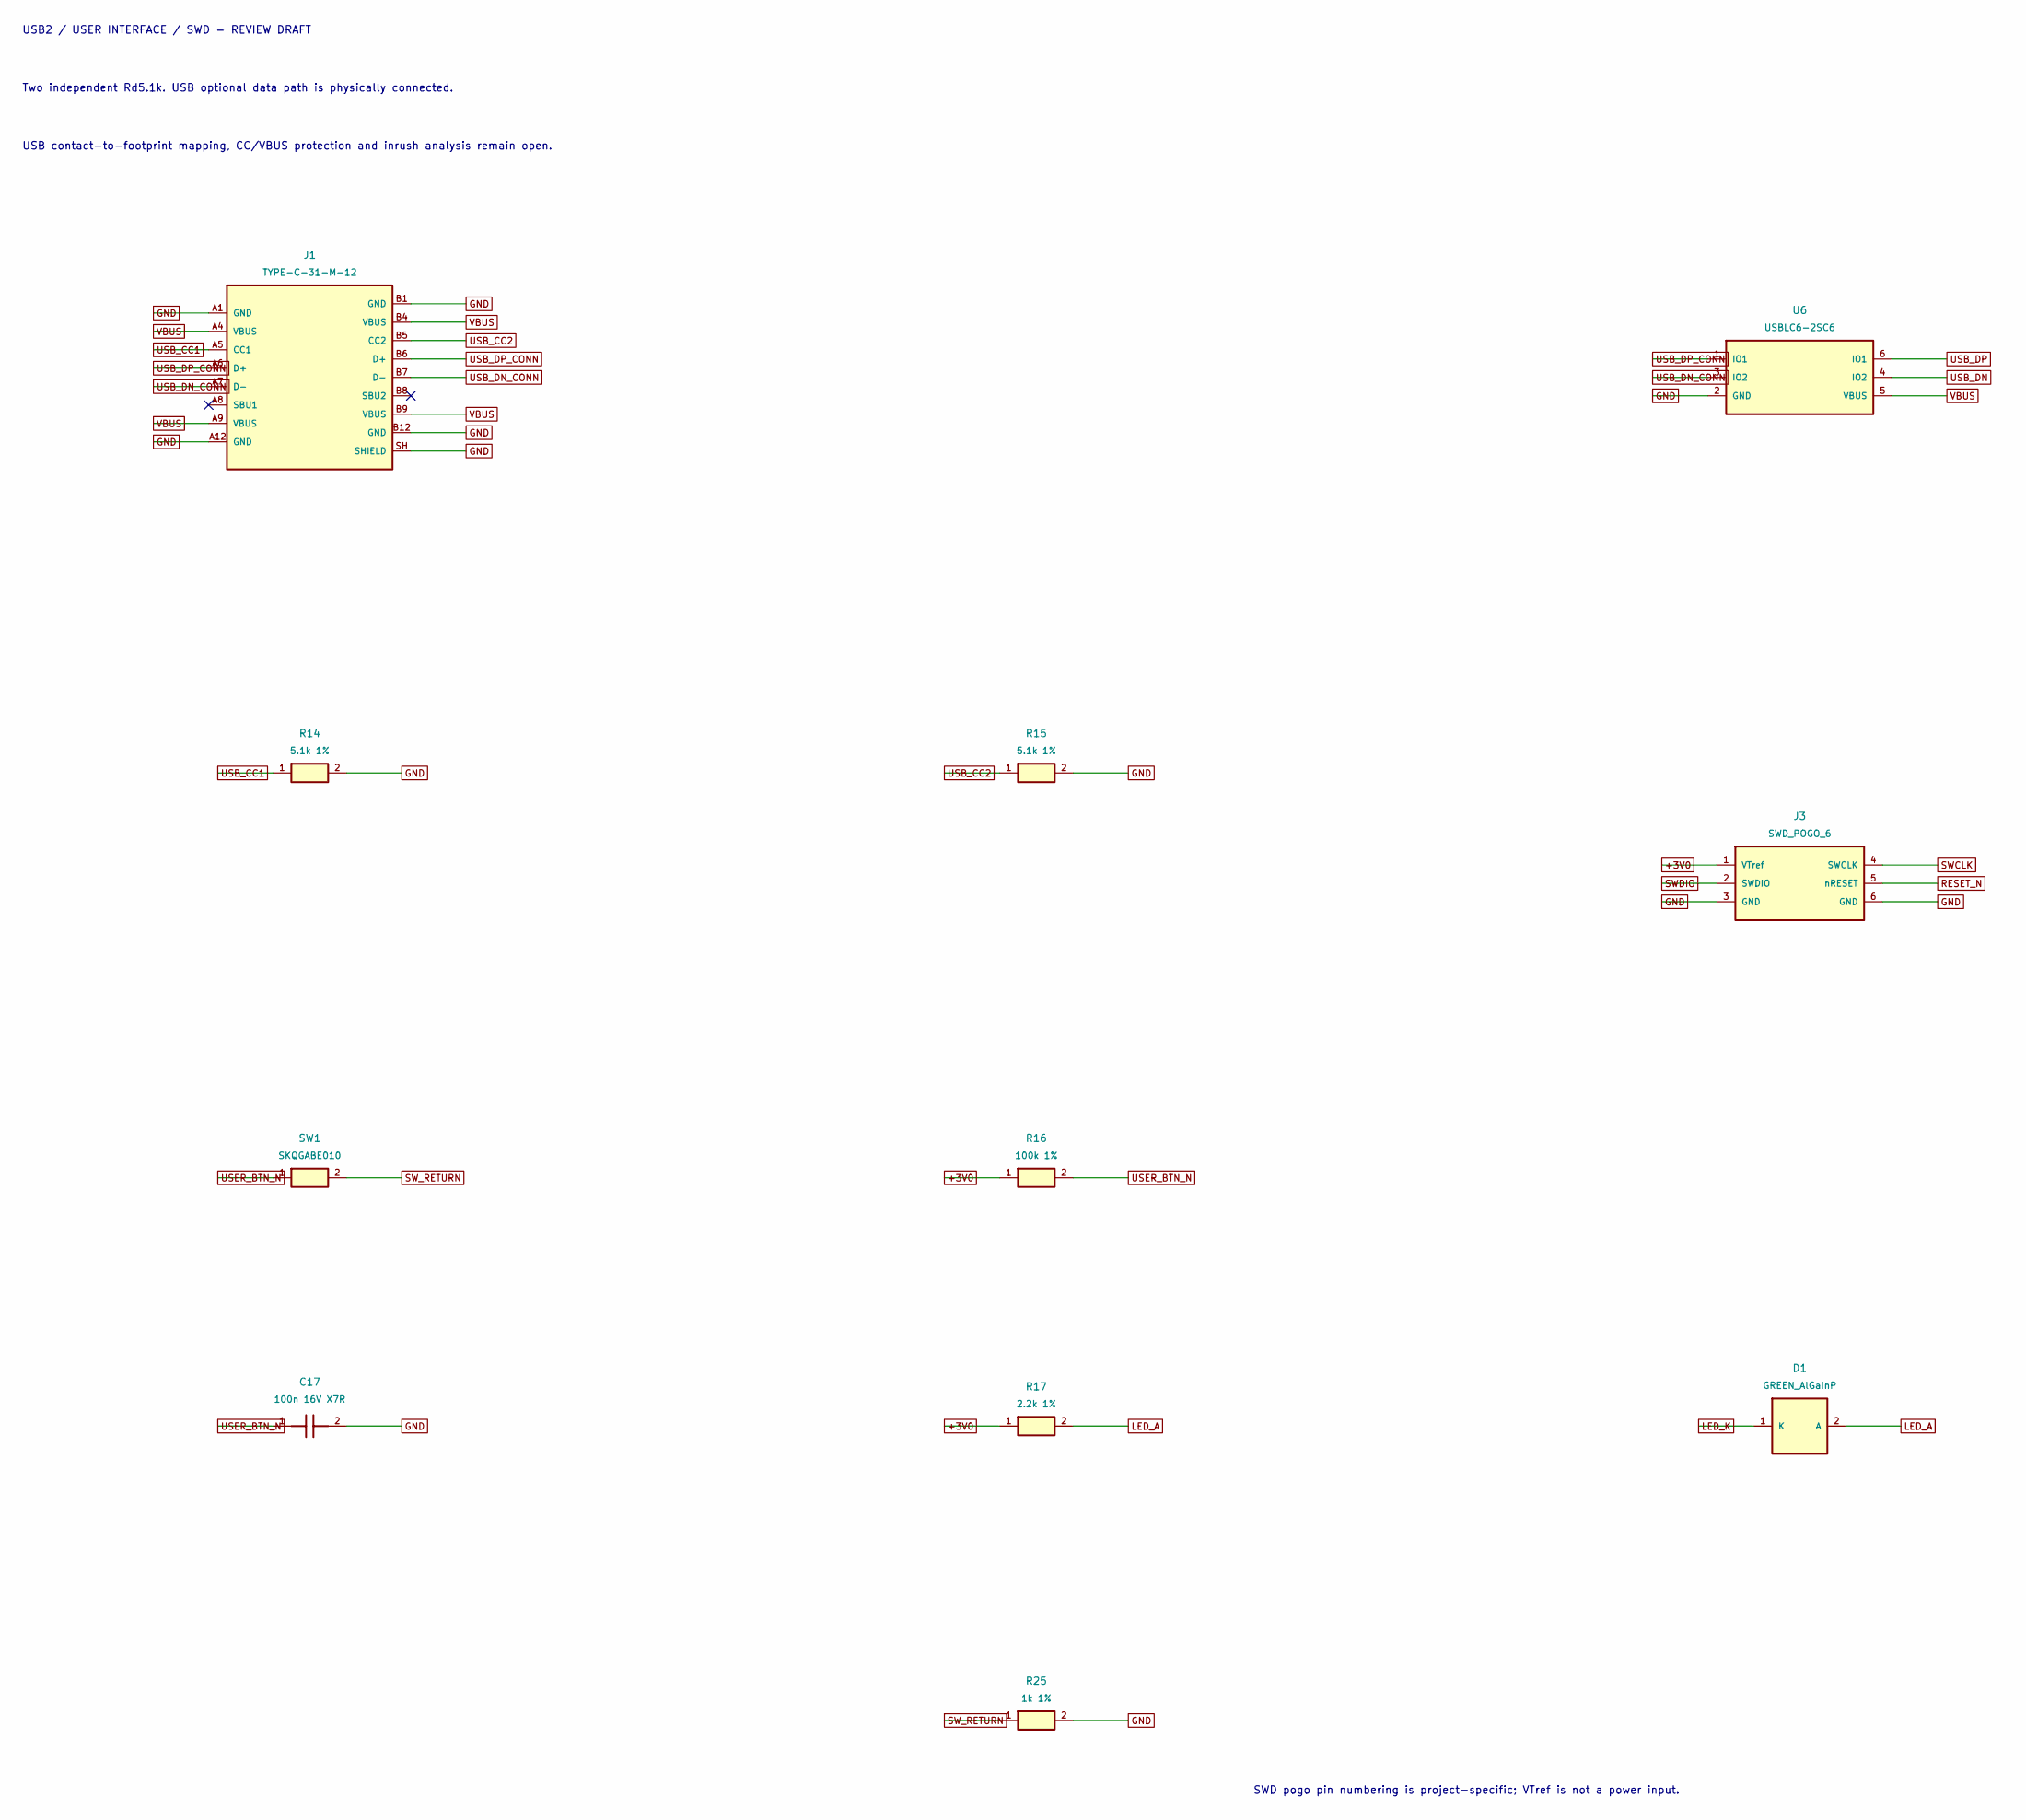
[picture p25: schematic io.kicad_sch, Ankle Sensor V1 / io]

Parts:
C17: 100n 16V X7R; C_0402_1005Metric; MPN CL05B104KO5NNNC; JLCPCB C1525
D1: GREEN_AlGaInP; LED_0603_1608Metric; MPN 19-217/G7C-AN1P2/6T; JLCPCB C2986030
J1: TYPE-C-31-M-12; USB_C_Receptacle_HRO_TYPE-C-31-M-12; MPN TYPE-C-31-M-12; JLCPCB C165948
J3: SWD_POGO_6; SWD_Pogo_2x03_P2.54mm
R14, R15: 5.1k 1%; R_0402_1005Metric; MPN 0402WGF5101TCE; JLCPCB C25905
R16: 100k 1%; R_0402_1005Metric; MPN 0402WGF1003TCE; JLCPCB C25741
R17: 2.2k 1%; R_0402_1005Metric; MPN 0402WGF2201TCE; JLCPCB C25879
R25: 1k 1%; R_0402_1005Metric; MPN 0402WGF1001TCE; JLCPCB C11702
SW1: SKQGABE010; SW_SPST_SKQG_WithStem; MPN SKQGABE010; JLCPCB C115351
U6: USBLC6-2SC6; SOT-23-6; MPN USBLC6-2SC6; JLCPCB C7519

Connections:
+3V0: J3.1 (VTref), R16.1, R17.1; also elsewhere on the board
GND: C17.2, J1.A1 (GND), J1.A12 (GND), J1.B1 (GND), J1.B12 (GND), J1.SH (SHIELD), J3.3 (GND), J3.6 (GND), R14.2, R15.2, R25.2, U6.2 (GND); also elsewhere on the board
LED_A: D1.2 (A), R17.2
LED_K: D1.1 (K); also elsewhere on the board
RESET_N: J3.5 (nRESET); also elsewhere on the board
SWCLK: J3.4 (SWCLK); also elsewhere on the board
SWDIO: J3.2 (SWDIO); also elsewhere on the board
SW_RETURN: R25.1, SW1.2
USB_CC1: J1.A5 (CC1), R14.1
USB_CC2: J1.B5 (CC2), R15.1
USB_DN: U6.4 (IO2); also elsewhere on the board
USB_DN_CONN: J1.A7 (D-), J1.B7 (D-), U6.3 (IO2)
USB_DP: U6.6 (IO1); also elsewhere on the board
USB_DP_CONN: J1.A6 (D+), J1.B6 (D+), U6.1 (IO1)
USER_BTN_N: C17.1, R16.2, SW1.1; also elsewhere on the board
VBUS: J1.A4 (VBUS), J1.A9 (VBUS), J1.B4 (VBUS), J1.B9 (VBUS), U6.5 (VBUS); also elsewhere on the board

Notes on the sheet:
USB2 / USER INTERFACE / SWD - REVIEW DRAFT
Two independent Rd5.1k. USB optional data path is physically connected.
USB contact-to-footprint mapping, CC/VBUS protection and inrush analysis remain open.
SWD pogo pin numbering is project-specific; VTref is not a power input.

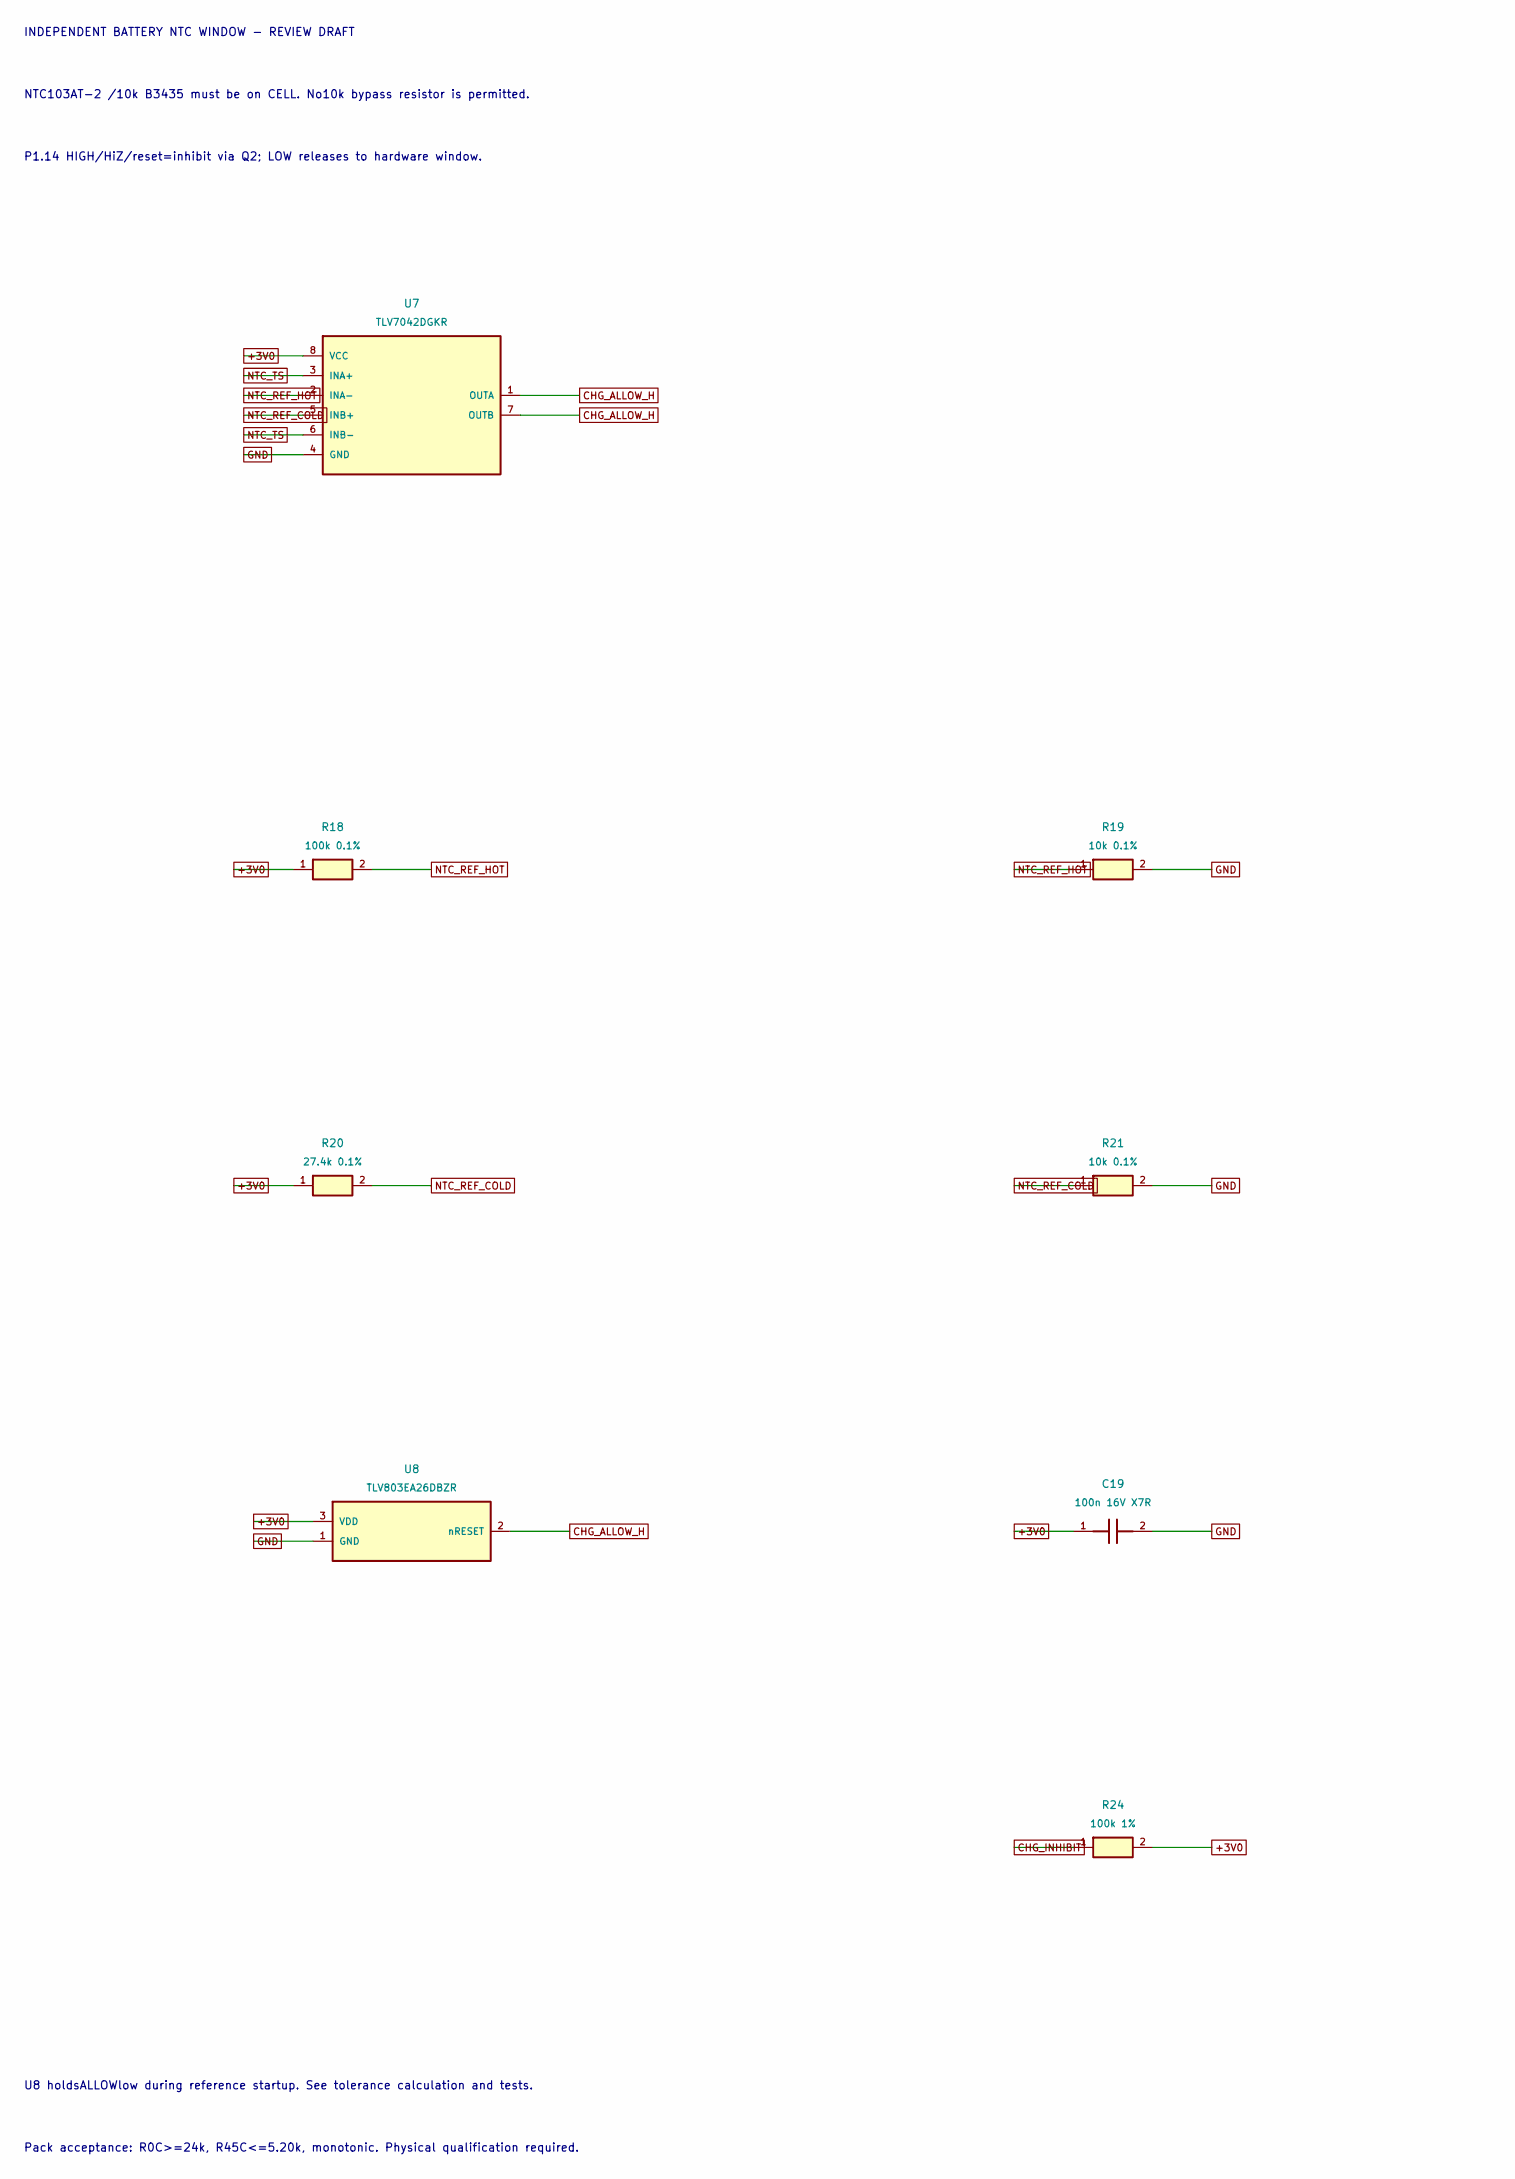
[picture p26: schematic temperature.kicad_sch, Ankle Sensor V1 / temperature, part in row 1, column 1]

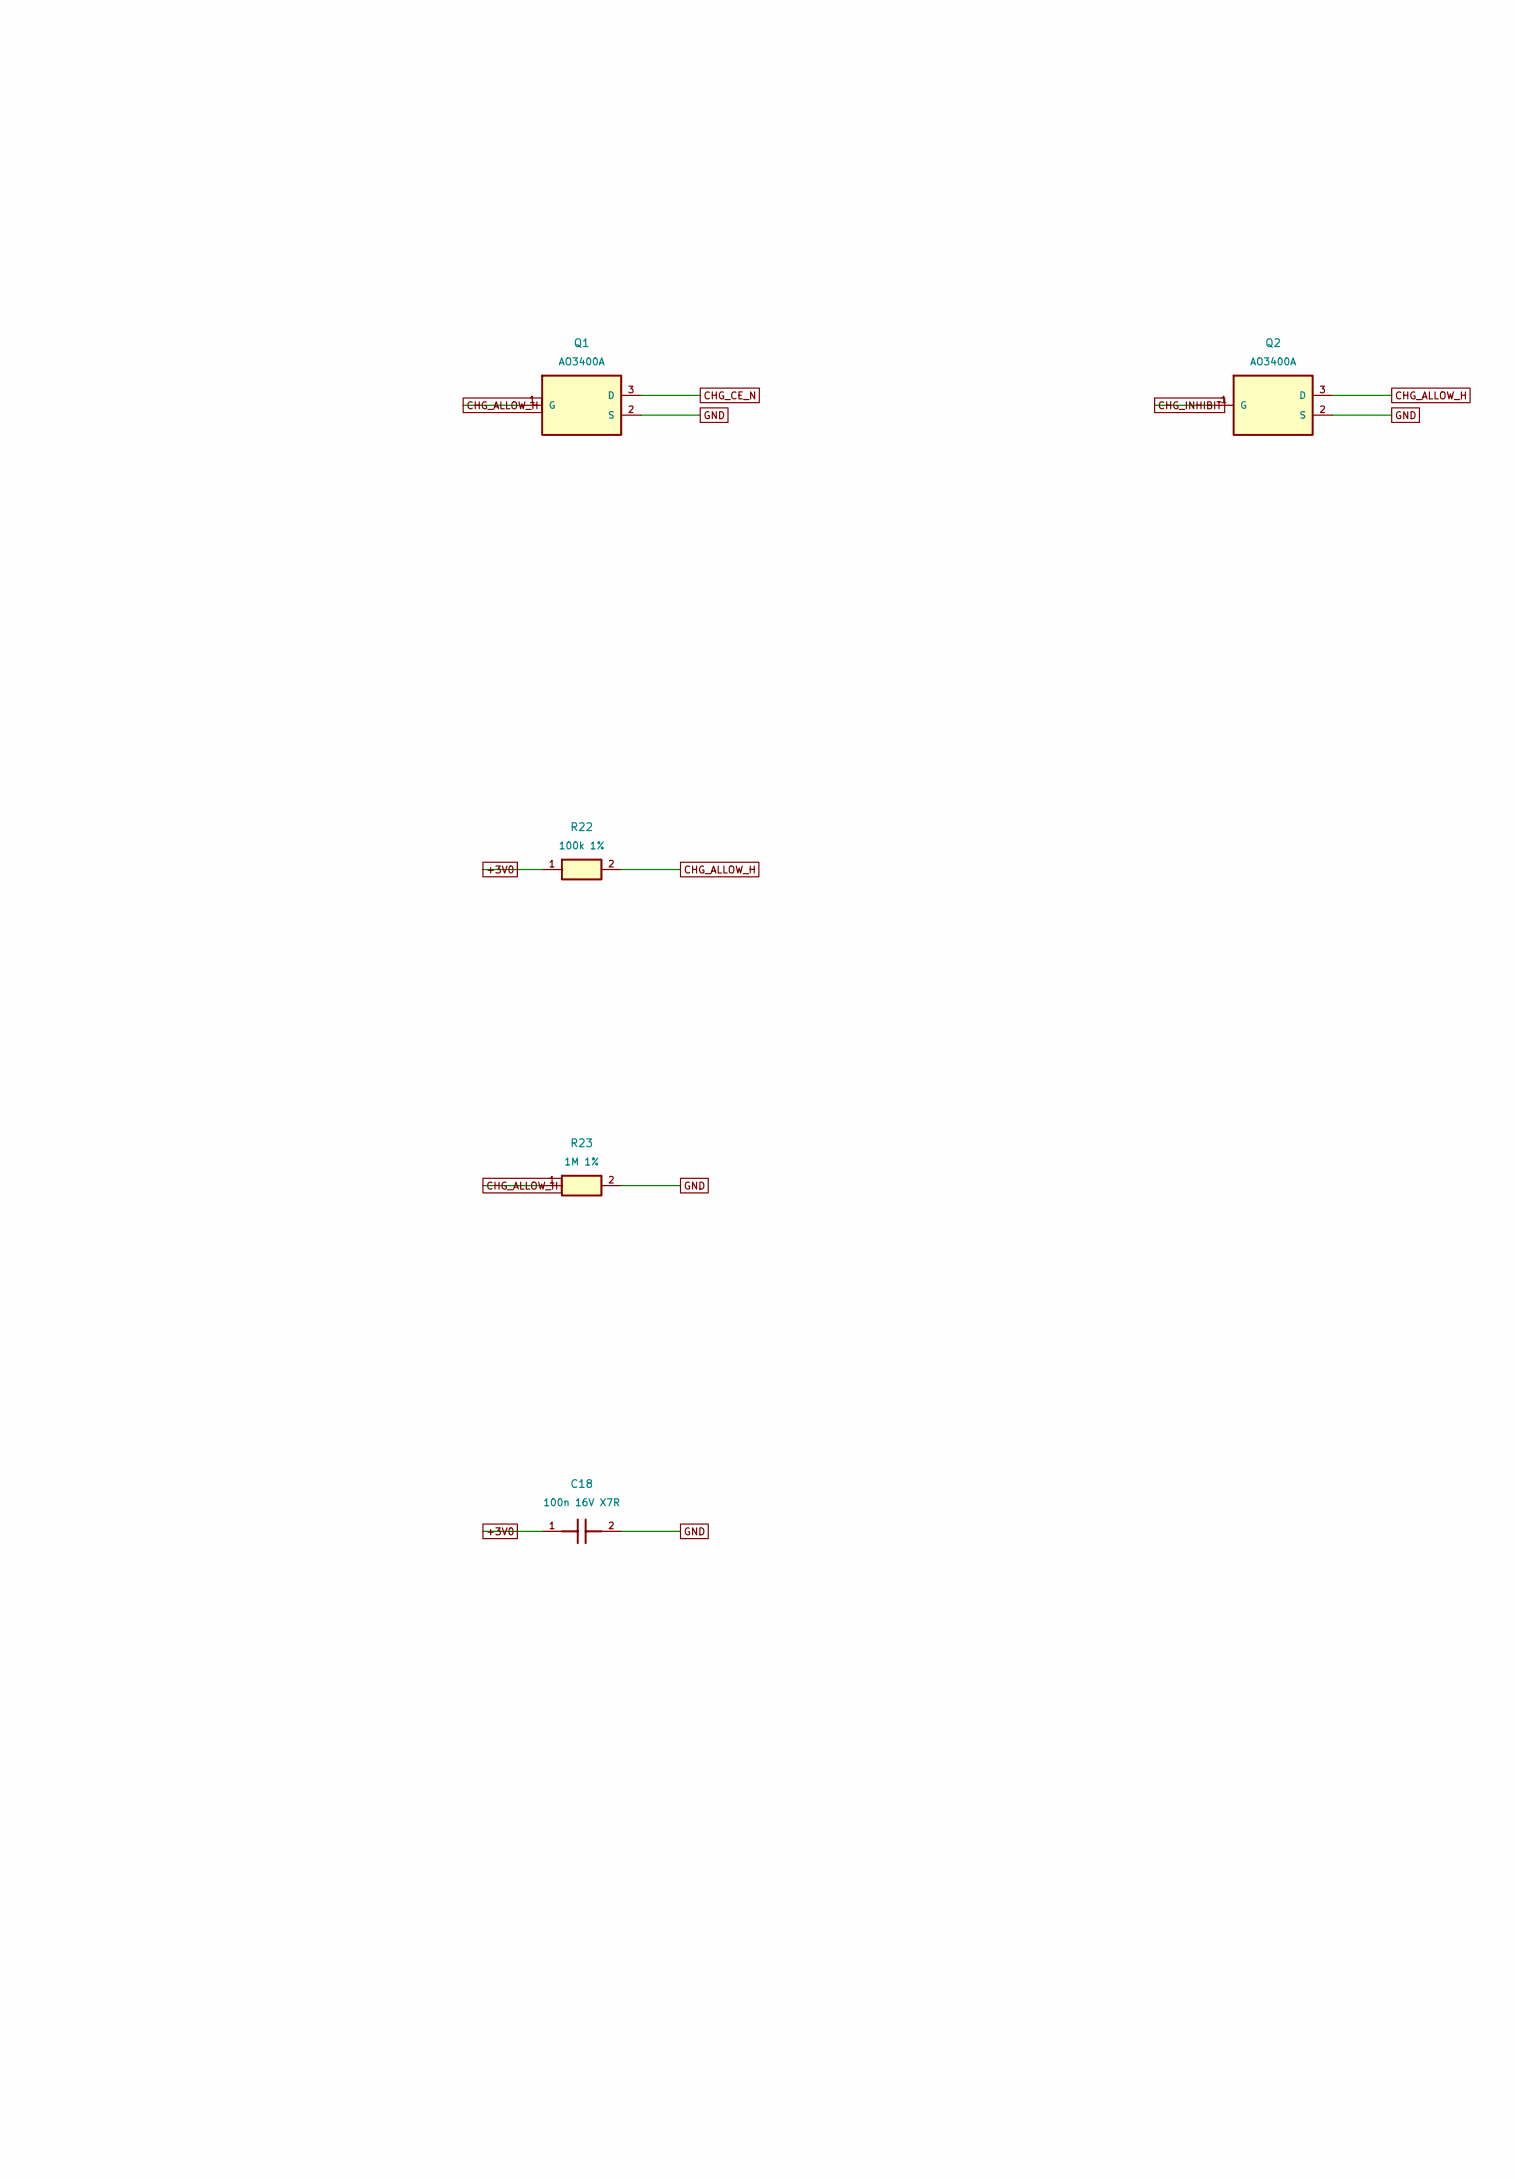
[picture p27: schematic temperature.kicad_sch, Ankle Sensor V1 / temperature, part in row 1, column 2]

Parts:
C18, C19: 100n 16V X7R; C_0402_1005Metric; MPN CL05B104KO5NNNC; JLCPCB C1525
Q1, Q2: AO3400A; SOT-23; MPN AO3400A; JLCPCB C20917
R18: 100k 0.1%; R_0402_1005Metric; MPN ERA2AEB104X; JLCPCB C445619
R19, R21: 10k 0.1%; R_0402_1005Metric; MPN RT0402BRD0710KL; JLCPCB C190095
R20: 27.4k 0.1%; R_0402_1005Metric; MPN RT0402BRD0727K4L; JLCPCB C852679
R22, R24: 100k 1%; R_0402_1005Metric; MPN 0402WGF1003TCE; JLCPCB C25741
R23: 1M 1%; R_0402_1005Metric; MPN 0402WGF1004TCE; JLCPCB C26083
U7: TLV7042DGKR; VSSOP-8_3x3mm_P0.65mm; MPN TLV7042DGKR; JLCPCB C2760466
U8: TLV803EA26DBZR; SOT-23; MPN TLV803EA26DBZR; JLCPCB C1852119

Connections:
+3V0: C18.1, C19.1, R18.1, R20.1, R22.1, R24.2, U7.8 (VCC), U8.3 (VDD); also elsewhere on the board
CHG_ALLOW_H: Q1.1 (G), Q2.3 (D), R22.2, R23.1, U7.1 (OUTA), U7.7 (OUTB), U8.2 (nRESET); also elsewhere on the board
CHG_CE_N: Q1.3 (D); also elsewhere on the board
CHG_INHIBIT: Q2.1 (G), R24.1; also elsewhere on the board
GND: C18.2, C19.2, Q1.2 (S), Q2.2 (S), R19.2, R21.2, R23.2, U7.4 (GND), U8.1 (GND); also elsewhere on the board
NTC_REF_COLD: R20.2, R21.1, U7.5 (INB+)
NTC_REF_HOT: R18.2, R19.1, U7.2 (INA-)
NTC_TS: U7.3 (INA+), U7.6 (INB-); also elsewhere on the board

Notes on the sheet:
INDEPENDENT BATTERY NTC WINDOW - REVIEW DRAFT
NTC103AT-2 /10k B3435 must be on CELL. No10k bypass resistor is permitted.
P1.14 HIGH/HiZ/reset=inhibit via Q2; LOW releases to hardware window.
U8 holdsALLOWlow during reference startup. See tolerance calculation and tests.
Pack acceptance: R0C>=24k, R45C<=5.20k, monotonic. Physical qualification required.

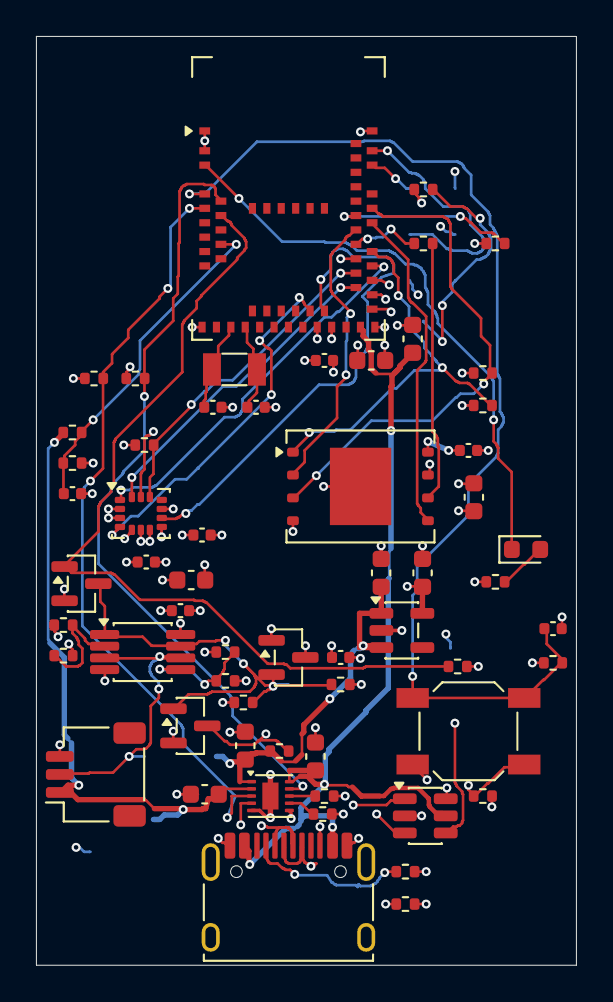
[picture p28: board Ankle_Sensor_V1.kicad_pcb from above]

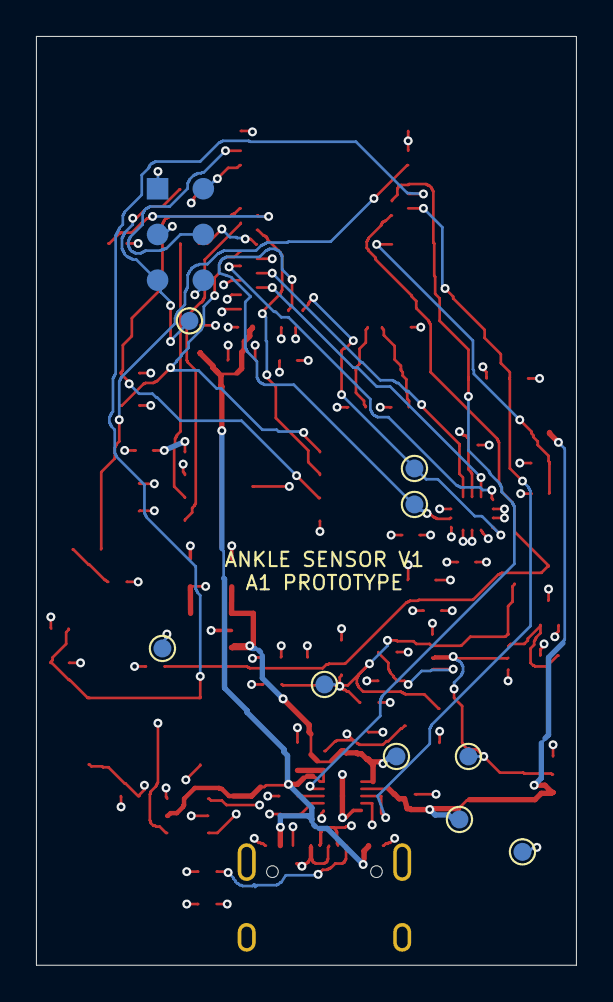
[picture p29: board Ankle_Sensor_V1.kicad_pcb from below]

Board: 4 copper layers, 30.0 x 51.6 mm, 69 parts (10 on the bottom side), 44 nets.
