TomKuc/ASV1/(notices)

Notices in the files:
hardware/3dmodels/Texas_DLH0010A_WSON-10-1EP_2.2x2mm_P0.4mm_EP0.9x1.5mm.step:
Copyright (C) 2025, KiCAD
This work is licensed under the
[Creative Commons CC-BY-SA 4.0 License](https://creativecommons.org/licenses/by-sa/4.0/legalcode),
with the following exception:
project files under this or any other license agreement. However, if you wish to distribute
